eldarro/radio-isotope-vuv-light-source/Photos/IMG_1511.JPG

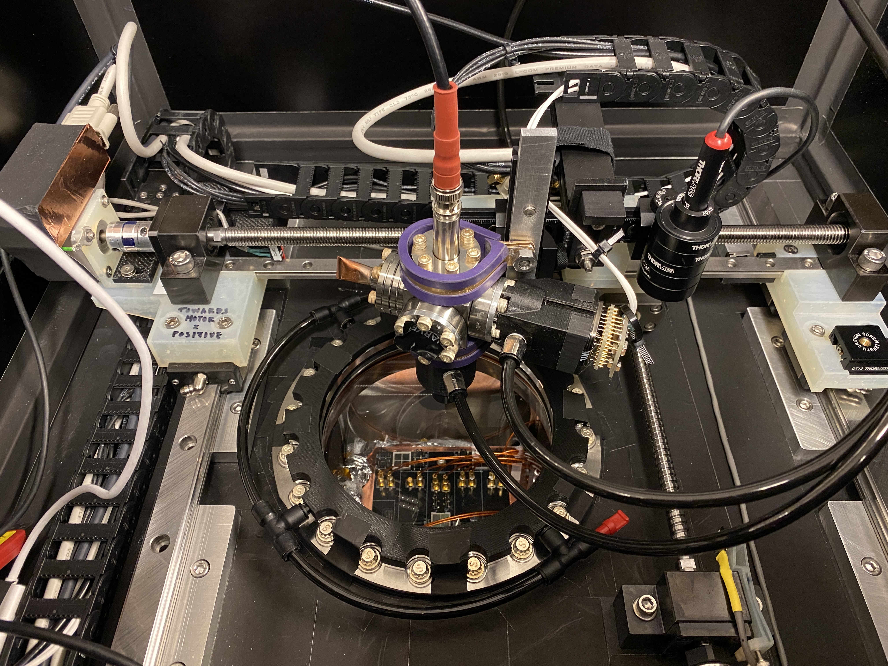
Photos/IMG_1511.JPG
