eldarro/radio-isotope-vuv-light-source/Gd-Source/documents/Report SEALED SOURCES -corrected- 15.02.23.pdf

Sealed Sources with current activity greater than 0MBq and received between 1/1/2000 and 2/14/202

3

McGill University | Environmental Health & Safety
PI382 | Prof Thomas Brunner

Cf-252

Inventory # | Permit | Receipt Date | Receipt Activity (MBq) | Current Activity (MBq) | Leak Test
180821001
| | | Eckert Ziegler | Q4-579

AF-252-A2

2018-06-08 | 0.00333 R-00382
☐ ⁰.00097
Location: | Manufacturer: | Model: Manufacturer S/N:

181025000
Eckert Ziegler | Q8-368

AF-252-A2

2018-10-25 | 0.00370 R-00382
☐ ⁰.00119
Location: | Manufacturer: | Model: Manufacturer S/N:

### Count of Sealed Sources for this Isotope:

2

Gd-148

Inventory # | Permit | Receipt Date | Receipt Activity (MBq) | Current Activity (MBq) | Leak Test
230202000
| | | Eckert Ziegler | V7-180

A-2

2023-02-01 | 0.00444 R-00382
☐ ⁰.00444
Location: | Manufacturer: | Model: Manufacturer S/N:

### Count of Sealed Sources for this Isotope:1

Po-210

Inventory # | Permit | Receipt Date | Receipt Activity (MBq) | Current Activity (MBq) | Leak Test
190815006
IAEA | NSPO210 NSPO210
2019-08-15 | 0.00037 R-00382
☐ ⁰.00000
Location: | Manufacturer: | Model: Manufacturer S/N:

### Count of Sealed Sources for this Isotope:1

Sr-90

Inventory # | Permit | Receipt Date | Receipt Activity (MBq) | Current Activity (MBq) | Leak Test
190815007
IAEA | NSSR90 NSSR90
2019-08-15 | 0.00037 R-00382
☐ ⁰.00034
Location: | Manufacturer: | Model: Manufacturer S/N:

### Count of Sealed Sources for this Isotope:1

Rev. 20120403 | | Total Count of Sealed Sources for All Isotopes:5
Printed on 2023-02-15 | Page 1 of 1
