eldarro/radio-isotope-vuv-light-source/Gd-Source/documents/IPL Form483_End Use Statement Rev I - CURRENT 11 AUG 2022.pdf

## END USE STATEMENT

IPL Form483 | Date Printed: 13-Sep-22
Revision: I | Page 1 of 2

NOTE: All lines must be completely filled in Roman letters and in English, wherever possible. No PO boxes; provide cross streets where only PO boxes are available.

### 1. CONSIGNEE / DISTRIBUTOR / IMPORTER INFORMATION (IF DIFFERENT FROM END USER)

NAME & JOB TITLE
(First Name, Middle Initial, Last Name)Joanna M. Boisvert
COMPANY NAME
Stuart Hunt & Associates Ltd.

## STREET ADDRESS 5949 Ambler Drive

VILLAGE / TOWN / CITY Mississauga

TELEPHONE 800-661-4591 | STATE / REGION / POSTAL CODE Ontario / L4W 2K2
FAX or E-MAIL sales@stuarthunt.com | COUNTRY Canada

## COMPANY WEBSITE www.stuarthunt.com

(if available)

### 2. END USER INFORMATION (PERSON WHO WILL BE USING THE PRODUCT)

NAME & JOB TITLE
(First Name, Middle Initial, Last Name)
COMPANY NAME | STREET ADDRESS
| VILLAGE / TOWN / CITY
TELEPHONE | STATE / REGION / POSTAL CODE
FAX or E-MAIL | COUNTRY
COMPANY WEBSITE
(if available)

### E & Z MODEL(S)/PRODUCT(S) ORDERED & INTENDED USE/APPLICATION

3.

4. - HAS AN IMPORT LICENSE BEEN REQUESTED? CHECK IF YES | AND ATTACH A COPY.
- HAS AN END USER FACILITY LICENSE BEEN REQUESTED? CHECK IF YES | AND ATTACH A COPY.

### - CHECK IF SOURCE (S) MAY BE RECEIVED EXEMPT AND AN IMPORT LICENSE IS NOT REQUIRED

### , PROVIDE THE CORRESPONDING REGULATION REFERENCE _________________________

### 5. STATEMENT OF END USER

In accordance with the terms of the contract, we confirm the following:
- We acknowledge that all end users must be checked against the restricted party lists, including, but not limited to, those issued by BISor OFAC; https://www.trade.gov/consolidated-screening-list.
- We will not distribute or re-route goods to known denied entities and we understand that doing so without a BIS, OFAC, or NRC license could constitute a violation and the possible loss of the business relationship with Eckert & Ziegler.
- If required for countries of concern, we will provide Eckert & Ziegler an import license and / or facility license as applicable.
- We will provide Eckert & Ziegler all applicable licenses and permits upon request for auditing purposes.
- The goods will not be re-routed or exported to US embargoed countries unless specifically licensed: . The US embargoed countries include Cuba, Iran, Iraq, North Korea, Sudan, and Syria [Ref. US NRC 10 CFR 110.28].We will not sell or re-route byproduct material imported from the US or of US origin to Pakistan, nor any radioactive material imported from the US or of US origin to Russia without a US export license; as per the NRC’s Executive Branch Order suspending all exports of said radioactive material under the General License authority
[Ref.: US NRC Docket No. EA-20-044; NRC-2020-0095 and EA-22-038, NRC-2022-0112], respectively.
- We will not re-sell and/or re-export products containing Special Nuclear Material (plutonium, uranium-233, or uranium enriched in the isotopes uranium-233 or uranium-235) in countries classified under restricted destinations (Afghanistan, Andorra, Angola, Burma (Myanmar), Djibouti, India, Israel, Pakistan, South Sudan and Libya) unless specifically licensed [Ref. US NRC 10 CFR 110.29].
- The goods are properly licensed and approved for use at the address in Section 2 by the end-user.
- The goods will not be exported or re-exported to China General Nuclear (CGN) and / or its subsidiaries should they be subject to a presumption of denial per US Policy Framework on Civil Nuclear Corporation with China or unless specifically licensed [Ref.: US NRC 10
CFR 110].

## END USE STATEMENT

IPL Form483 | Date Printed: 13-Sep-22
Revision: I | Page 2 of 2
- The goods, or a replica of them will not be used for purposes associated with military, chemical, biological, or nuclear weapons, explosives, or missile production or for missiles capable of delivering such weapons.
- We understand that exports of goods for Military End Uses or to Military End Users to Belarus, the People’s Republic of China (including Hong Kong), Cambodia, Myanmar (Burma), Russia (including Ukraine-Crimea Region) and Venezuela, may require export licensing prior to distribution [Ref.: EAR 15 CFR 744.21 and 15 CFR 744.22]. We will contact Eckert & Ziegler, NRC, OFAC, or BIS should export licenses be needed.
- All of the facts contained in this statement are true and correct to the best of our knowledge. We do not know of any additional facts which would be inconsistent with the above. We shall promptly communicate with, and send a supplemental statement to Eckert & Ziegler, disclosing any changes which would contradict the facts or intentions set forth in this document, if these occur after it has been accepted by Eckert & Ziegler.
We understand that the “goods” subject to NRC, OFAC, and BIS export regulations include, but are not limited to, radioactive materials, sealed sources, technology, confidential information, drawings, equipment, product development, and other products or services not specifically stated in this document but may be part of the contractual agreement.
PRINT NAME and SIGNATURE OF END USER / END USER LEGAL REPRESENTATIVE

DATE:
