eldarro/radio-isotope-vuv-light-source/Gd-Source/documents/QT-44482-1.pdf

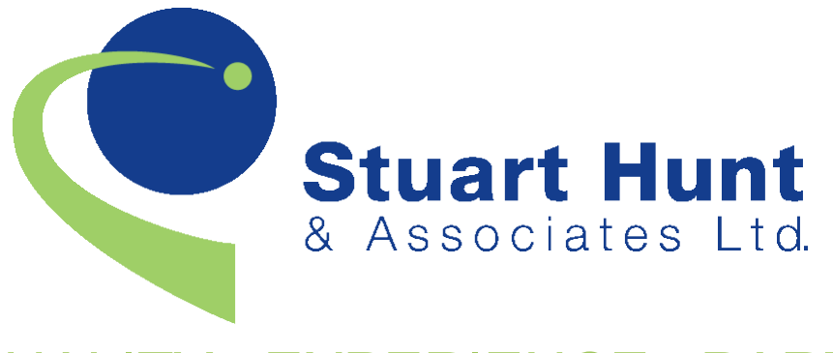
[picture p27: figure]

## QUALITY ∙ EXPERIENCE ∙ PARTNERSHIPS

To: Thomas Brunner | Prepared by: | Donna Akinola
McGill University | Email: donna.akinola@stuarthunt.com
McGill Hazardous Waste Managem 3655 Sir William Osler, Rm 129 Montreal, QC H3G 1Y6 | Phone: | 800-661-4591 ext 231

## Radioactive Source Quote

Part No. | Description | Unit Price | Quantity | Extended
AF-148-A2 | Alpha Particle Standard - Type A2 | 5,884.00 | 1 | 5,884.00
| Gd-148 3.70 kBq ( 0.10 uCi ) Activity Tolerance: +30% / -30% Capsule: A1204-1 Type A2 Disk 12.7mm OD x 5mm AD Electroplated onto Platinum Surface, No Cover Calibrated, NIST Traceable
| | | Total: | $5,884.00

## Please note:

### - Estimated delivery: 8 Weeks ARO

## - FOB: Mississauga, ON

- Please provide a preferred courier and account number on your order for shipping the items listed above to your designated location from our warehouse. Prepaid shipping is available upon request; the cost of shipping will then be added to your invoice.

### - Quote is in Canadian Dollars

- The End User’s name, contact information and intended use of the sources quoted is required at the time that an order is placed.
- A current copy of your CNSC license is required along with the purchase order.
- All sales are final and no item can be returned for credit unless the customer has demonstrated that the product does not meet the specifications set forth in the purchase order. For isotope products that are subject to radiation decomposition of 1% or more per month, or which possess half-lives of 90 days or less, claims must be made not later than 14 days from the delivery date.
- Please refer to attached Terms & Conditions for details.

Stuart Hunt & Associates Ltd. will undertake to provide the service described above for the price(s) presented in accordance with the Terms & Conditions attached to this quotation. Applicable taxes have not been included with the above quoted price. The price(s) are in Canadian dollars and will be honoured until the specified expiry date.

# Quotation No: QT-44482/1

## Quotation Date: October 17, 2022 Expiration date: November 16, 2022

## Terms and Conditions

Applicability

An order placed for instrumentation shall be subject to these Terms and Conditions to the exclusion of all other Conditions, including any terms or conditions which the Client purports to apply under any purchase order, confirmation of order, specification or other document).
Each order for instrumentation by the Client shall be on an Order Form and shall be deemed to be an offer by the Client to purchase instrumentation subject to these Conditions.
In the event the required quantity or make/model changes, a re-quotation by Stuart Hunt & Associates Ltd. will be delivered to the Client to address the change.
Pricing and Payment
Payment in advance is required for all first time Clients. Payment may be made by VISA, MasterCard, cheque, bank draft or wire transfer. Work will not commence until payment is received.
Credit terms are available to Canadian customers to enable payment by purchase order payable through invoicing, which requires completion of a short, no-fee credit application.
For Clients with approved credit, payment of the price for the Goods is due within 30 days of the invoice date. A purchase order, accepted credit card or other method of payment is required before work can proceed.
Customers in Canada are charged applicable taxes.
Applicable taxes have not been included with the above quoted price. Stuart Hunt and Associates' GST Registration Number is R105049225. Prices are subject to change under exceptional circumstances including manufacturer price changes and foreign exchange fluctuations. Every effort will be made to honour pricing as quoted. Stuart Hunt & Associates is not responsible for typographical or stenographic errors and we reserve the right to not accept any orders found to contain errors.
Supply of Service
No order placed by the Client shall be deemed to be accepted by Stuart Hunt & Associates Ltd. until a written acknowledgement of the order is issued by Stuart Hunt & Associates Ltd.
An official purchase order is required to be received by Stuart Hunt & Associates Ltd. before any orders can be confirmed. Any orders remain unconfirmed until notified otherwise.
Quotations are given by Stuart Hunt & Associates Ltd. on the basis that no Contract shall come into existence until a written acknowledgement of order is issued by Stuart Hunt & Associates Ltd.
Stuart Hunt & Associates Ltd. will deliver the instrumentation ordered by the Client to the address for delivery specified in the Order Form. Any changes or additions to the Order or these Conditions must be agreed upon in writing between Stuart Hunt & Associates Ltd. and the Client.
Installation & Training
Unless otherwise stated, all installation and training is extra. Installation is only available on selected items and in selected locations. All costs are extra and must be quoted separately and in writing. Remote support is offered (by Stuart Hunt & Associates Ltd. or Manufacturer) for all items, based on phone, fax, or e-mail communications. If you have any questions, please contact the Stuart Hunt & Associates sales consultant for your region.

Delivery Times
Most items requiring calibration or configuration are built to order. This generally requires a delivery time of 45 days for Canadian orders. Some items, such as some supplies and parts, are carried in inventory and can usually ship within 1-3 business days. Stuart Hunt & Associates Ltd. is not responsible for production delays by the manufacturer or delays in shipping or border crossings. Every effort will be made to expedite the process. Express shipping is available at extra cost.
Shipping & Handling
All shipping and handling charges are extra unless specifically stated otherwise in writing.
FOB: Standard orders are shipped FOB Mississauga, Ontario. Other arrangements can be made, including insured shipments, for additional cost.
Shipping Method: All shipments (except drop shipments) are carefully inspected at Stuart Hunt & Associates. Domestic shipments are delivered via ground courier. A preferred courier and account number are required but pre-paid shipping is available and the cost will be added to the invoice. Please specify the shipping preference upon ordering.
Heavy shipments and dangerous goods are shipped domestically by truck, internationally by the most economical option available, or customer specified courier. Special Arrangements: Rush shipments and insurance are available at extra cost. Dangerous goods and heavy shipments may incur extra courier and/or crating fees.
Returns Policy
Products purchased from Stuart Hunt & Associates Ltd. can be returned up to 15 days from the date of shipment (subject to following conditions). Products must be returned as shipped, in like new condition with original packing materials, including manuals and accessories.
All products sold through Stuart Hunt & Associates are sold to the specifications shown in the product description. Stuart Hunt & Associates is under no obligation to accept returns on products that meet the published specifications.
No returns or credits are permitted on custom manufactured or configured products.
Returns Process for Equipment
All returns must be authorized in writing by Stuart Hunt & Associates. Call us for a Return Authorization Form. This form must be included with the returned goods. Returns must be shipped prepaid by the Client to Stuart Hunt & Associates FOB Mississauga, Ontario.
A minimum 15% restocking fee (more for some manufacturers) will be charged for all returns unless covered under warranty.
If any of these requirements are not met, delays or extra costs could be incurred. Stuart Hunt & Associates Ltd. does not take responsibility for these issues if caused by customer neglect, error or deviation from these policies.
Returns Policy for Radioactive Sources
Due to the nature of our products, all sales are final and no item can be returned for credit unless the customer has demonstrated that the product does not meet the specifications set forth in the purchase order. For most products, such a claim must be made within 21 days of the date of delivery of the item ("date of delivery" is defined as the shipment date indicated on the airway bill for the goods). For isotope products that are subject to radiation decomposition of 1% or more per month, or which possess half-lives of 90 days or less, claims must be made not later than 14 days from the delivery date.

Credit will be given for products that are found not meeting specifications. Stuart Hunt & Associates Ltd. will pay the return freight back to the manufacturer for materials found not meeting specifications, as well as freight for replacement products.

Damaged Items
All instruments are packaged carefully at Stuart Hunt & Associates for return shipment. For goods received in a damaged condition by the delivery company, please follow this procedure:
1. Note the damage to the delivery driver and immediately report the damage to the delivery company.
2. Keep all original packaging materials for inspection and possible repackaging.
3. Report the damage to Stuart Hunt & Associates Ltd. in writing within 2 days of receipt and provide a copy of carrier’s report of damage when available.
4. Some shipments may have carrier insurance. Claims are contingent upon the above procedures being followed Warranty and Limitation on Liability
All products sold through Stuart Hunt & Associates are inspected through quality control by the manufacturer and again for damage and basic functionality at Stuart Hunt & Associates. If a product should fail to function properly within the manufacturer’s warranty period, please contact us. The representative for your region will advise you on how to proceed. Depending on the assessment, this could include any of:
1. On-site repair
2. Returning the item for repair
3. Replacement of the item
4. Possible loaner unit during the repair
The solution will depend upon the manufacturer’s policies, the location of the customer, plus the size, weight and type of product.
Stuart Hunt & Associates Ltd. shall have no liability to the Client for any failure to deliver the instrumentation or any delay in doing so that is caused by an event or circumstance beyond Stuart Hunt & Associates Ltd. reasonable control including, without limitation, strikes, lock-outs and other industrial disputes, travel disruption, or accident.
Stuart Hunt & Associates Ltd. warranties and services extend to the Client and to no other person or entity. Stuart Hunt & Associates Ltd. has no duty or obligation to provide services that it has not expressly agreed in writing to provide.
Invalidity
If any of these Conditions (or part of any of these Conditions) is unenforceable (including any provision in which Stuart Hunt & Associates Ltd. excludes its liability to the Client) the enforceability of the remaining Conditions (or remaining part of any Condition) will not be affected.
Waiver
In the event of any default or breach by the Client, Stuart Hunt & Associates Ltd. has the right, among other rights, to refuse to provide additional services to the Client. Stuart Hunt & Associates Ltd. failure to enforce at any time or for any period of time any provisions of these Terms and Conditions shall not constitute a waiver of such provisions or of the right of Stuart Hunt & Associates Ltd. to enforce each and every such provision.
