eldarro/radio-isotope-vuv-light-source/lenses.png

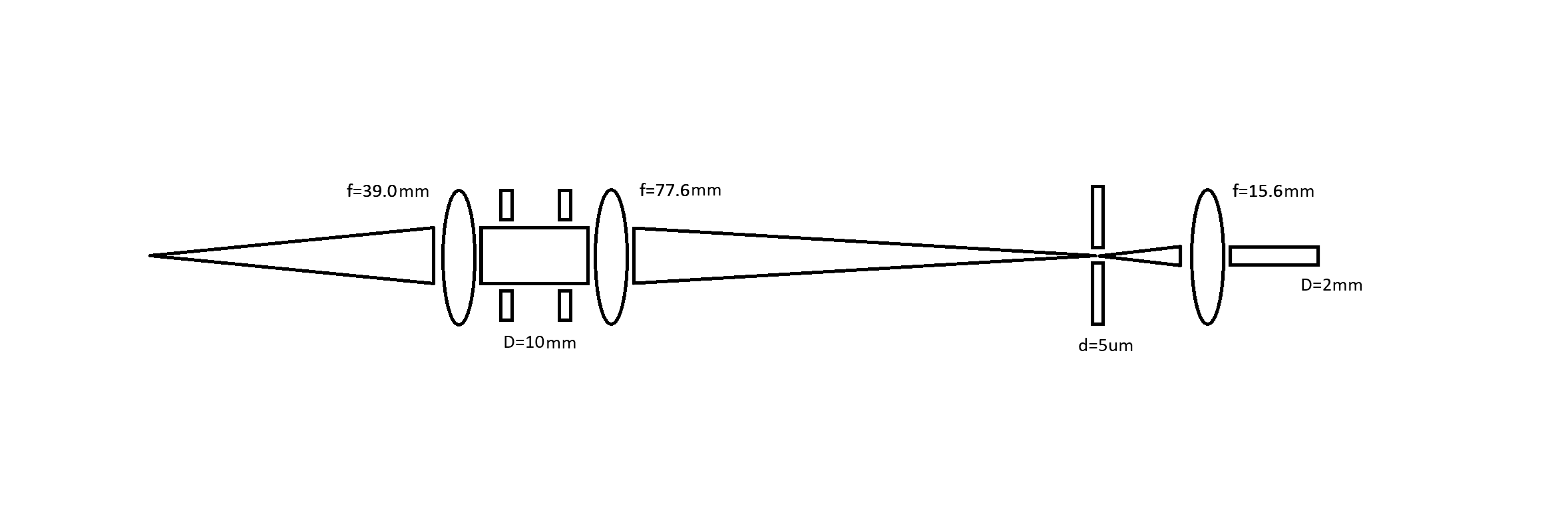
lenses.png
