eldarro/radio-isotope-vuv-light-source/Photos/IMG_1506.JPG

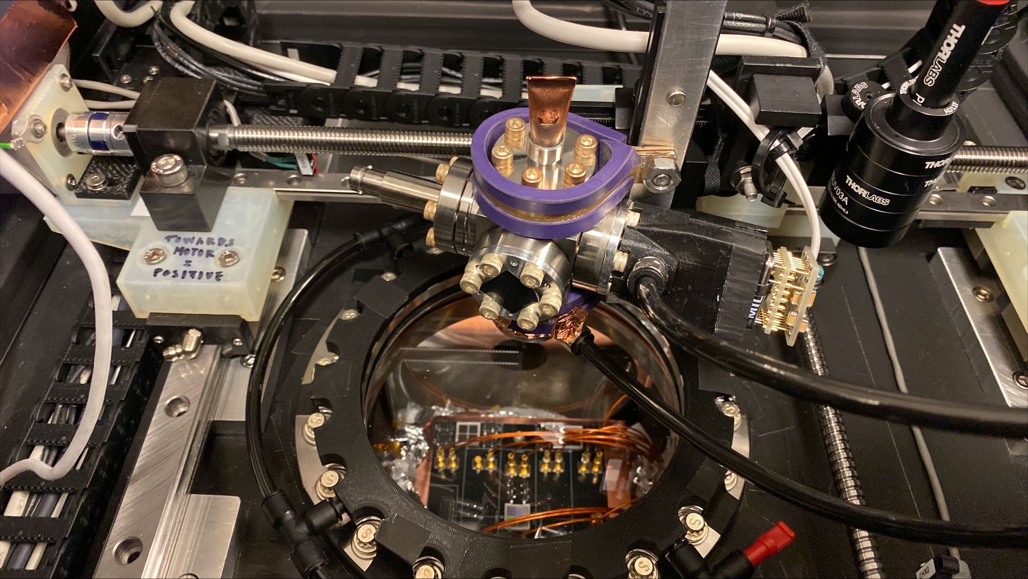
Photos/IMG_1506.JPG
