eldarro/radio-isotope-vuv-light-source/Photos/IMG_1510.JPG

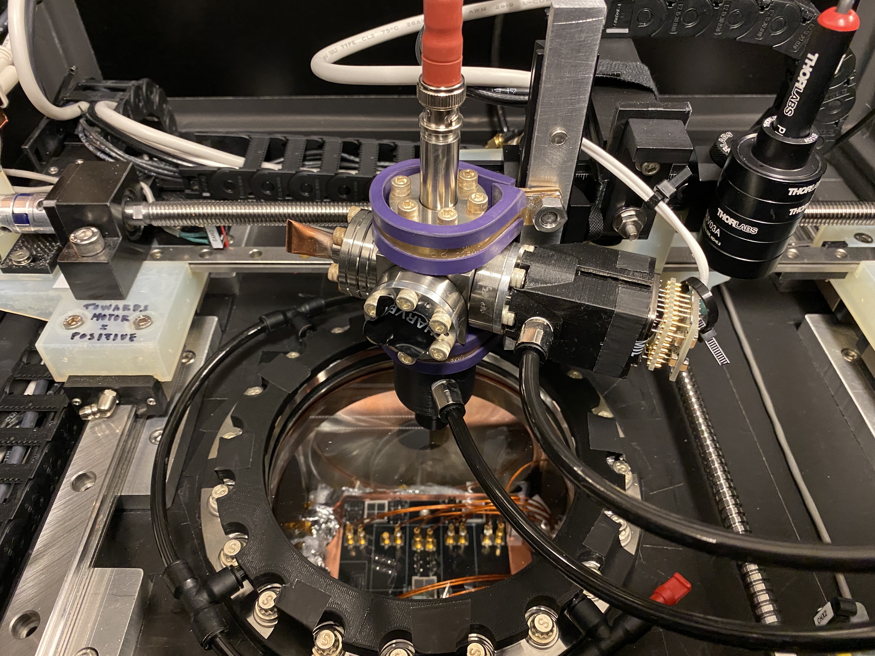
Photos/IMG_1510.JPG
