eldarro/radio-isotope-vuv-light-source/Photos/IMG_1512.JPG

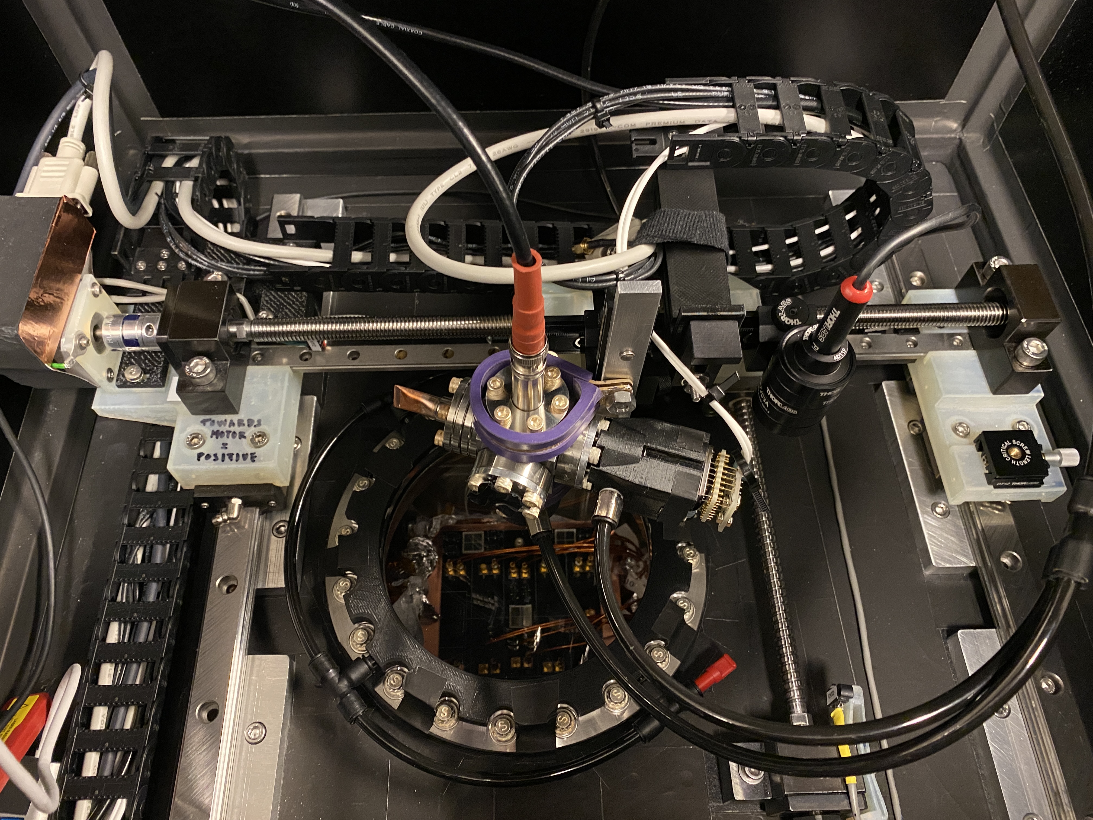
Photos/IMG_1512.JPG
