eldarro/radio-isotope-vuv-light-source/spatial_filter.png

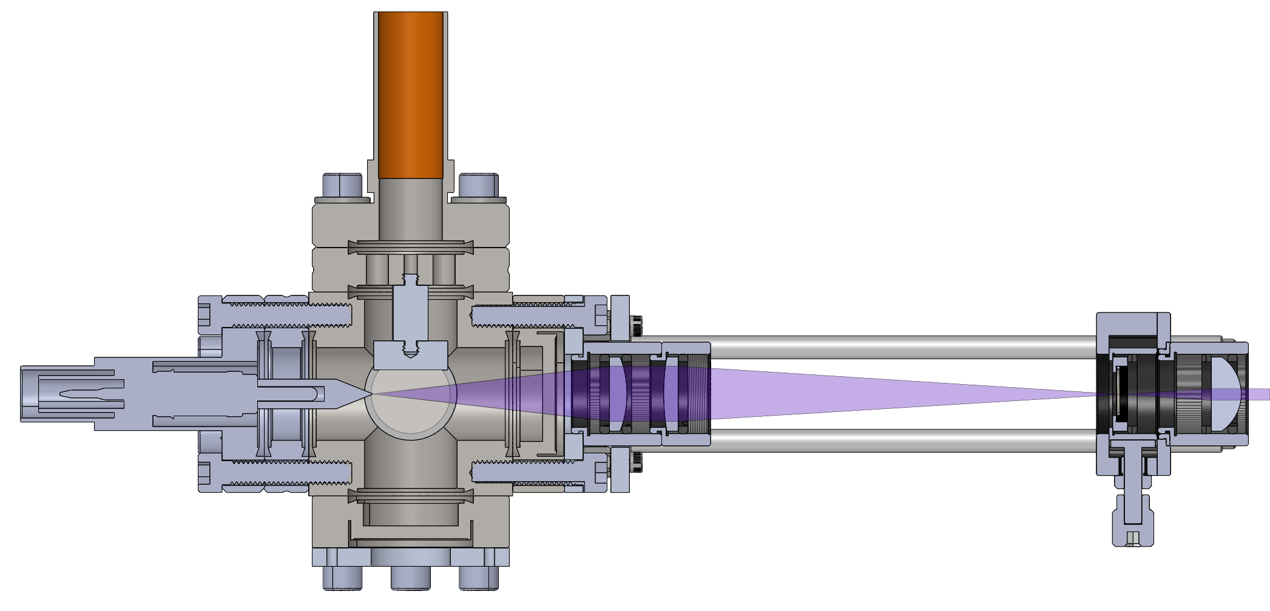
spatial_filter.png
