eldarro/radio-isotope-vuv-light-source/Gd-Source/CAD/GDLS/GDLS08.SLDASM

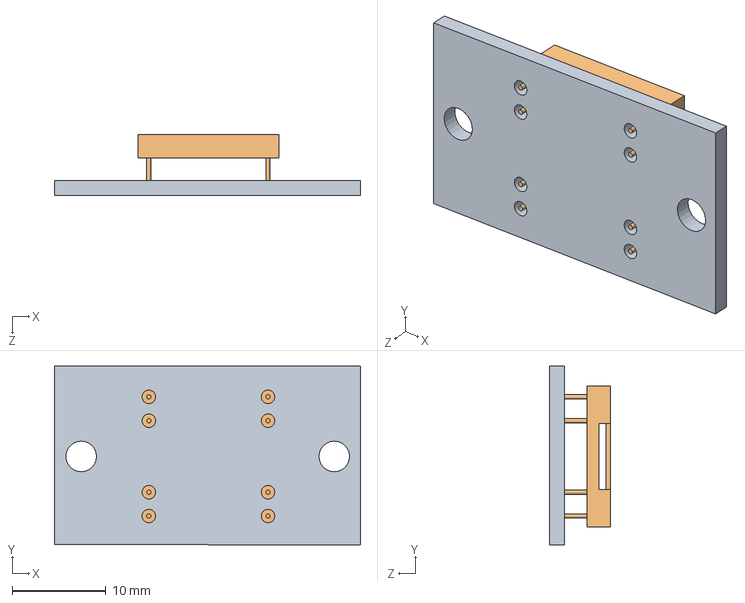
[picture p33: CAD file, 2026-06-09]
Gd-Source/CAD/GDLS/GDLS08.SLDASM
32.6 x 19.1 x 6.50 mm
GDLS034
GDLS022
