eldarro/radio-isotope-vuv-light-source/Gd-Source/CAD/CFLS/CFLS0009.SLDASM

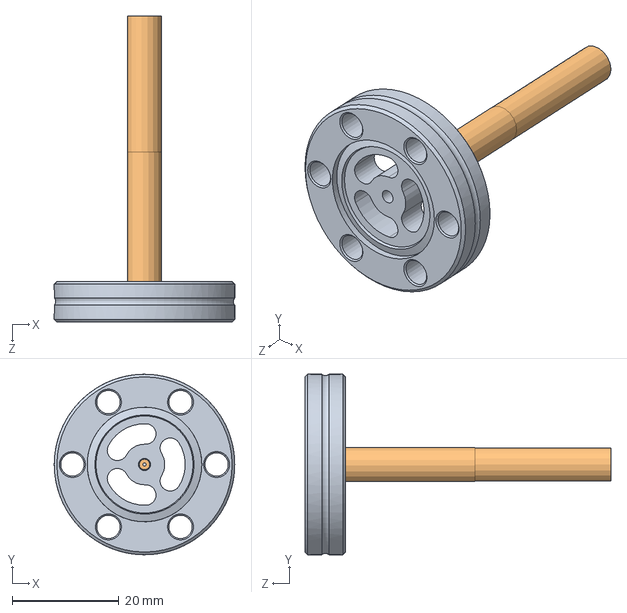
[picture p34: CAD file, 2026-06-09]
Gd-Source/CAD/CFLS/CFLS0009.SLDASM
33.8 x 33.8 x 57.3 mm
CFLS0007
CFLS0008 x 2
