eldarro/radio-isotope-vuv-light-source/Gd-Source/SIM/CAD/GDSIM12.SLDASM

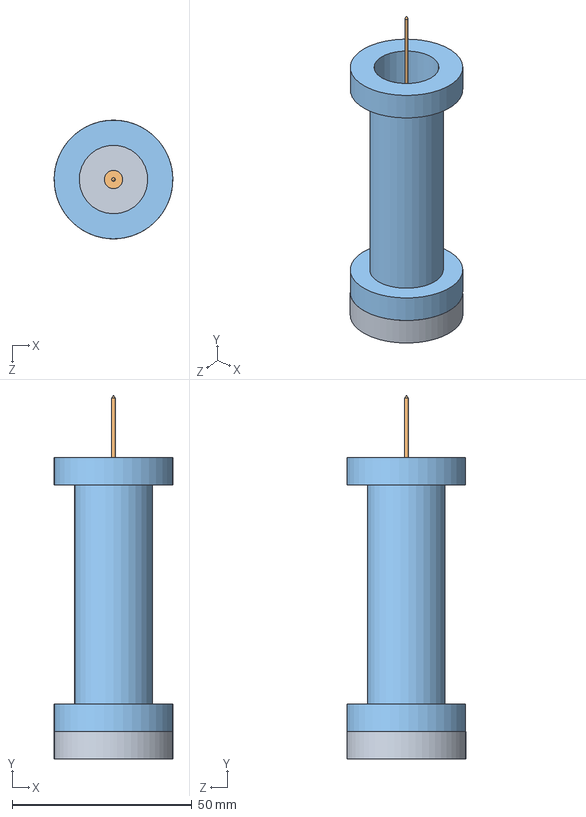
[picture p36: CAD file, 2026-06-09]
Gd-Source/SIM/CAD/GDSIM12.SLDASM
33.0 x 101.2 x 33.0 mm
GDSIM011
GDSIM014
GDSIM015
