eldarro/radio-isotope-vuv-light-source/Gd-Source/CAD/CFLS/CFLS0000.SLDASM

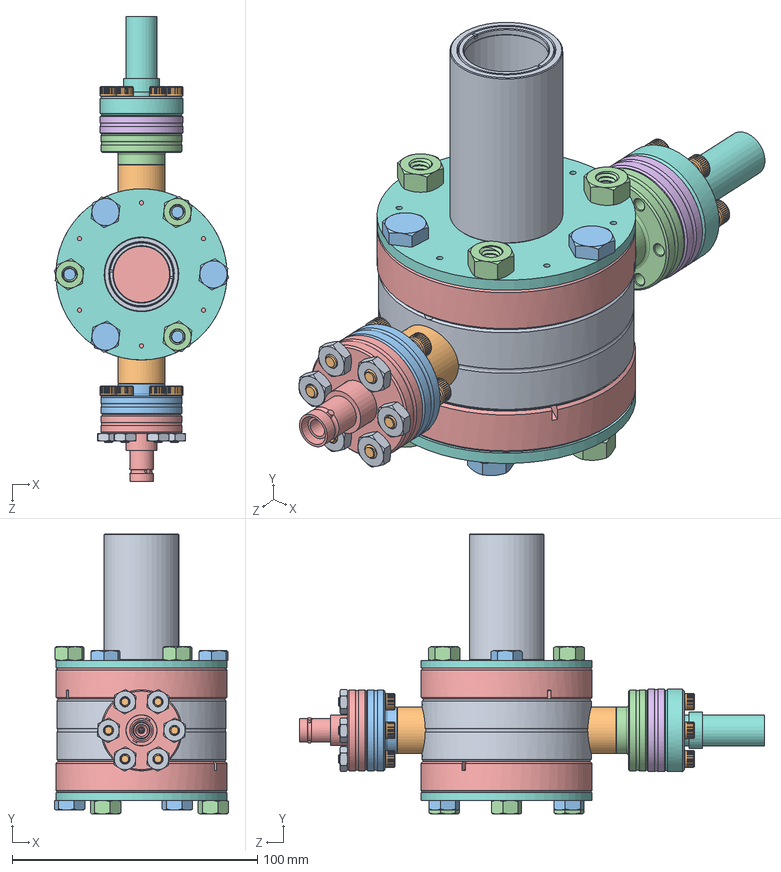
[picture p37: CAD file, 2026-06-09]
Gd-Source/CAD/CFLS/CFLS0000.SLDASM
71.2 x 114.3 x 189.9 mm
CFLS0002
CFLS0003 x 2
CFLS0004
CFLS0005
CFLS0006
CFLS0007
CFLS0008 x 2
CFLS0017
CFLS0018 x 6
CFLS0019 x 12
CFLS0021 x 6
CFLS0022 x 6
CFLS0023 x 2
CFLS0025
CFLS0024
CFLS0026 x 2
CFLS0027
