eldarro/radio-isotope-vuv-light-source/Gd-Source/CAD/GDLS/GDLS07.SLDASM

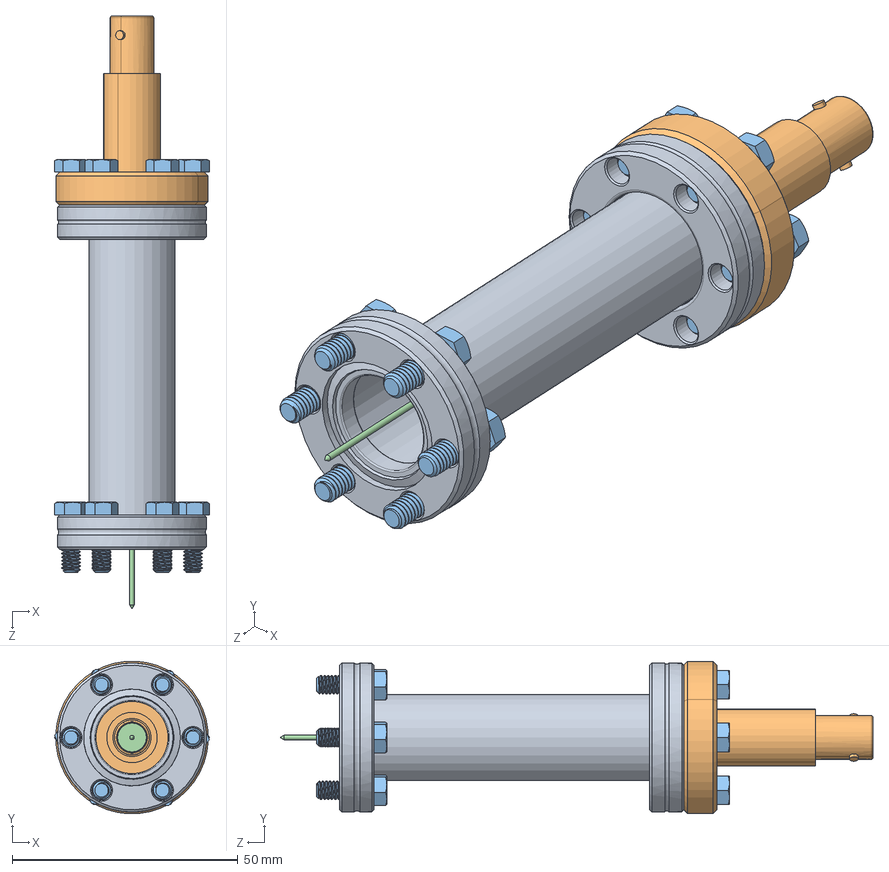
[picture p38: CAD file, 2026-06-09]
Gd-Source/CAD/GDLS/GDLS07.SLDASM
34.3 x 33.7 x 131.2 mm
GDLS030
GDLS008
GDLS025 x 12
GDLS031
