eldarro/radio-isotope-vuv-light-source/Gd-Source/SIM/CAD/GDSIM10.SLDASM

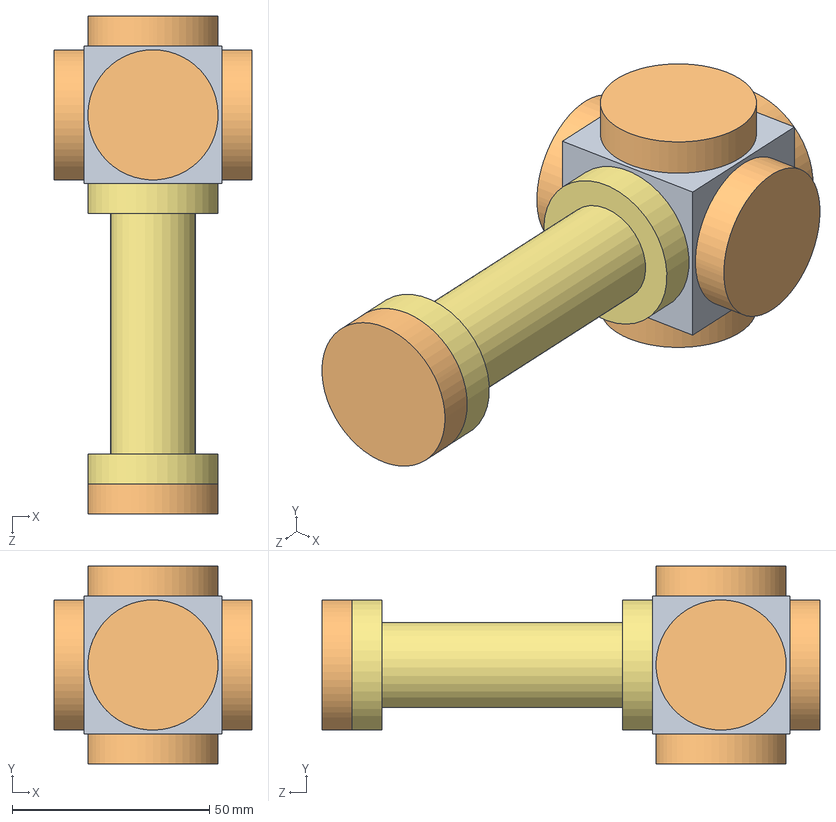
[picture p39: CAD file, 2026-06-09]
Gd-Source/SIM/CAD/GDSIM10.SLDASM
50.2 x 50.2 x 126.4 mm
GDSIM010
GDSIM011 x 6
GDSIM016
GDSIM012
GDSIM013
GDSIM014
GDSIM015
Part9^GDSIM10
