eldarro/radio-isotope-vuv-light-source/Gd-Source/SIM/CAD/Assem2.SLDASM

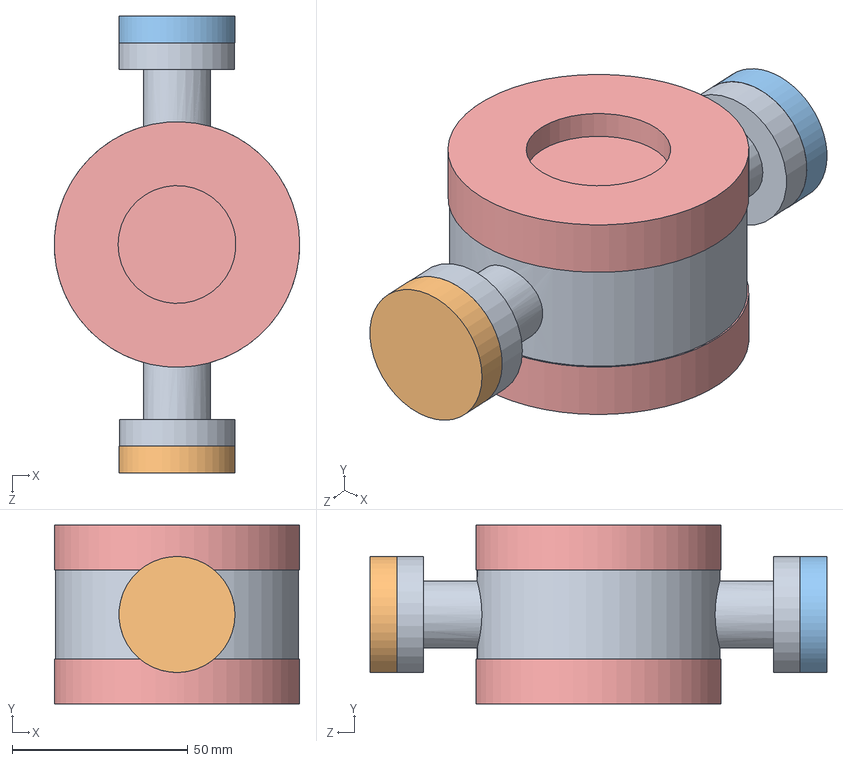
[picture p41: CAD file, 2026-06-09]
Gd-Source/SIM/CAD/Assem2.SLDASM
69.8 x 50.8 x 130.0 mm
GDSIM001
GDSIM002
GDSIM003
GDSIM007
GDSIM005 x 2
Part1^Assem2
