eldarro/radio-isotope-vuv-light-source/Gd-Source/CAD/GDLS/GDLS04.SLDASM

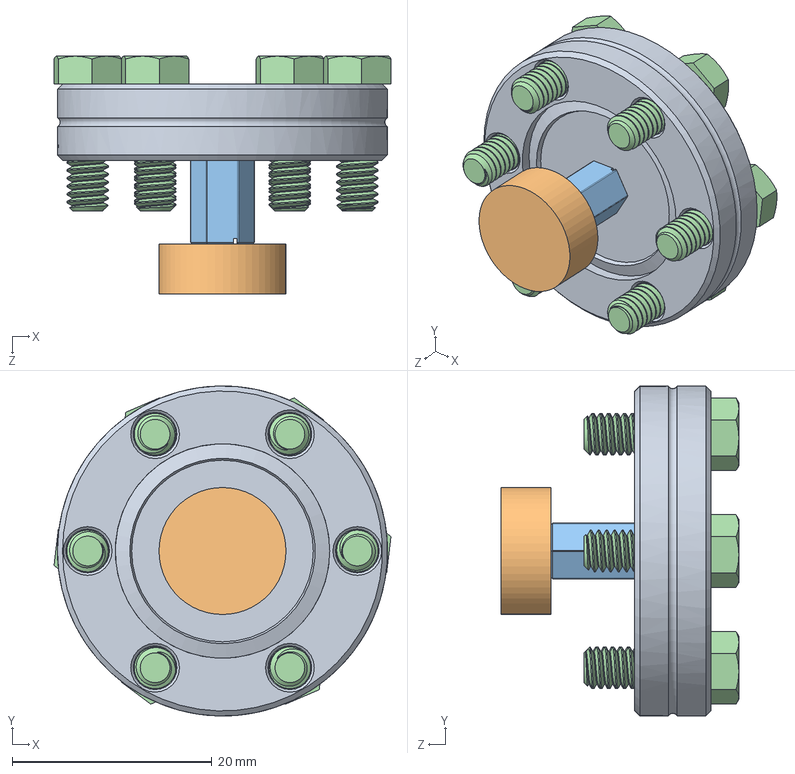
[picture p42: CAD file, 2026-06-09]
Gd-Source/CAD/GDLS/GDLS04.SLDASM
33.7 x 33.0 x 23.8 mm
GDLS010
GDLS011
GDLS012
GDLS025 x 6
