eldarro/radio-isotope-vuv-light-source/Gd-Source/SIM/CAD/GDSIM20.SLDASM

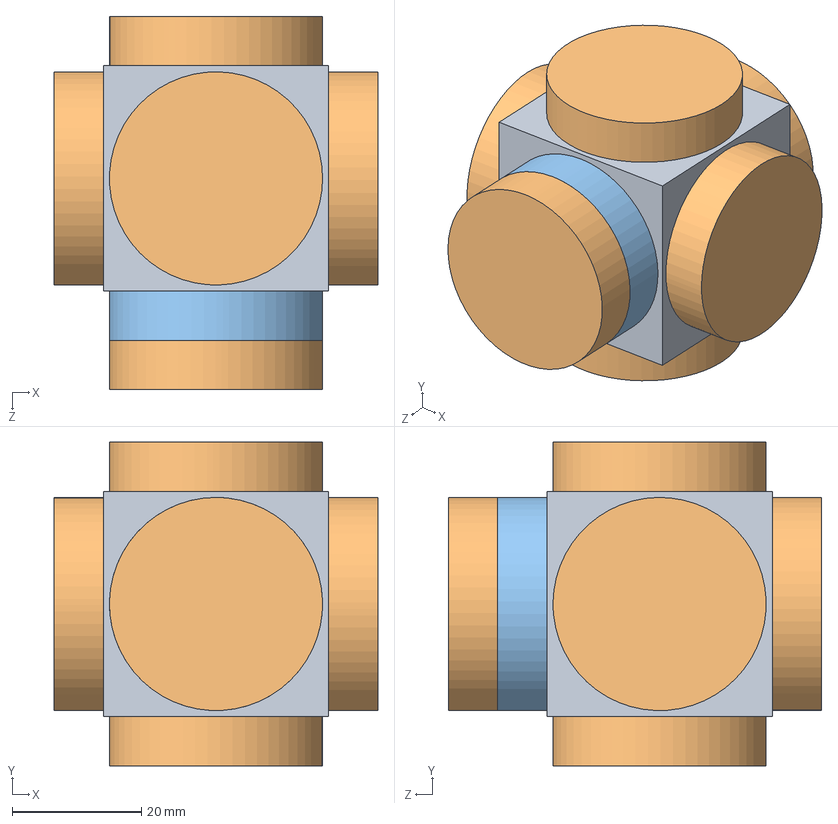
[picture p43: CAD file, 2026-06-09]
Gd-Source/SIM/CAD/GDSIM20.SLDASM
50.2 x 50.2 x 57.8 mm
GDSIM010
GDSIM011 x 6
GDSIM017
GDSIM018
GDSIM019
GDSIM012
GDSIM013
GDSIM016
Part3^GDSIM20
