eldarro/radio-isotope-vuv-light-source/Gd-Source/CAD/CFLS/CFLS0010.sldasm

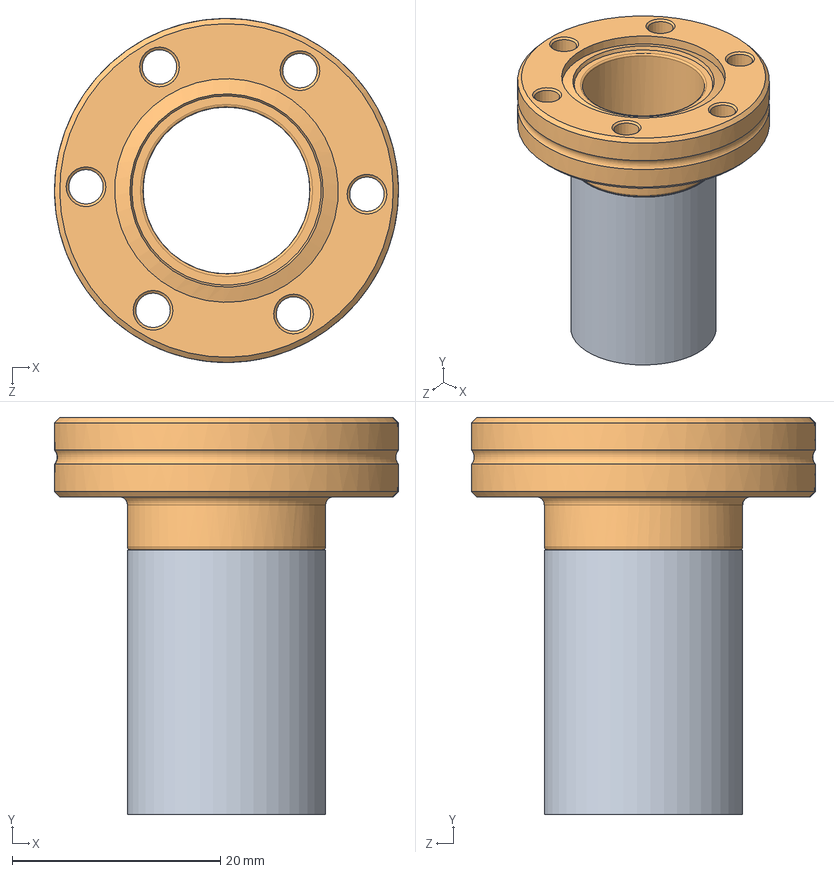
[picture p44: CAD file, 2026-06-09]
Gd-Source/CAD/CFLS/CFLS0010.sldasm
33.0 x 38.1 x 33.0 mm
CFLS0003
CFLS0005
