eldarro/radio-isotope-vuv-light-source/Gd-Source/SIM/CAD/GDSIM21.SLDASM

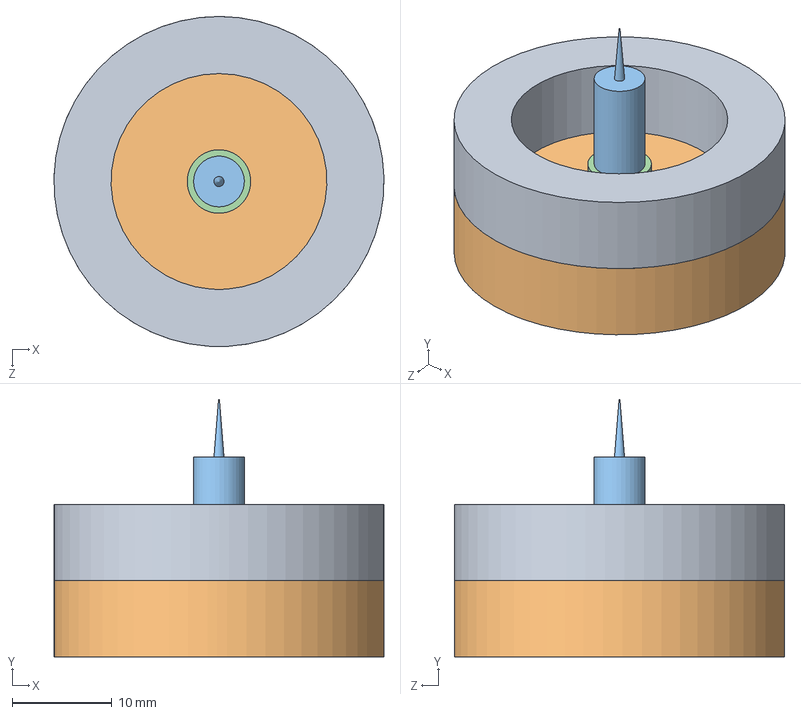
[picture p45: CAD file, 2026-06-09]
Gd-Source/SIM/CAD/GDSIM21.SLDASM
33.0 x 25.8 x 33.0 mm
GDSIM017
GDSIM011
GDSIM018
GDSIM019
