eldarro/radio-isotope-vuv-light-source/Gd-Source/SIM/CAD/GDSIM11.SLDASM

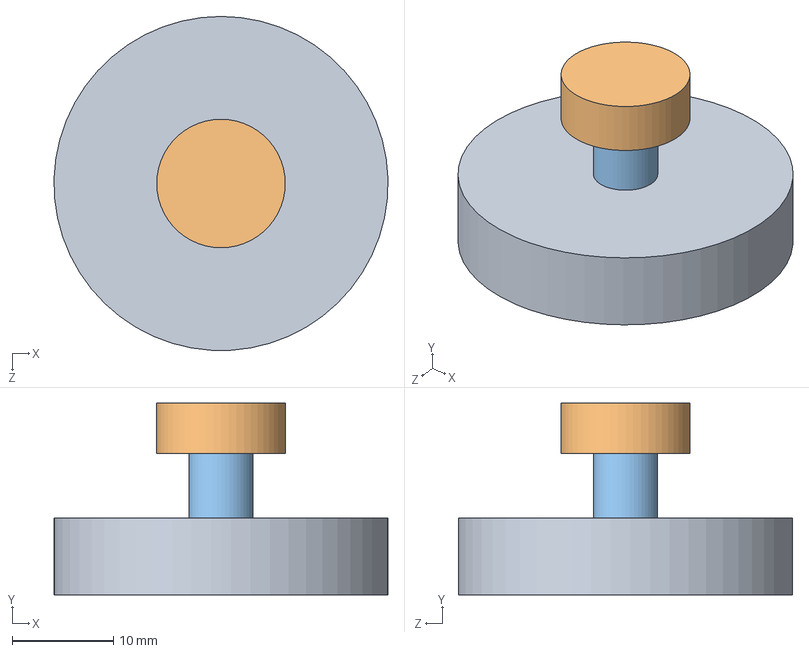
[picture p46: CAD file, 2026-06-09]
Gd-Source/SIM/CAD/GDSIM11.SLDASM
33.0 x 19.0 x 33.0 mm
GDSIM011
GDSIM012
GDSIM013
