eldarro/radio-isotope-vuv-light-source/Gd-Source/CAD/CFLS/CFLS0001.sldasm

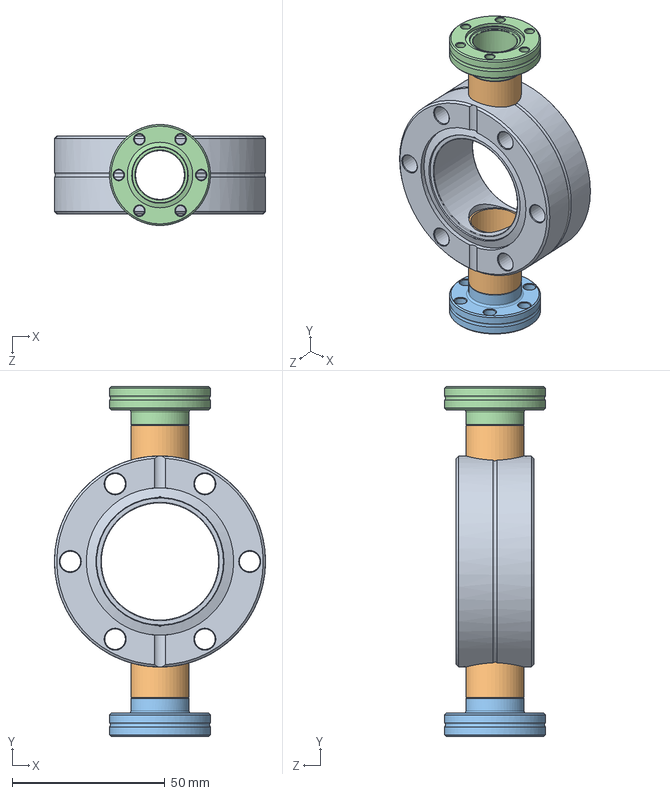
[picture p47: CAD file, 2026-06-09]
Gd-Source/CAD/CFLS/CFLS0001.sldasm
69.1 x 114.6 x 33.0 mm
CFLS0002
CFLS0003 x 2
CFLS0004
CFLS0005
