eldarro/radio-isotope-vuv-light-source/Gd-Source/CAD/CFLS/CFLS00.SLDASM

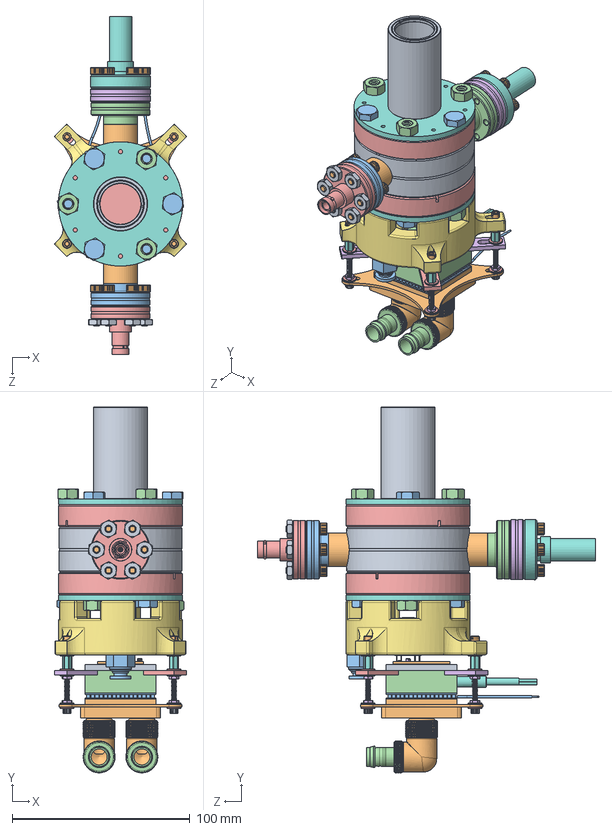
[picture p48: CAD file, 2026-06-09]
Gd-Source/CAD/CFLS/CFLS00.SLDASM
74.4 x 205.6 x 189.9 mm
CFLS0002
CFLS0003 x 2
CFLS0004
CFLS0005
CFLS0006
CFLS0007
CFLS0008 x 2
CFLS0017
CFLS0018 x 6
CFLS0019 x 12
CFLS0021 x 6
CFLS0022 x 6
CFLS0023 x 2
CFLS0025
CFLS0024
CFLS0026 x 2
CFLS0027
TEC016
TEC003
TEC019
TEC044
TEC036
TEC046 x 5
TEC011
TEC026
CAF022
TEC045 x 4
TEC041 x 4
TEC039 x 4
TEC040
TEC017 x 2
TEC024 x 20
TEC010 x 8
GDLS028 x 5
