eldarro/radio-isotope-vuv-light-source/Gd-Source/CAD/GDLS/GDLS05.SLDASM

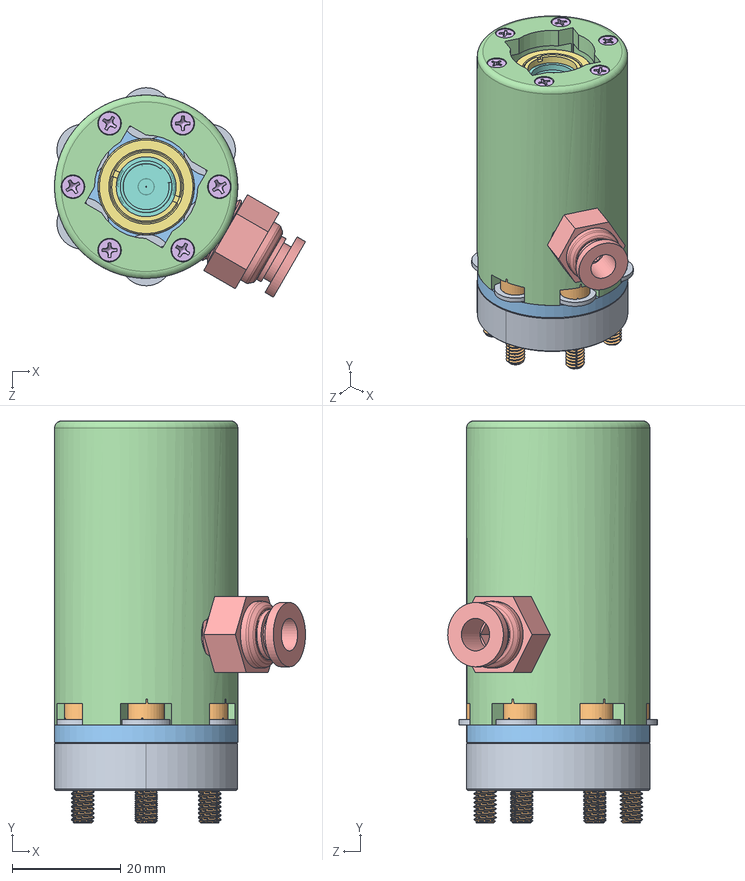
[picture p49: CAD file, 2026-06-09]
Gd-Source/CAD/GDLS/GDLS05.SLDASM
46.2 x 74.1 x 38.6 mm
GDLS002
GDLS044 x 6
GDLS003
GDLS033
GDLS020
GDLS028 x 6
GDLS036
GDLS005 x 2
GDLS045 x 6
