eldarro/radio-isotope-vuv-light-source/Gd-Source/CAD/GDLS/GDLS03.SLDASM

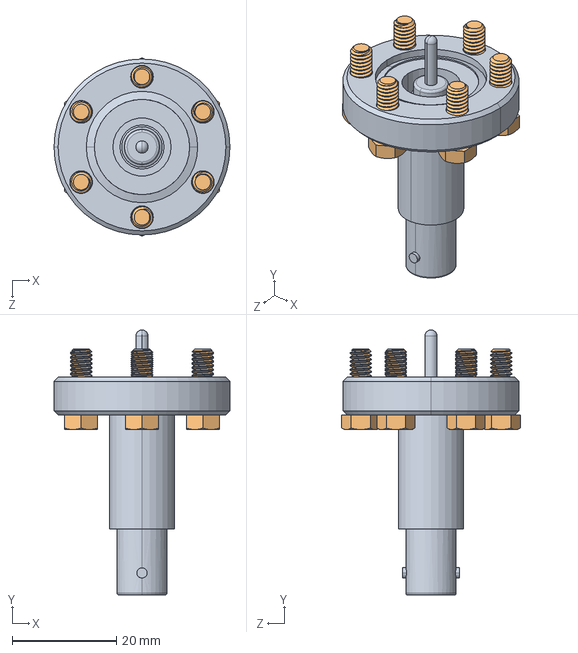
[picture p50: CAD file, 2026-06-09]
Gd-Source/CAD/GDLS/GDLS03.SLDASM
33.8 x 50.9 x 34.3 mm
GDLS008
GDLS025 x 6
