eldarro/radio-isotope-vuv-light-source/Gd-Source/CAD/GDLS/GDLS10.SLDASM

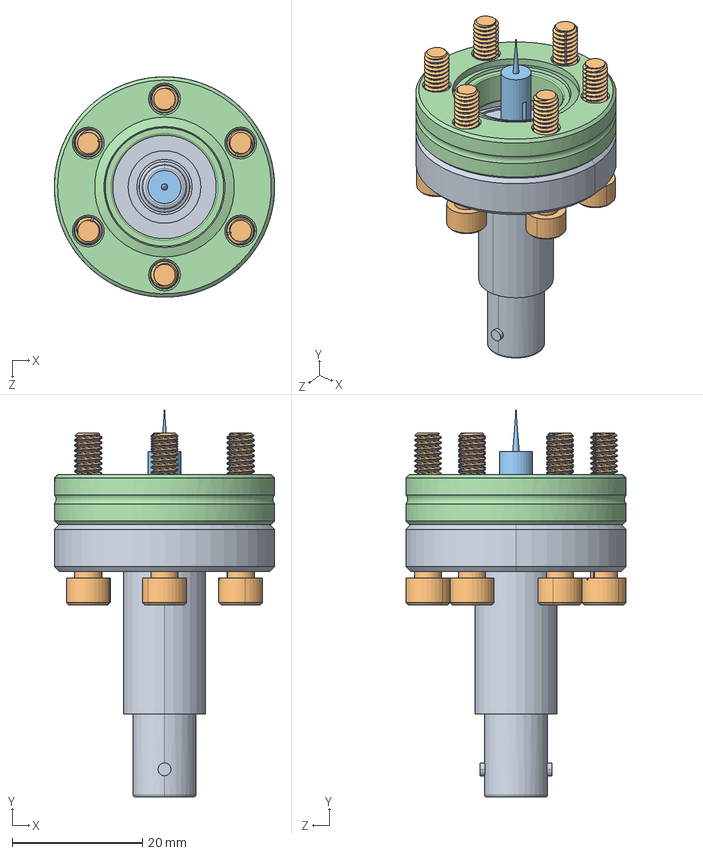
[picture p51: CAD file, 2026-06-09]
Gd-Source/CAD/GDLS/GDLS10.SLDASM
33.8 x 59.3 x 33.8 mm
GDLS039
GDLS043 x 6
GDLS040
GDLS041
