eldarro/radio-isotope-vuv-light-source/Gd-Source/CAD/GDLS/GDLS09.SLDASM

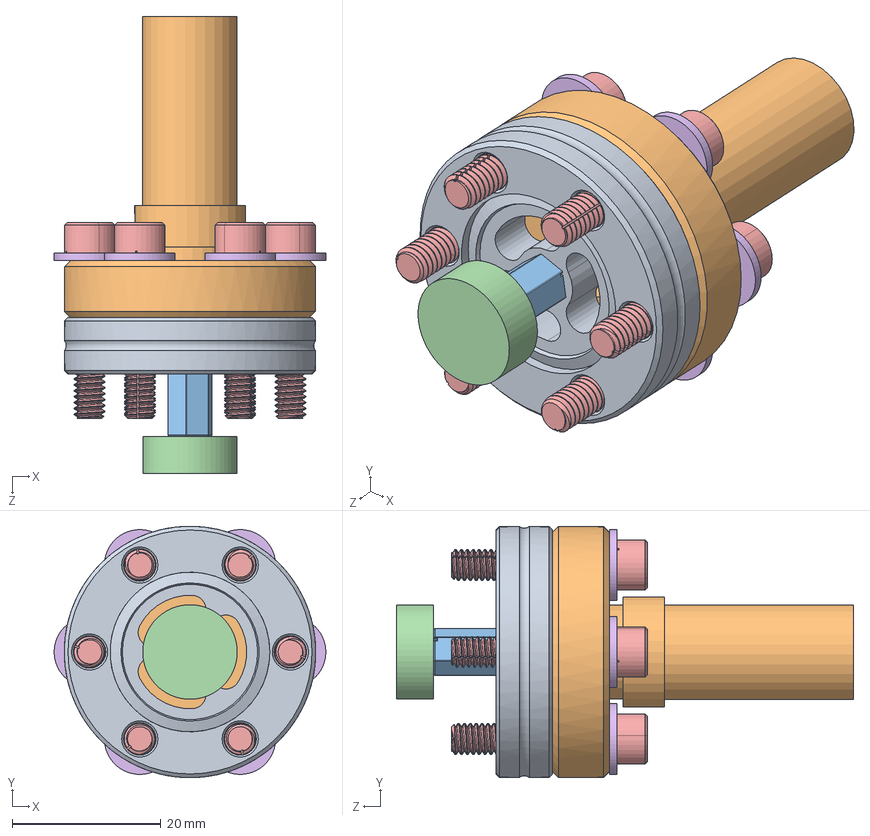
[picture p52: CAD file, 2026-06-09]
Gd-Source/CAD/GDLS/GDLS09.SLDASM
36.5 x 33.8 x 61.4 mm
GDLS035
GDLS009
GDLS012
GDLS011
GDLS043 x 6
GDLS045 x 6
