eldarro/radio-isotope-vuv-light-source/Gd-Source/CAD/GDLS/GDLS02.SLDASM

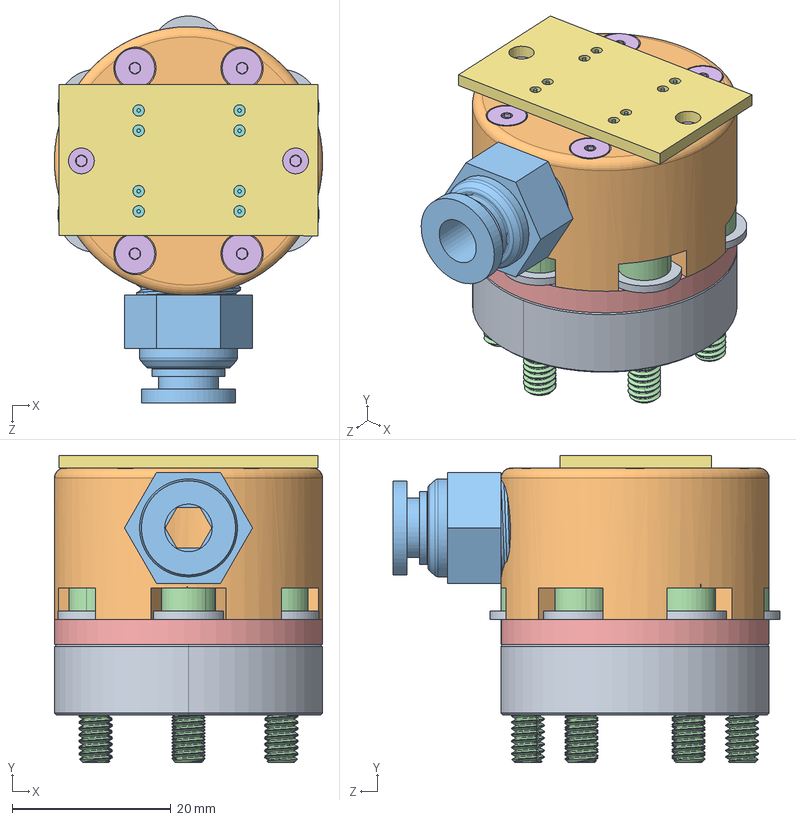
[picture p53: CAD file, 2026-06-09]
Gd-Source/CAD/GDLS/GDLS02.SLDASM
33.8 x 38.7 x 48.7 mm
GDLS002
GDLS019
GDLS020
GDLS044 x 6
GDLS003
GDLS026 x 6
GDLS034
GDLS022
GDLS045 x 6
