eldarro/radio-isotope-vuv-light-source/Gd-Source/CAD/GDLS/GDLS06.SLDASM

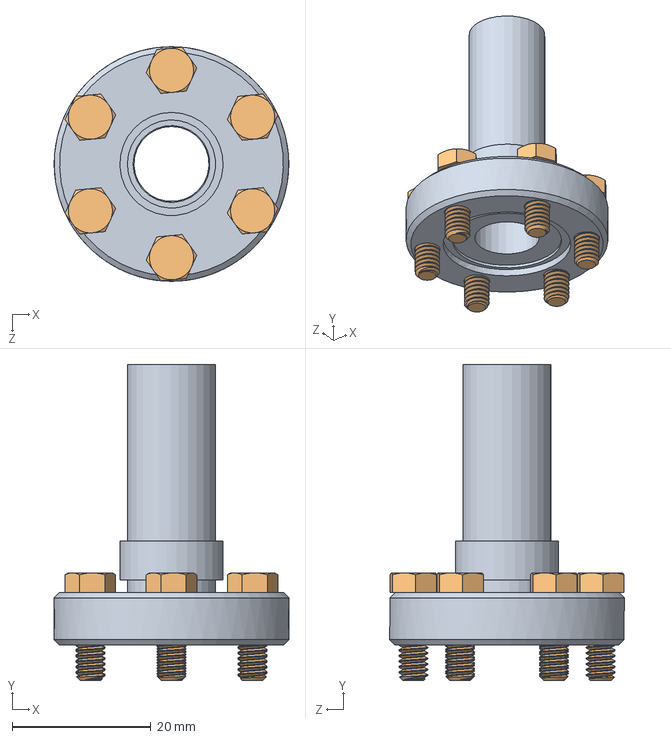
[picture p54: CAD file, 2026-06-09]
Gd-Source/CAD/GDLS/GDLS06.SLDASM
33.8 x 45.5 x 33.8 mm
GDLS009
GDLS025 x 6
