eldarro/radio-isotope-vuv-light-source/Gd-Source/CAD/GDLS/GDLS01.SLDASM

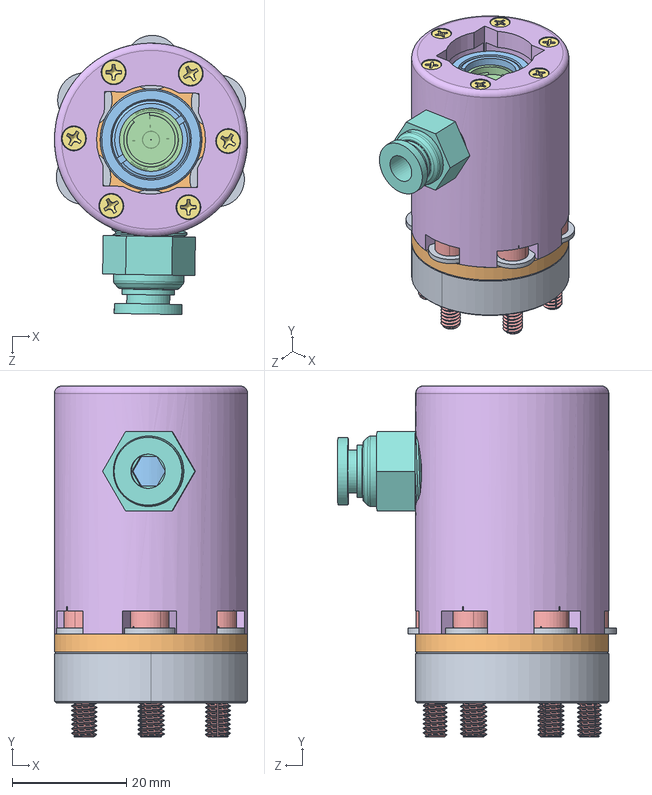
[picture p55: CAD file, 2026-06-09]
Gd-Source/CAD/GDLS/GDLS01.SLDASM
33.8 x 61.4 x 48.8 mm
GDLS002
GDLS003
GDLS037
GDLS006 x 2
GDLS044 x 6
GDLS027
GDLS028 x 6
GDLS020
GDLS045 x 6
