eldarro/radio-isotope-vuv-light-source/Gd-Source/CAD/CFLS/CFLS0025.SLDPRT

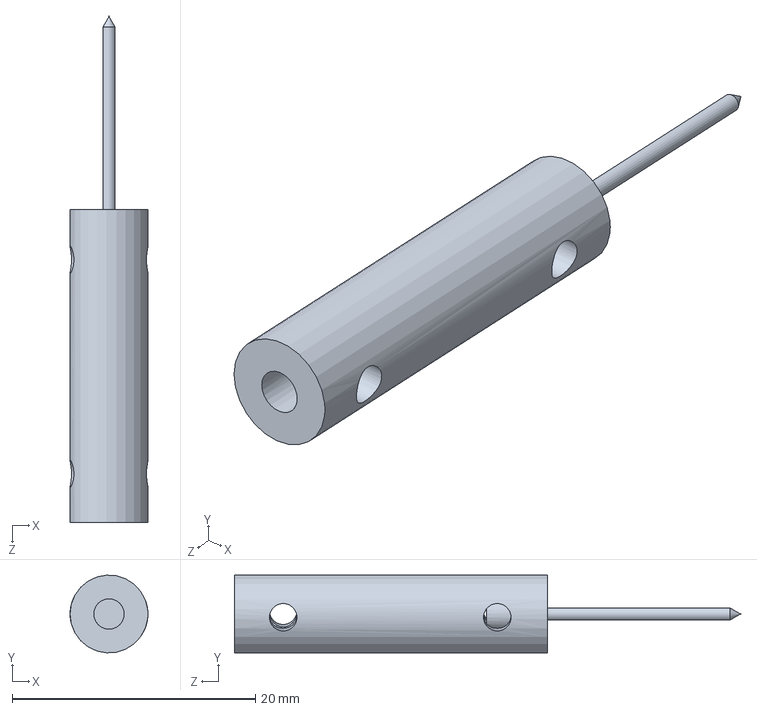
[picture p56: CAD file, 2026-06-09]
Gd-Source/CAD/CFLS/CFLS0025.SLDPRT
6.40 x 6.39 x 41.6 mm
