eldarro/radio-isotope-vuv-light-source/Gd-Source/CAD/CFLS/parts/vpzl-275uceu.stp

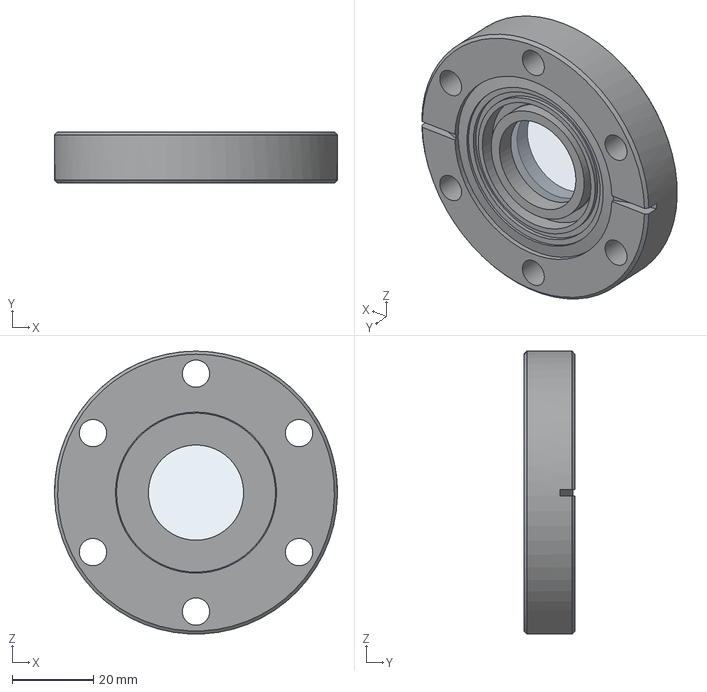
[picture p57: CAD file, 2026-06-09]
Gd-Source/CAD/CFLS/parts/vpzl-275uceu.stp
69.8 x 12.7 x 69.8 mm
