eldarro/radio-isotope-vuv-light-source/Gd-Source/SIM/CAD/GDSIM005.SLDPRT

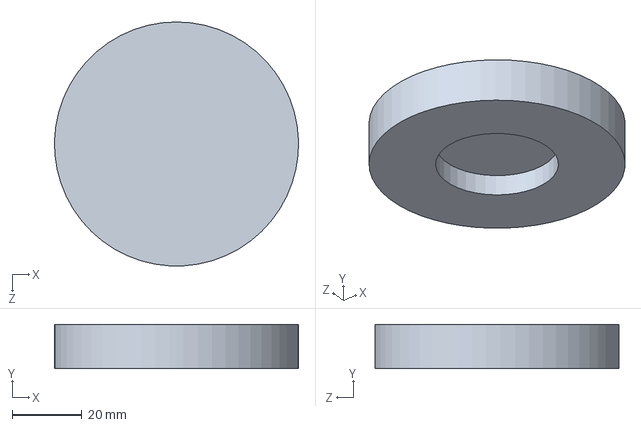
[picture p58: CAD file, 2026-06-09]
Gd-Source/SIM/CAD/GDSIM005.SLDPRT
69.8 x 12.7 x 69.8 mm
