eldarro/radio-isotope-vuv-light-source/Gd-Source/CAD/CFLS/CFLS0022.SLDPRT

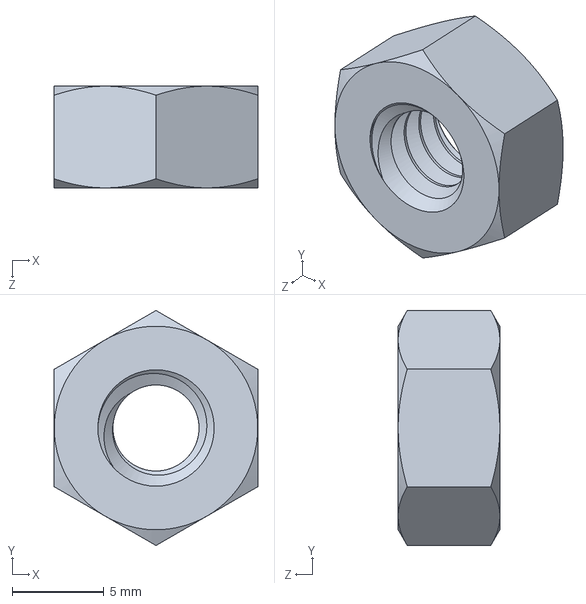
[picture p59: CAD file, 2026-06-09]
Gd-Source/CAD/CFLS/CFLS0022.SLDPRT
11.1 x 12.8 x 5.56 mm
