eldarro/radio-isotope-vuv-light-source/Gd-Source/CAD/CFLS/parts/vpzl-275du.stp

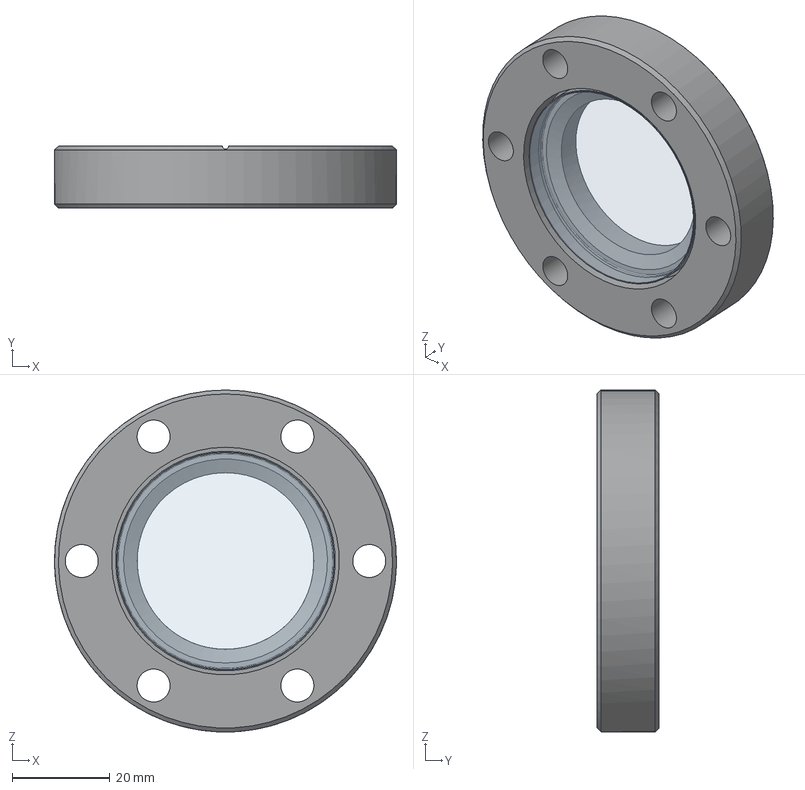
[picture p60: CAD file, 2026-06-09]
Gd-Source/CAD/CFLS/parts/vpzl-275du.stp
69.8 x 12.7 x 69.8 mm
