eldarro/radio-isotope-vuv-light-source/Gd-Source/CAD/GDLS/GDLS035.SLDPRT

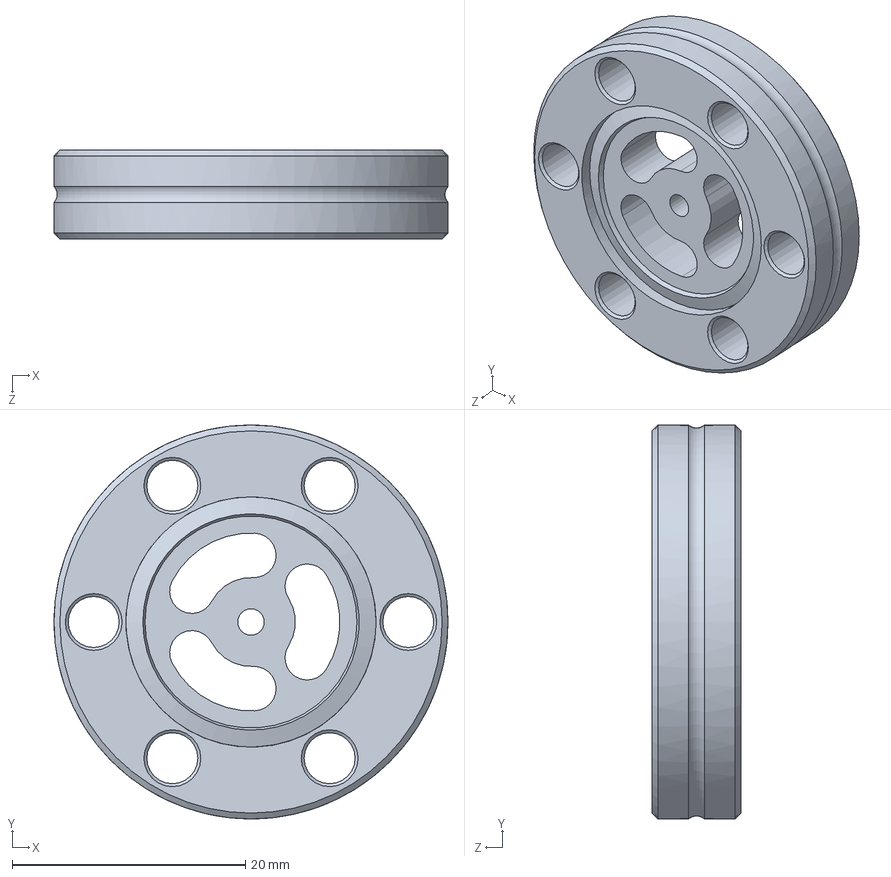
[picture p61: CAD file, 2026-06-09]
Gd-Source/CAD/GDLS/GDLS035.SLDPRT
33.8 x 33.8 x 7.62 mm
