eldarro/radio-isotope-vuv-light-source/Gd-Source/SIM/CAD/GDSIM010.SLDPRT

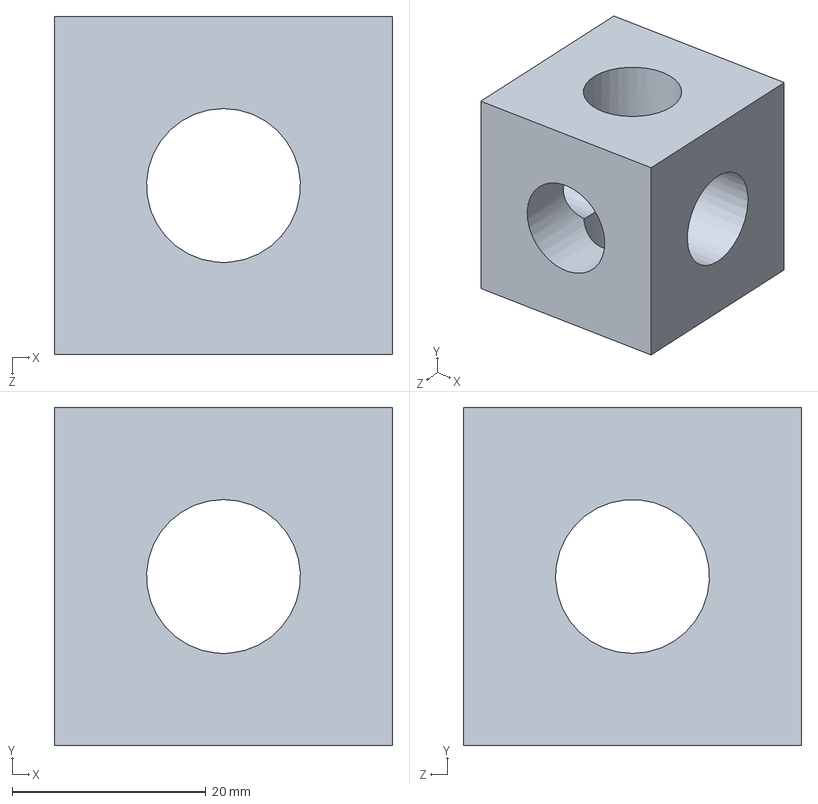
[picture p62: CAD file, 2026-06-09]
Gd-Source/SIM/CAD/GDSIM010.SLDPRT
34.9 x 34.9 x 34.9 mm
