eldarro/radio-isotope-vuv-light-source/Gd-Source/CAD/CFLS/parts/SM1L20-Solidworks (1).sldprt

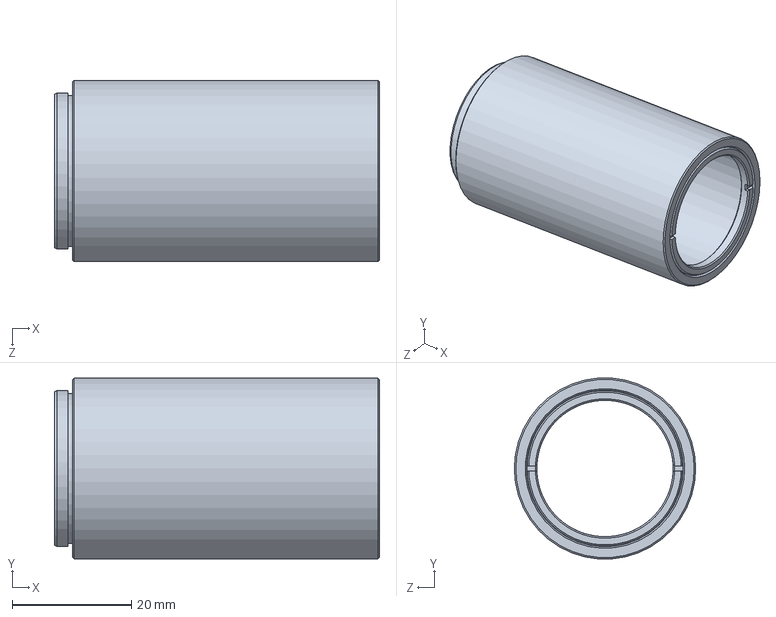
[picture p63: CAD file, 2026-06-09]
Gd-Source/CAD/CFLS/parts/SM1L20-Solidworks (1).sldprt
54.6 x 30.4 x 30.5 mm
