eldarro/radio-isotope-vuv-light-source/Gd-Source/CAD/GDLS/GDLS055.sldprt

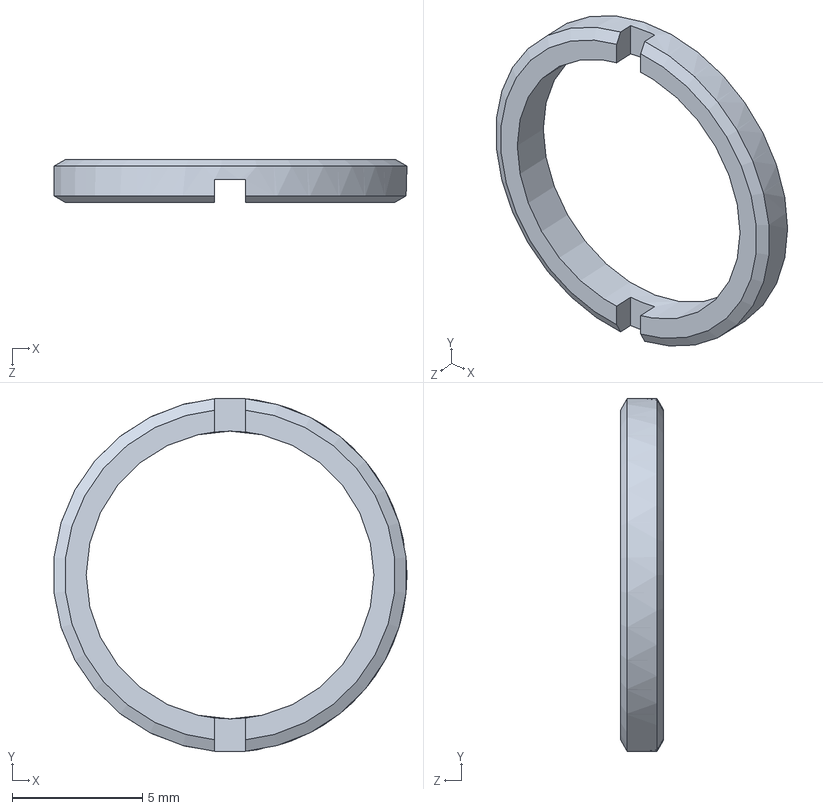
[picture p64: CAD file, 2026-06-09]
Gd-Source/CAD/GDLS/GDLS055.sldprt
13.6 x 13.6 x 1.65 mm
