eldarro/radio-isotope-vuv-light-source/Gd-Source/SIM/CAD/GDSIM007.SLDPRT

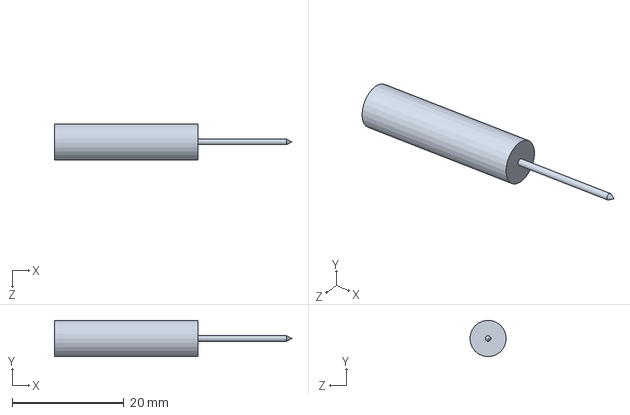
[picture p65: CAD file, 2026-06-09]
Gd-Source/SIM/CAD/GDSIM007.SLDPRT
42.4 x 6.49 x 6.47 mm
