eldarro/radio-isotope-vuv-light-source/Gd-Source/CAD/GDLS/GDLS040.SLDPRT

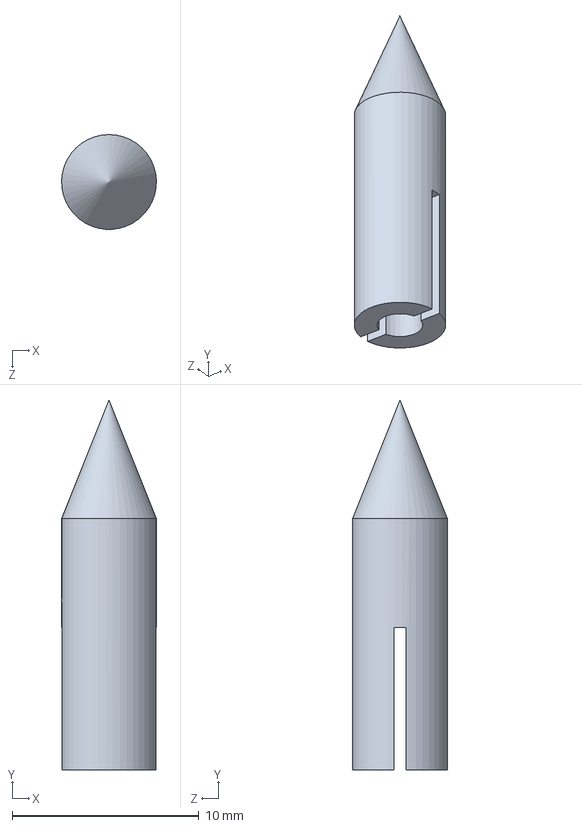
[picture p66: CAD file, 2026-06-09]
Gd-Source/CAD/GDLS/GDLS040.SLDPRT
5.08 x 19.8 x 5.08 mm
