eldarro/radio-isotope-vuv-light-source/Gd-Source/SIM/CAD/GDSIM013.SLDPRT

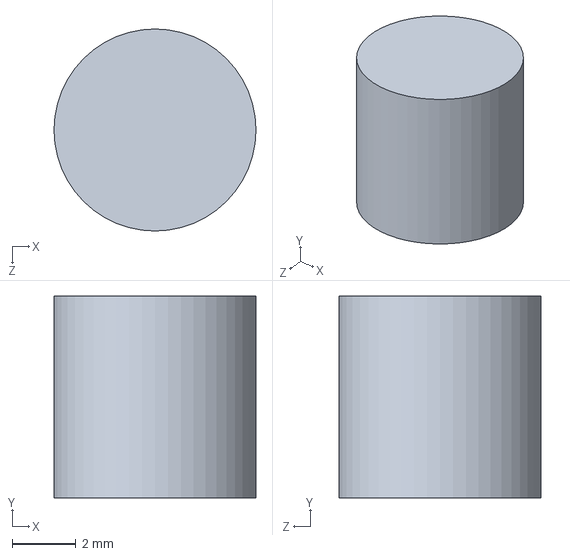
[picture p67: CAD file, 2026-06-09]
Gd-Source/SIM/CAD/GDSIM013.SLDPRT
6.35 x 6.35 x 6.35 mm
