eldarro/radio-isotope-vuv-light-source/Gd-Source/CAD/GDLS/GDLS039.SLDPRT

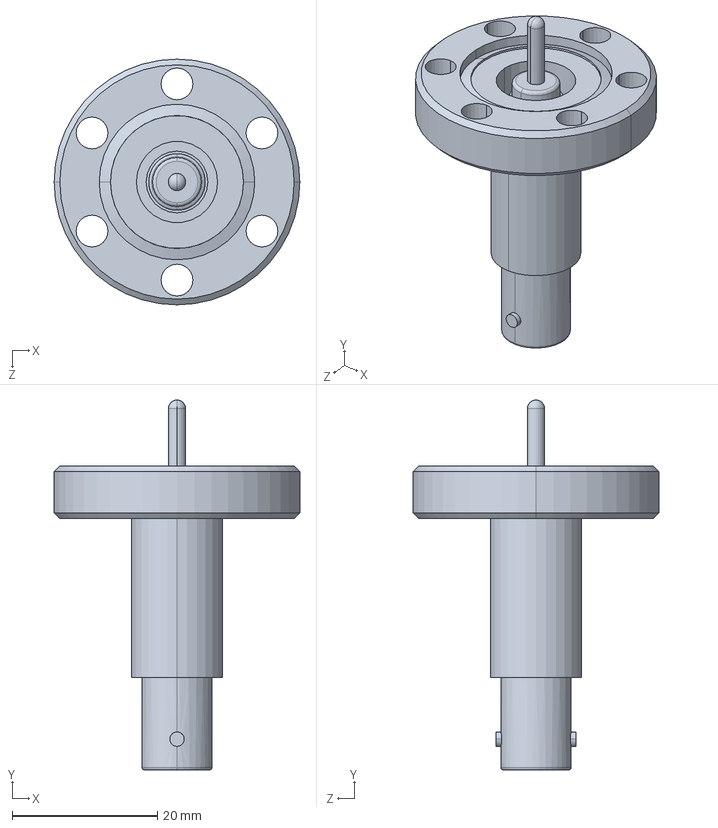
[picture p68: CAD file, 2026-06-09]
Gd-Source/CAD/GDLS/GDLS039.SLDPRT
33.8 x 50.9 x 33.8 mm
