eldarro/radio-isotope-vuv-light-source/Gd-Source/SIM/CAD/GDSIM012.SLDPRT

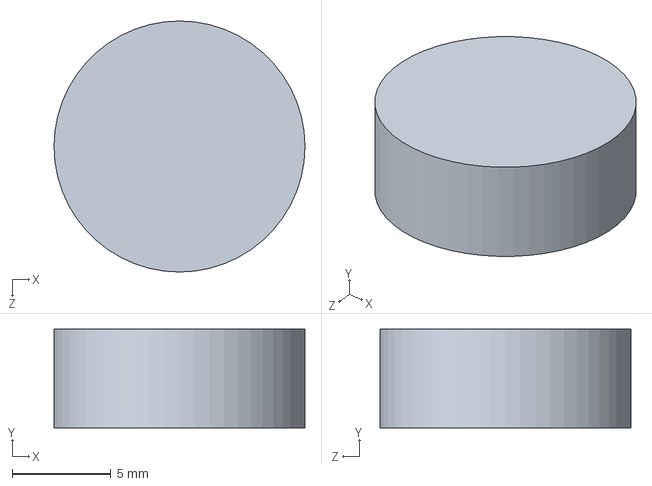
[picture p69: CAD file, 2026-06-09]
Gd-Source/SIM/CAD/GDSIM012.SLDPRT
12.7 x 5.00 x 12.7 mm
