eldarro/radio-isotope-vuv-light-source/Gd-Source/CAD/GDLS/GDLS019.SLDPRT

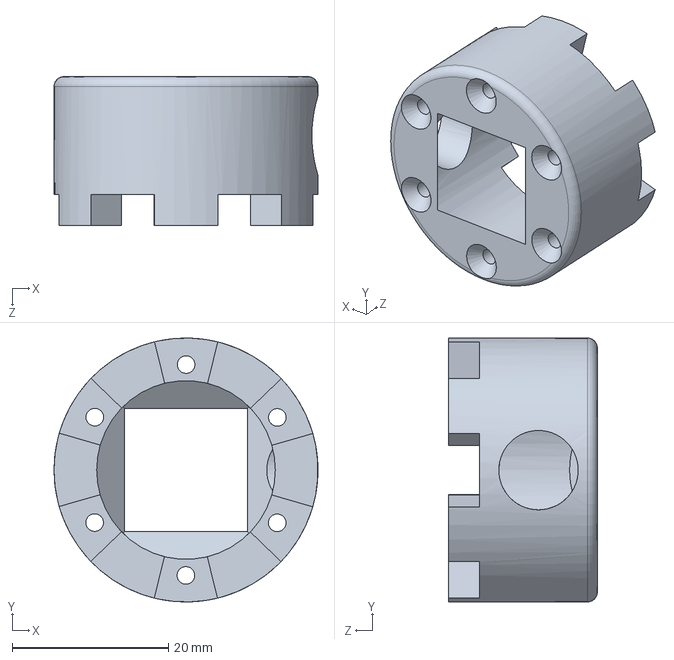
[picture p70: CAD file, 2026-06-09]
Gd-Source/CAD/GDLS/GDLS019.SLDPRT
33.8 x 33.8 x 19.1 mm
