eldarro/radio-isotope-vuv-light-source/Gd-Source/CAD/GDLS/GDLS015.SLDPRT

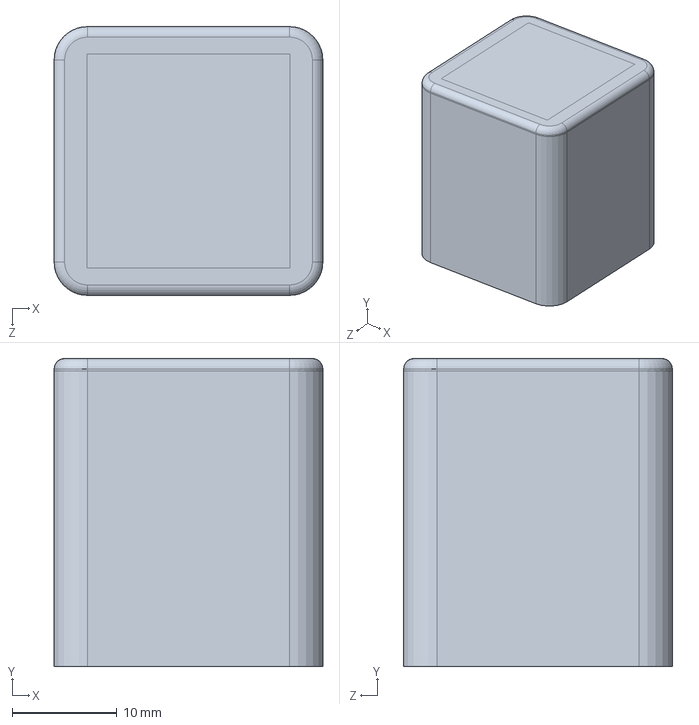
[picture p71: CAD file, 2026-06-09]
Gd-Source/CAD/GDLS/GDLS015.SLDPRT
25.7 x 29.4 x 25.7 mm
