eldarro/radio-isotope-vuv-light-source/Gd-Source/SIM/CAD/GDSIM019.SLDPRT

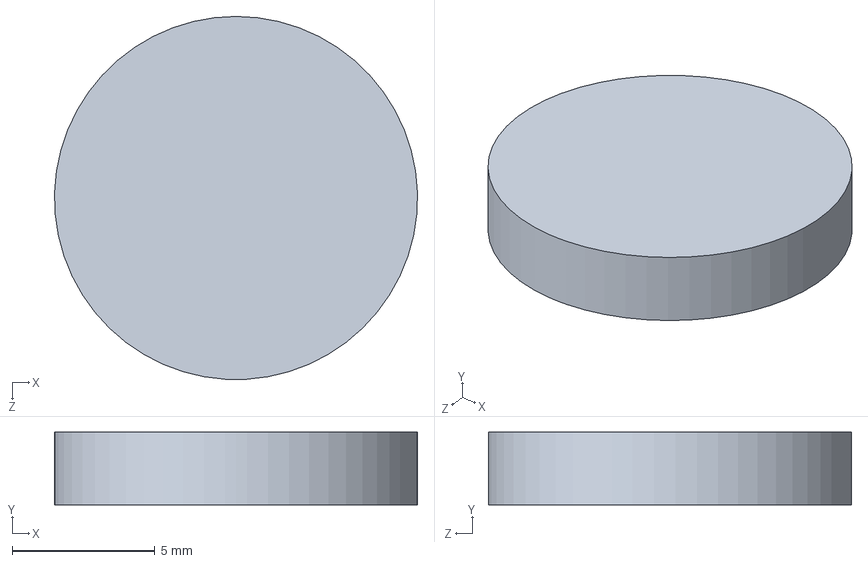
[picture p72: CAD file, 2026-06-09]
Gd-Source/SIM/CAD/GDSIM019.SLDPRT
12.7 x 2.54 x 12.7 mm
