eldarro/radio-isotope-vuv-light-source/Gd-Source/CAD/CFLS/CFLS0006.SLDPRT

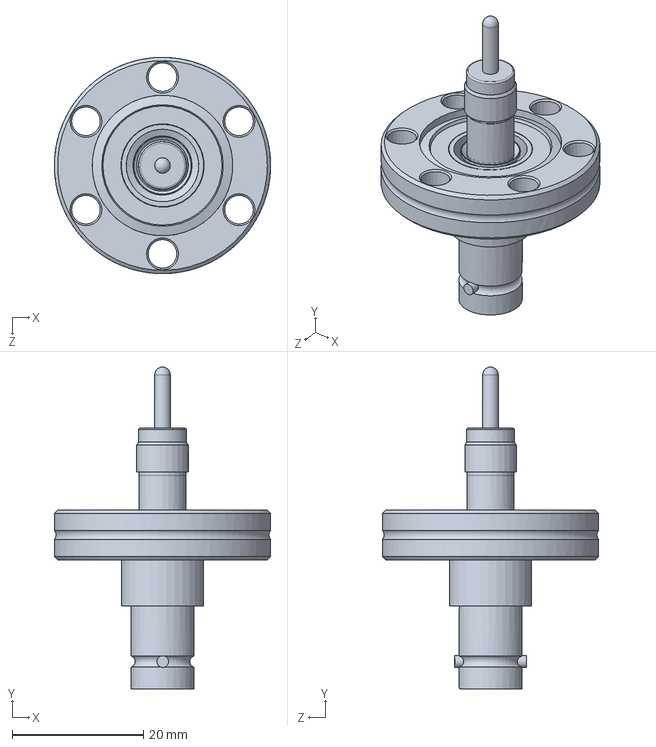
[picture p73: CAD file, 2026-06-09]
Gd-Source/CAD/CFLS/CFLS0006.SLDPRT
33.0 x 49.1 x 33.0 mm
