eldarro/radio-isotope-vuv-light-source/Gd-Source/CAD/GDLS/GDLS043.SLDPRT

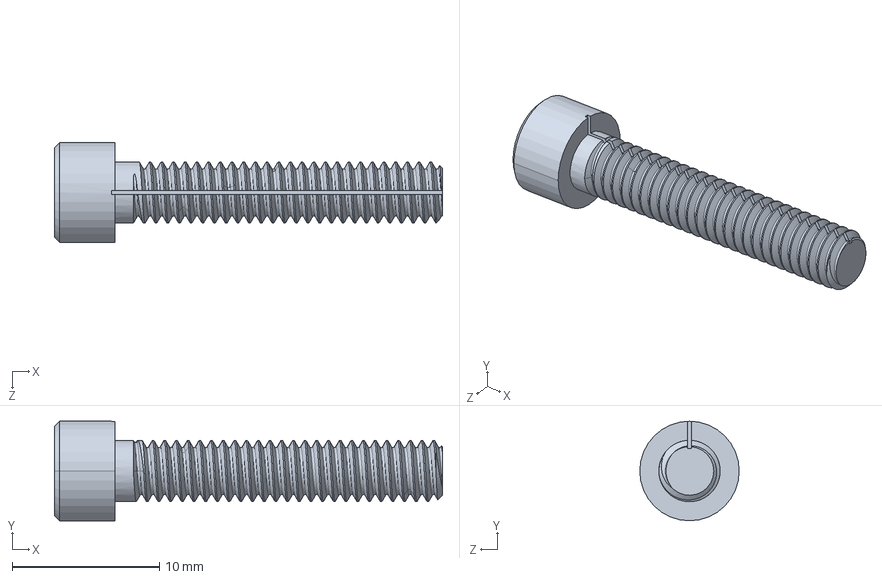
[picture p74: CAD file, 2026-06-09]
Gd-Source/CAD/GDLS/GDLS043.SLDPRT
26.3 x 6.76 x 6.76 mm
