eldarro/radio-isotope-vuv-light-source/Gd-Source/SIM/CAD/GDSIM001.SLDPRT

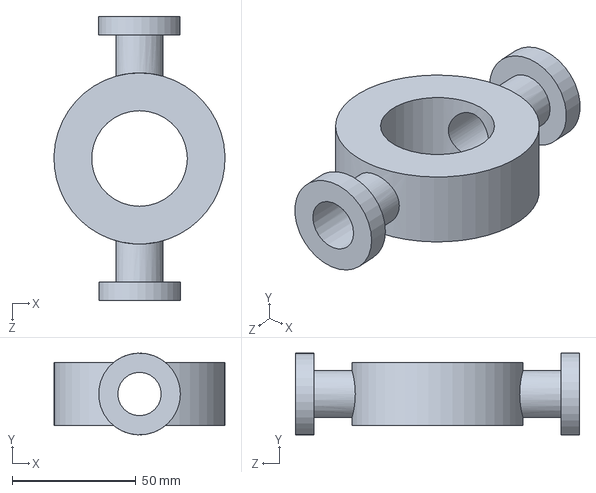
[picture p75: CAD file, 2026-06-09]
Gd-Source/SIM/CAD/GDSIM001.SLDPRT
69.0 x 33.0 x 114.8 mm
