eldarro/radio-isotope-vuv-light-source/Gd-Source/CAD/CFLS/CFLS0017.SLDPRT

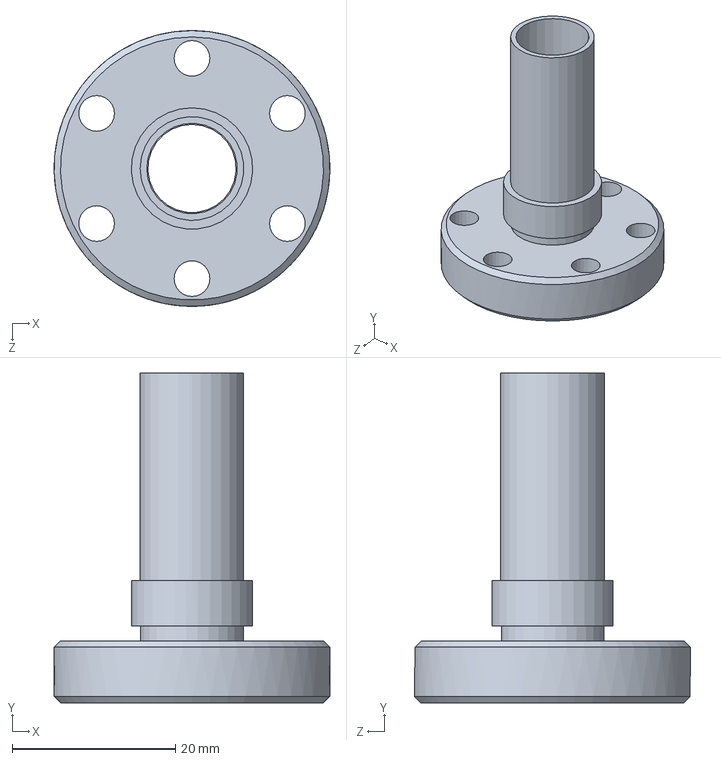
[picture p76: CAD file, 2026-06-09]
Gd-Source/CAD/CFLS/CFLS0017.SLDPRT
33.8 x 40.4 x 33.8 mm
