eldarro/radio-isotope-vuv-light-source/Gd-Source/CAD/CFLS/CFLS0013.SLDPRT

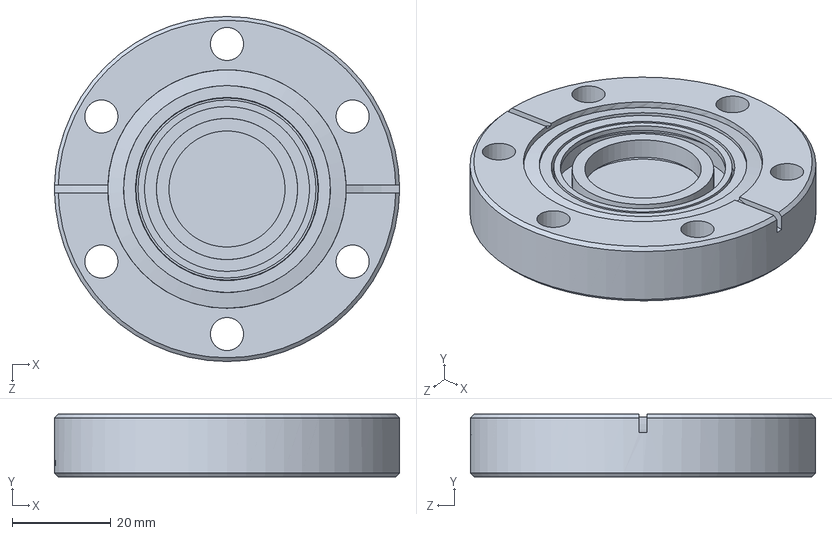
[picture p77: CAD file, 2026-06-09]
Gd-Source/CAD/CFLS/CFLS0013.SLDPRT
69.8 x 12.7 x 69.8 mm
