eldarro/radio-isotope-vuv-light-source/Gd-Source/CAD/GDLS/GDLS012.SLDPRT

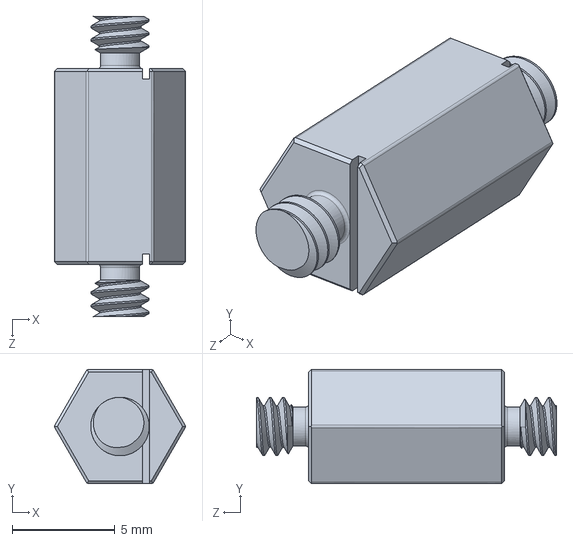
[picture p78: CAD file, 2026-06-09]
Gd-Source/CAD/GDLS/GDLS012.SLDPRT
6.37 x 5.56 x 14.6 mm
