eldarro/radio-isotope-vuv-light-source/Gd-Source/SIM/CAD/GDSIM016.SLDPRT

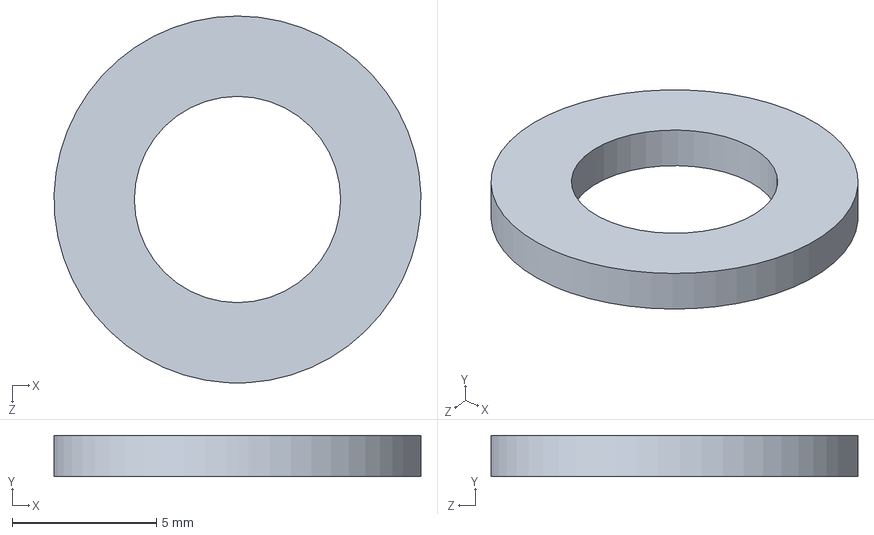
[picture p79: CAD file, 2026-06-09]
Gd-Source/SIM/CAD/GDSIM016.SLDPRT
12.7 x 1.42 x 12.7 mm
