eldarro/radio-isotope-vuv-light-source/Gd-Source/SIM/CAD/GDSIM002.SLDPRT

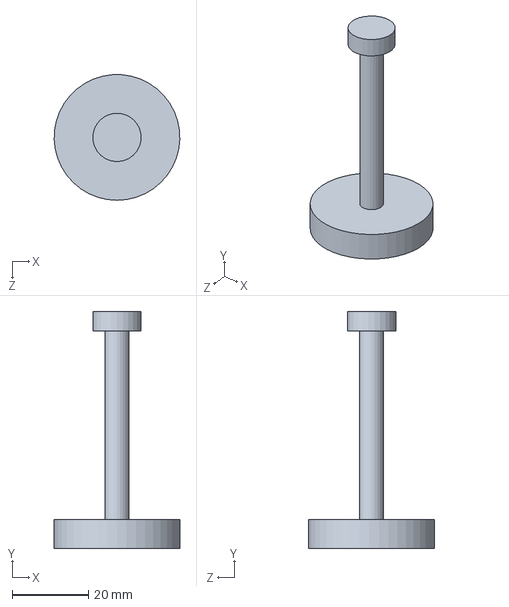
[picture p81: CAD file, 2026-06-09]
Gd-Source/SIM/CAD/GDSIM002.SLDPRT
33.0 x 62.2 x 33.0 mm
