eldarro/radio-isotope-vuv-light-source/Gd-Source/CAD/GDLS/GDLS053.sldprt

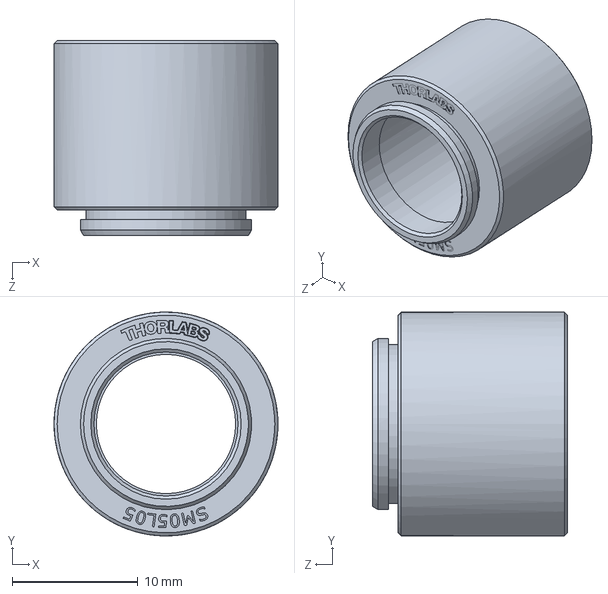
[picture p82: CAD file, 2026-06-09]
Gd-Source/CAD/GDLS/GDLS053.sldprt
17.8 x 17.8 x 15.5 mm
