eldarro/radio-isotope-vuv-light-source/Gd-Source/SIM/CAD/GDSIM006.SLDPRT

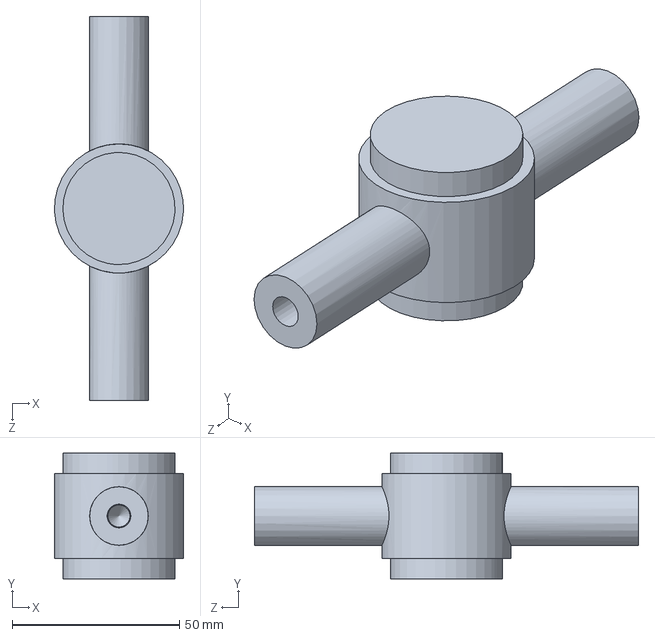
[picture p83: CAD file, 2026-06-09]
Gd-Source/SIM/CAD/GDSIM006.SLDPRT
38.6 x 37.6 x 114.8 mm
