eldarro/radio-isotope-vuv-light-source/Gd-Source/CAD/GDLS/GDLS001.sldprt

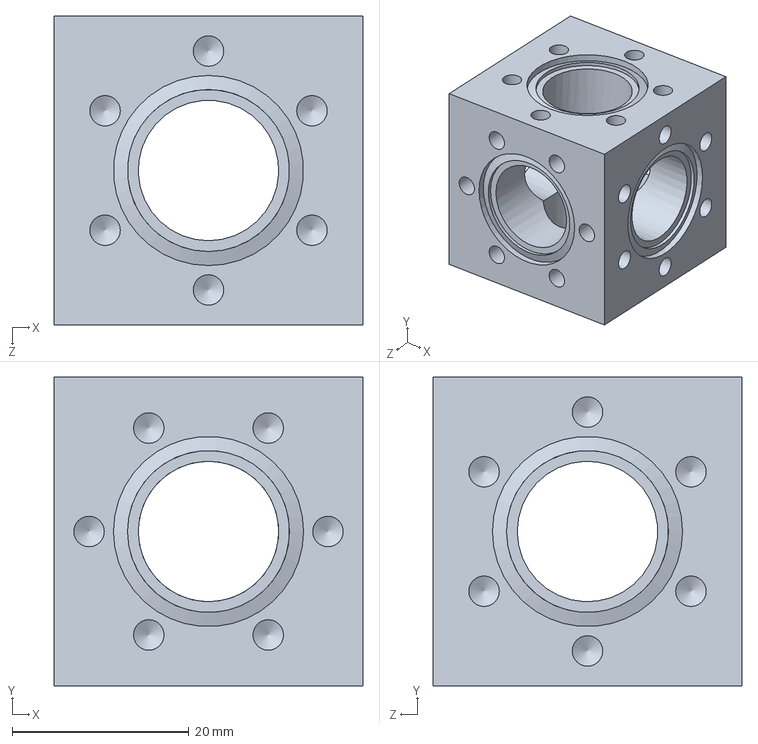
[picture p84: CAD file, 2026-06-09]
Gd-Source/CAD/GDLS/GDLS001.sldprt
34.9 x 34.9 x 34.9 mm
