eldarro/radio-isotope-vuv-light-source/Gd-Source/SIM/CAD/GDSIM015.SLDPRT

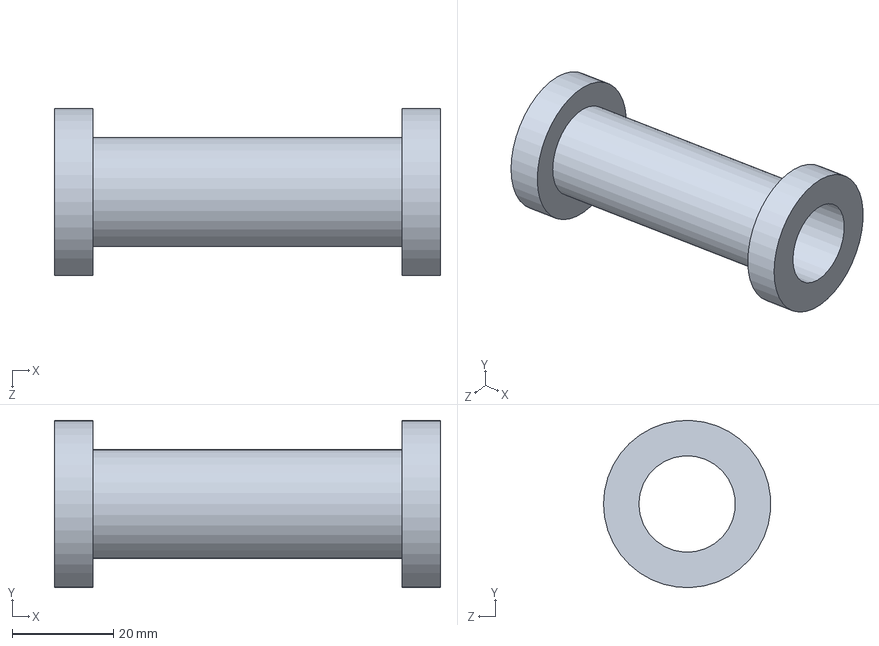
[picture p85: CAD file, 2026-06-09]
Gd-Source/SIM/CAD/GDSIM015.SLDPRT
76.2 x 33.0 x 33.0 mm
