eldarro/radio-isotope-vuv-light-source/Gd-Source/CAD/CFLS/CFLS0016.SLDPRT

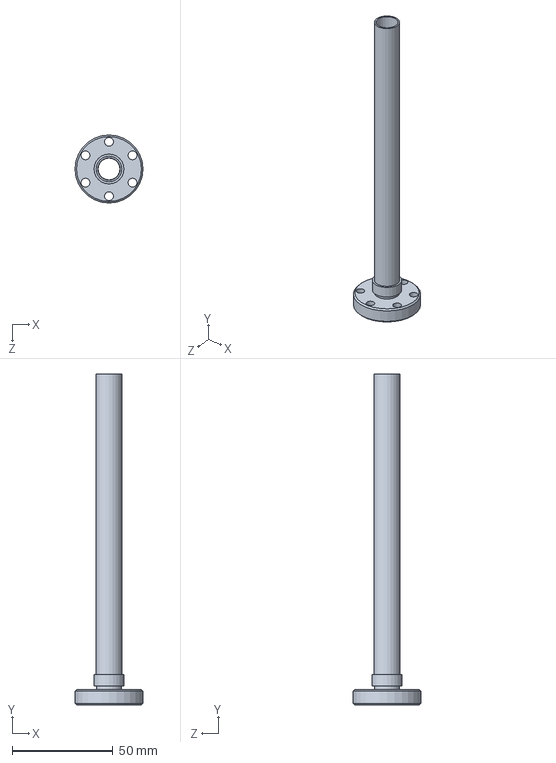
[picture p86: CAD file, 2026-06-09]
Gd-Source/CAD/CFLS/CFLS0016.SLDPRT
33.8 x 164.2 x 33.8 mm
