eldarro/radio-isotope-vuv-light-source/Gd-Source/CAD/CFLS/CFLS0021.SLDPRT

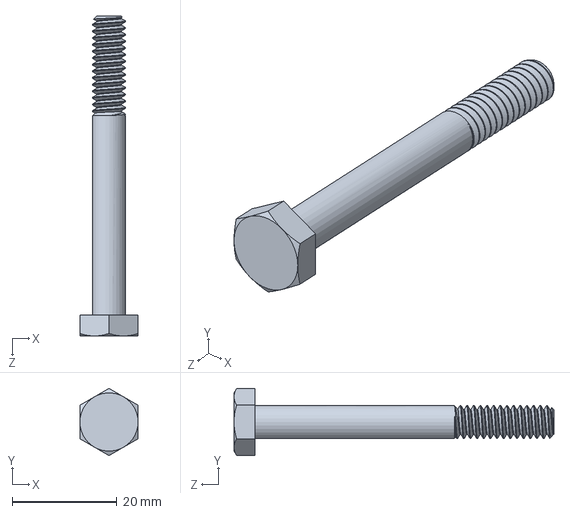
[picture p87: CAD file, 2026-06-09]
Gd-Source/CAD/CFLS/CFLS0021.SLDPRT
11.1 x 12.8 x 61.1 mm
