eldarro/radio-isotope-vuv-light-source/Gd-Source/CAD/GDLS/GDLS028.SLDPRT

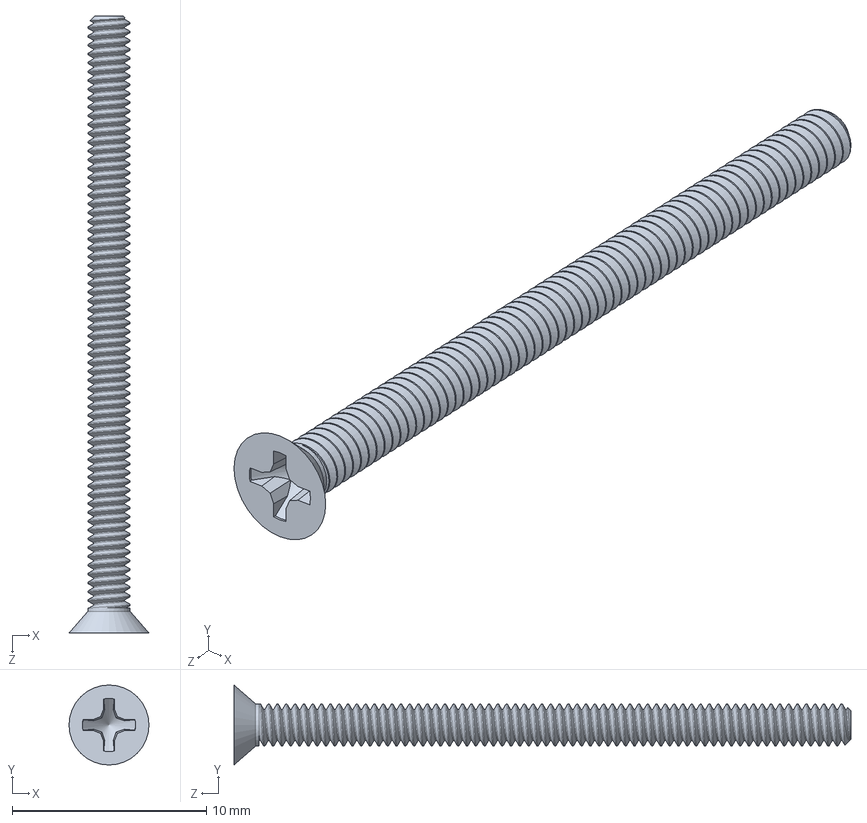
[picture p88: CAD file, 2026-06-09]
Gd-Source/CAD/GDLS/GDLS028.SLDPRT
4.11 x 4.11 x 31.8 mm
