eldarro/radio-isotope-vuv-light-source/Gd-Source/SIM/CAD/GDSIM011.SLDPRT

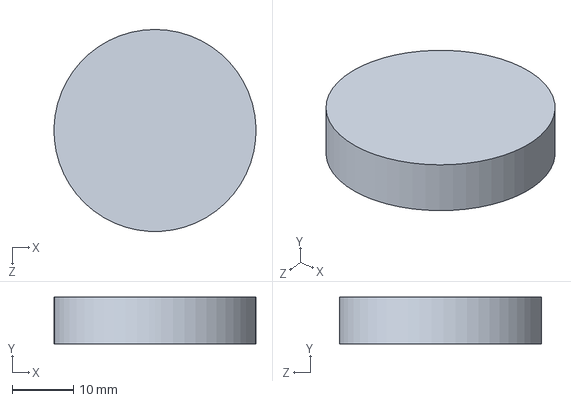
[picture p89: CAD file, 2026-06-09]
Gd-Source/SIM/CAD/GDSIM011.SLDPRT
33.0 x 7.62 x 33.0 mm
