eldarro/radio-isotope-vuv-light-source/Gd-Source/CAD/CFLS/CFLS0003.SLDPRT

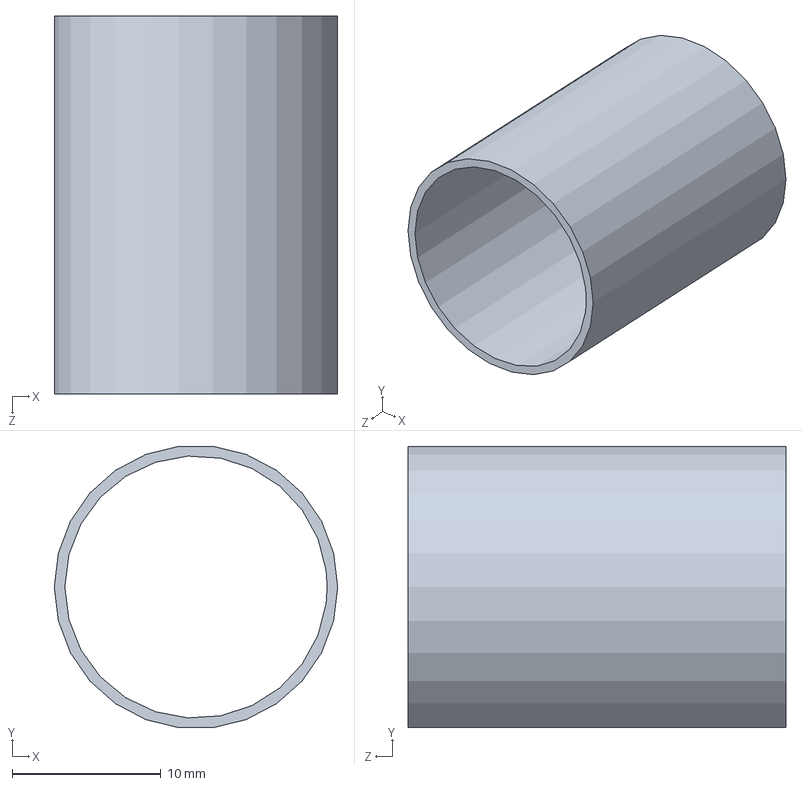
[picture p90: CAD file, 2026-06-09]
Gd-Source/CAD/CFLS/CFLS0003.SLDPRT
19.1 x 18.9 x 25.4 mm
