eldarro/radio-isotope-vuv-light-source/Gd-Source/CAD/GDLS/GDLS010.SLDPRT

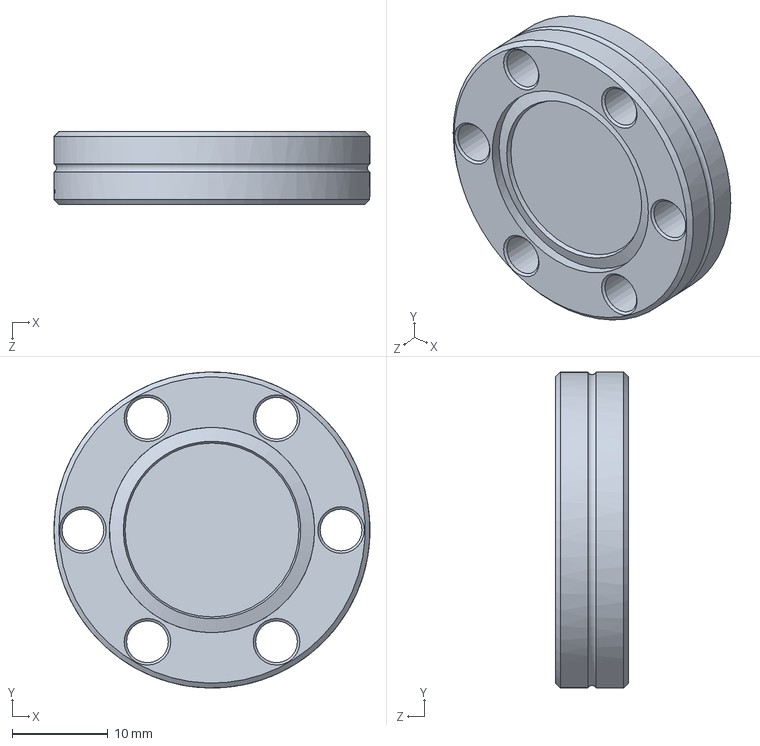
[picture p92: CAD file, 2026-06-09]
Gd-Source/CAD/GDLS/GDLS010.SLDPRT
33.0 x 33.0 x 7.62 mm
