eldarro/radio-isotope-vuv-light-source/Gd-Source/SIM/CAD/Part1^Assem2.STEP

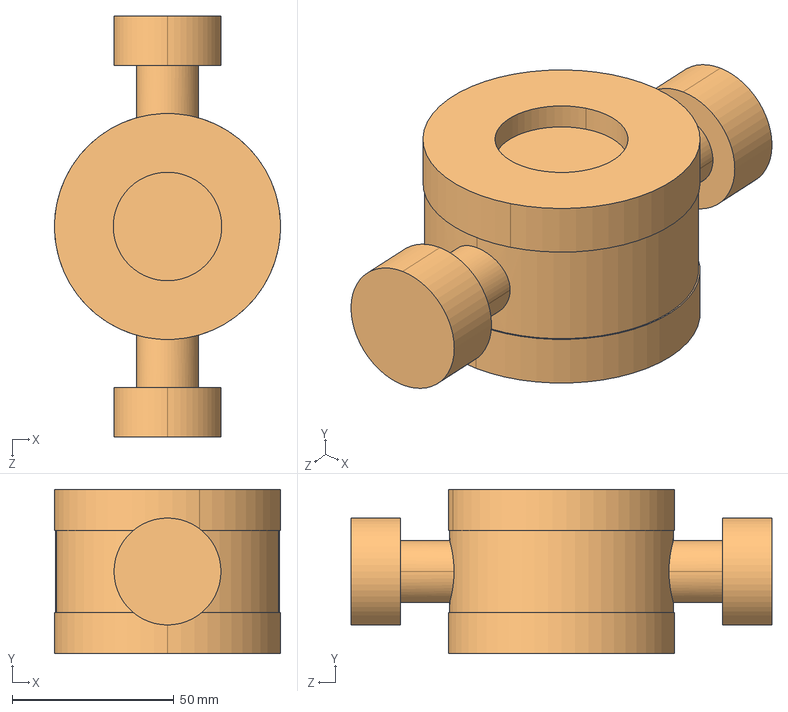
[picture p93: CAD file, 2026-06-09]
Gd-Source/SIM/CAD/Part1^Assem2.STEP
69.8 x 50.8 x 130.0 mm
