eldarro/radio-isotope-vuv-light-source/Gd-Source/CAD/CFLS/CFLS0020.SLDPRT

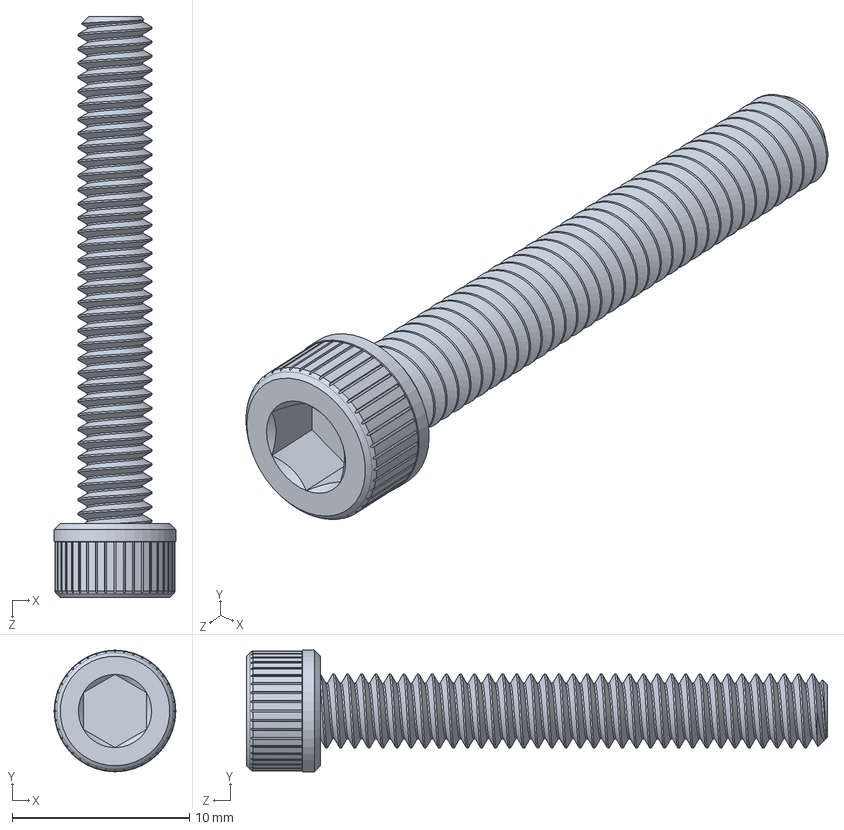
[picture p94: CAD file, 2026-06-09]
Gd-Source/CAD/CFLS/CFLS0020.SLDPRT
6.86 x 6.86 x 32.7 mm
