eldarro/radio-isotope-vuv-light-source/Gd-Source/CAD/GDLS/GDLS033.SLDPRT

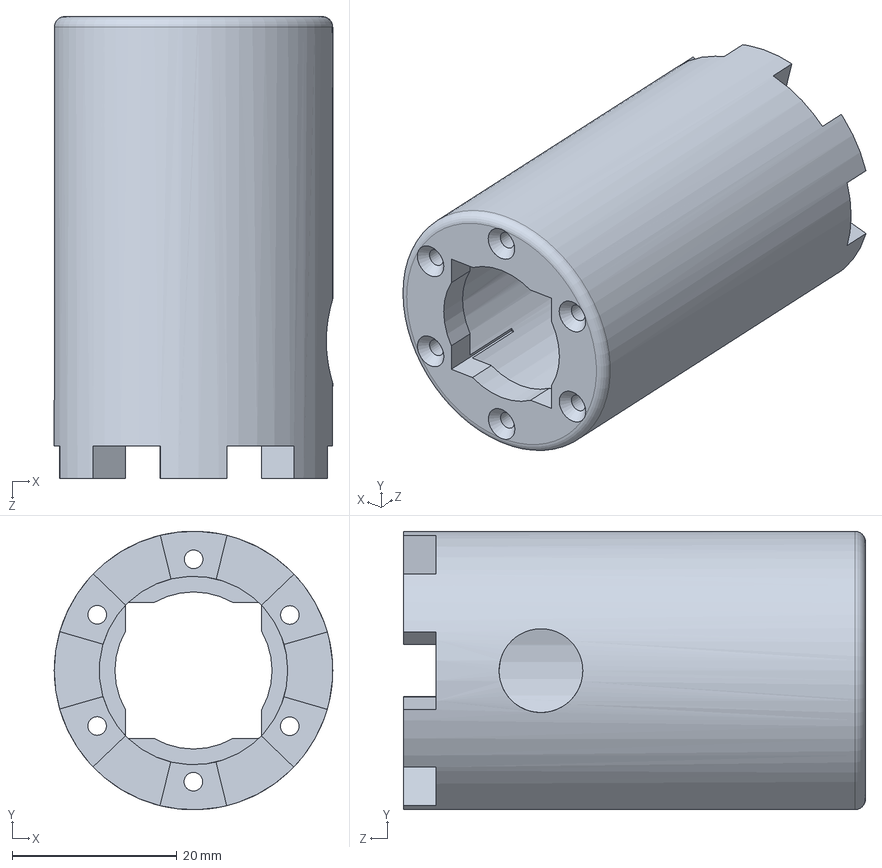
[picture p95: CAD file, 2026-06-09]
Gd-Source/CAD/GDLS/GDLS033.SLDPRT
33.8 x 33.8 x 56.0 mm
