eldarro/radio-isotope-vuv-light-source/Gd-Source/SIM/CAD/GDSIM003.SLDPRT

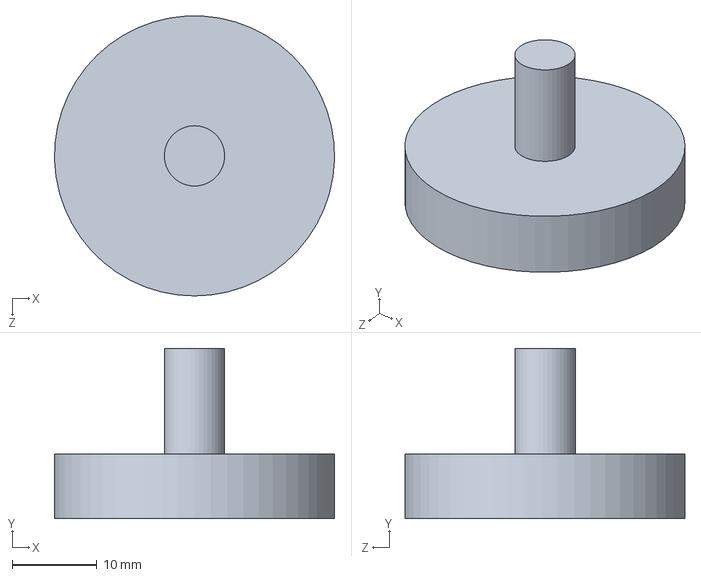
[picture p96: CAD file, 2026-06-09]
Gd-Source/SIM/CAD/GDSIM003.SLDPRT
33.0 x 20.1 x 33.0 mm
