eldarro/radio-isotope-vuv-light-source/Gd-Source/CAD/CFLS/CFLS0026.SLDPRT

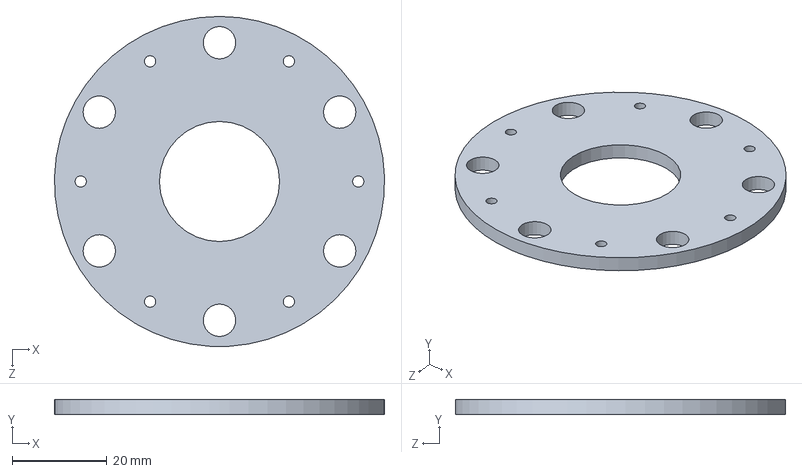
[picture p97: CAD file, 2026-06-09]
Gd-Source/CAD/CFLS/CFLS0026.SLDPRT
69.8 x 3.17 x 69.8 mm
