eldarro/radio-isotope-vuv-light-source/Gd-Source/CAD/CFLS/CFLS0008.SLDPRT

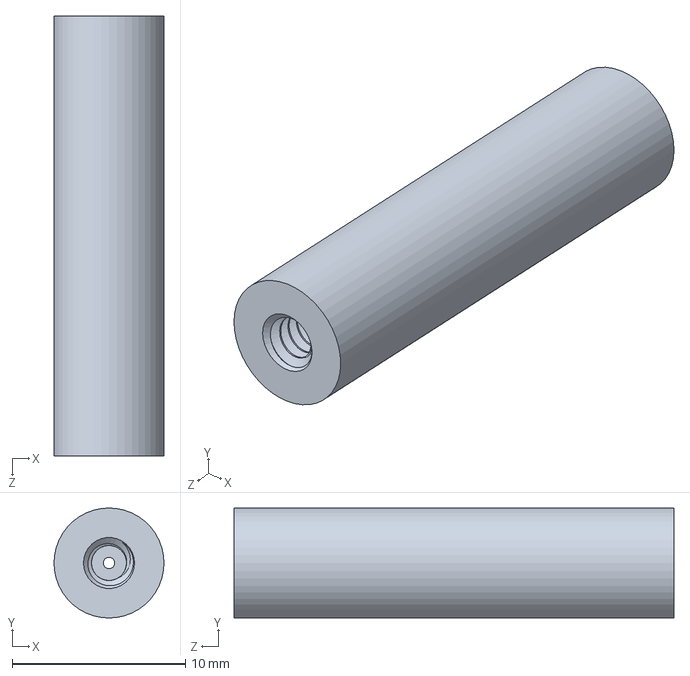
[picture p98: CAD file, 2026-06-09]
Gd-Source/CAD/CFLS/CFLS0008.SLDPRT
6.35 x 6.35 x 25.4 mm
