eldarro/radio-isotope-vuv-light-source/Gd-Source/CAD/GDLS/GDLS037.SLDPRT

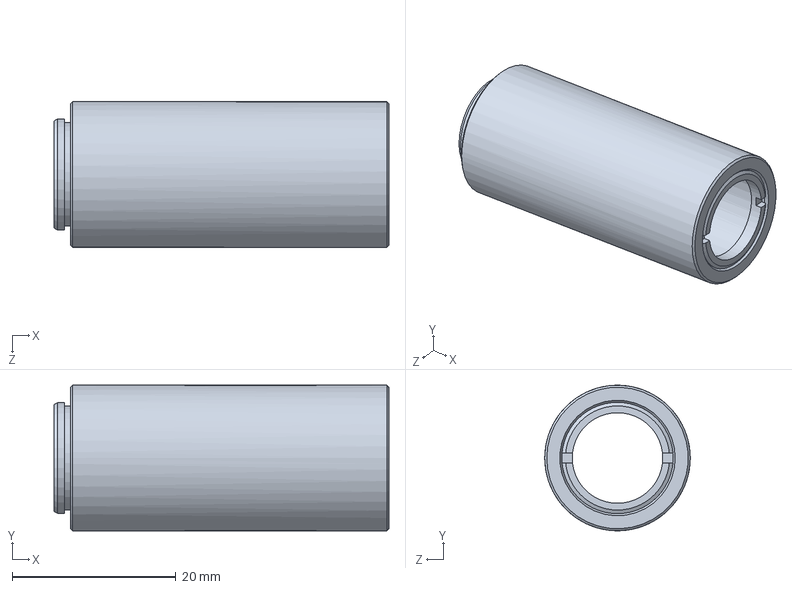
[picture p99: CAD file, 2026-06-09]
Gd-Source/CAD/GDLS/GDLS037.SLDPRT
40.9 x 17.8 x 17.8 mm
