eldarro/radio-isotope-vuv-light-source/Gd-Source/SIM/CAD/GDSIM004.SLDPRT

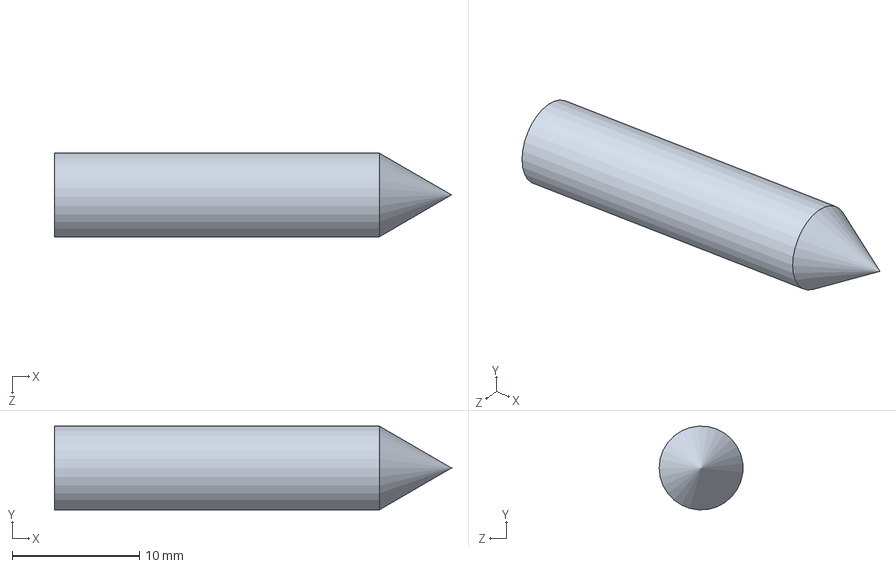
[picture p100: CAD file, 2026-06-09]
Gd-Source/SIM/CAD/GDSIM004.SLDPRT
31.2 x 6.59 x 6.58 mm
