eldarro/radio-isotope-vuv-light-source/Gd-Source/CAD/GDLS/GDLS044.SLDPRT

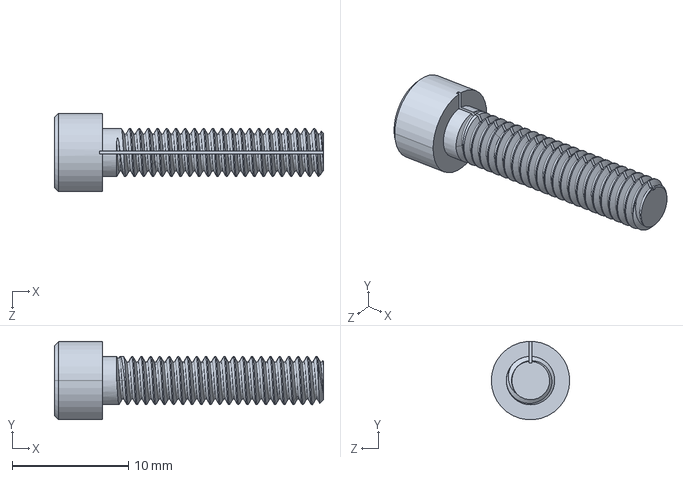
[picture p101: CAD file, 2026-06-09]
Gd-Source/CAD/GDLS/GDLS044.SLDPRT
23.2 x 6.74 x 6.76 mm
