eldarro/radio-isotope-vuv-light-source/Gd-Source/CAD/CFLS/CFLS0002.SLDPRT

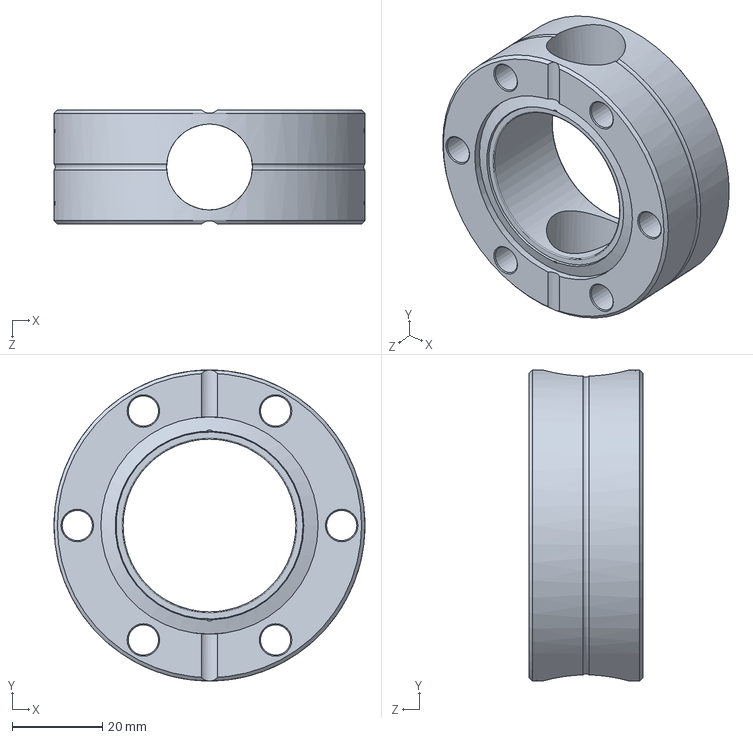
[picture p102: CAD file, 2026-06-09]
Gd-Source/CAD/CFLS/CFLS0002.SLDPRT
69.1 x 69.1 x 25.4 mm
