eldarro/radio-isotope-vuv-light-source/Gd-Source/CAD/GDLS/GDLS022.SLDPRT

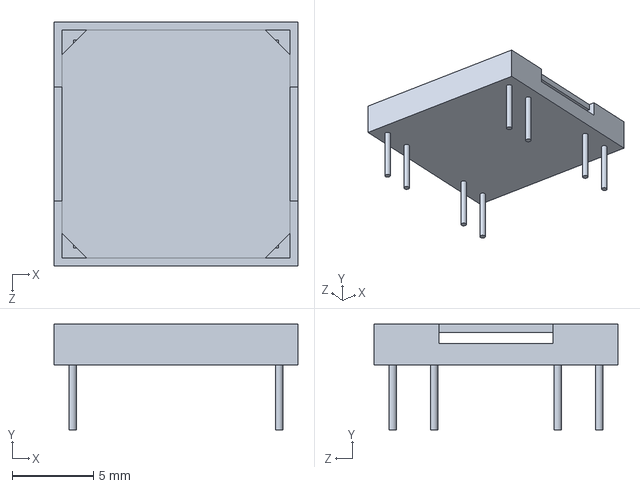
[picture p103: CAD file, 2026-06-09]
Gd-Source/CAD/GDLS/GDLS022.SLDPRT
15.0 x 6.50 x 15.0 mm
