eldarro/radio-isotope-vuv-light-source/Gd-Source/SIM/CAD/GDSIM014.SLDPRT

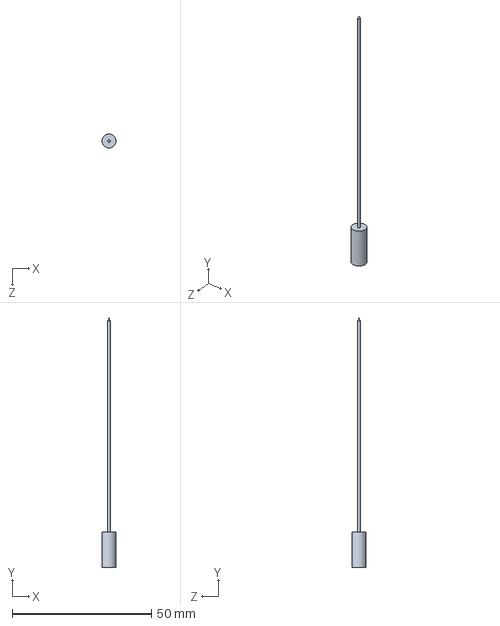
[picture p104: CAD file, 2026-06-09]
Gd-Source/SIM/CAD/GDSIM014.SLDPRT
5.08 x 89.6 x 5.08 mm
