eldarro/radio-isotope-vuv-light-source/Gd-Source/CAD/CFLS/CFLS0014.SLDPRT

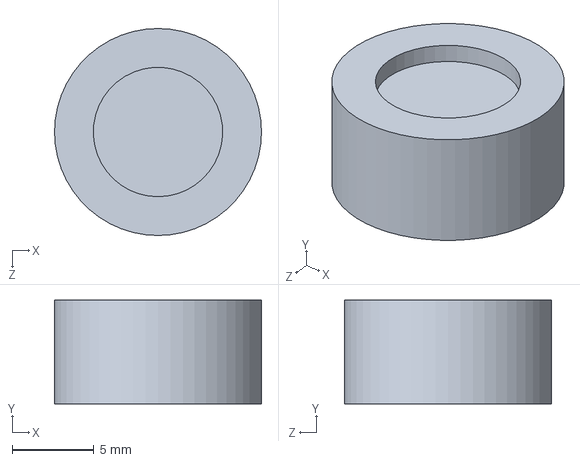
[picture p105: CAD file, 2026-06-09]
Gd-Source/CAD/CFLS/CFLS0014.SLDPRT
12.7 x 6.35 x 12.7 mm
