eldarro/radio-isotope-vuv-light-source/Gd-Source/CAD/GDLS/GDLS006.SLDPRT

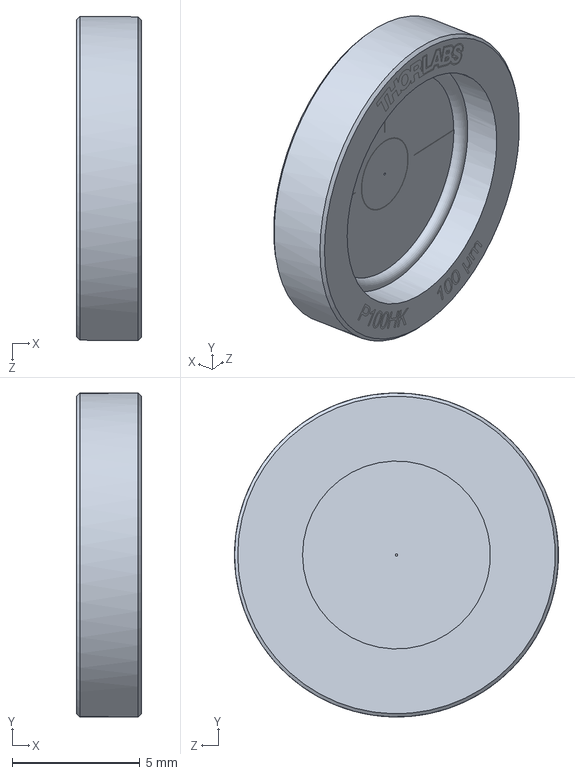
[picture p106: CAD file, 2026-06-09]
Gd-Source/CAD/GDLS/GDLS006.SLDPRT
2.54 x 12.7 x 12.7 mm
