eldarro/radio-isotope-vuv-light-source/Gd-Source/CAD/GDLS/GDLS049.sldprt

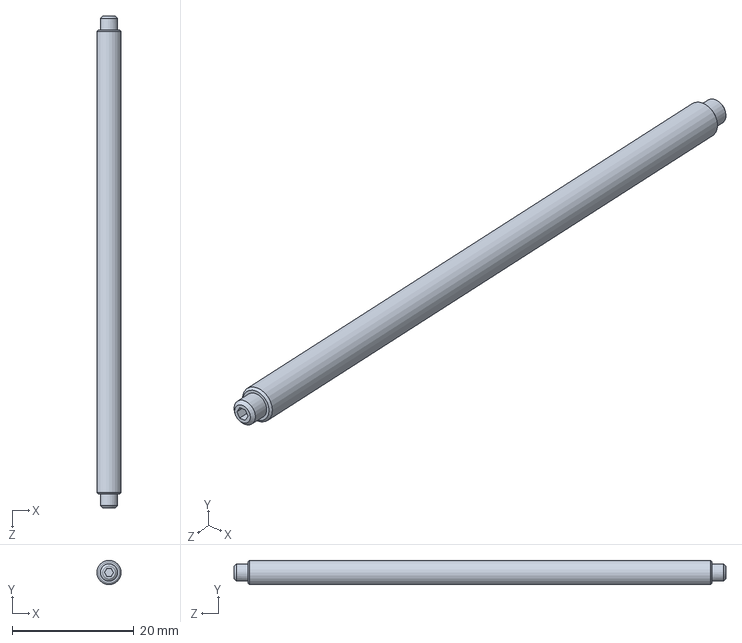
[picture p107: CAD file, 2026-06-09]
Gd-Source/CAD/GDLS/GDLS049.sldprt
3.99 x 3.99 x 80.8 mm
