eldarro/radio-isotope-vuv-light-source/Gd-Source/SIM/CAD/GDSIM018.SLDPRT

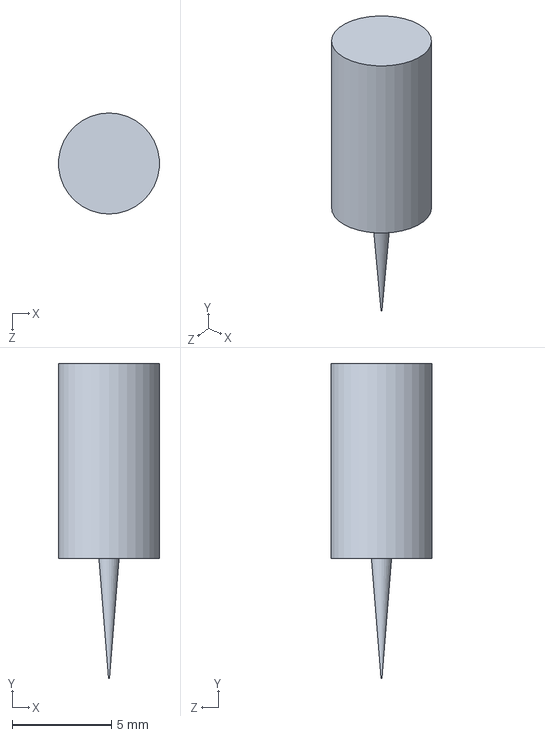
[picture p108: CAD file, 2026-06-09]
Gd-Source/SIM/CAD/GDSIM018.SLDPRT
5.06 x 15.8 x 5.08 mm
