eldarro/radio-isotope-vuv-light-source/Gd-Source/CAD/CFLS/CFLS0018.SLDPRT

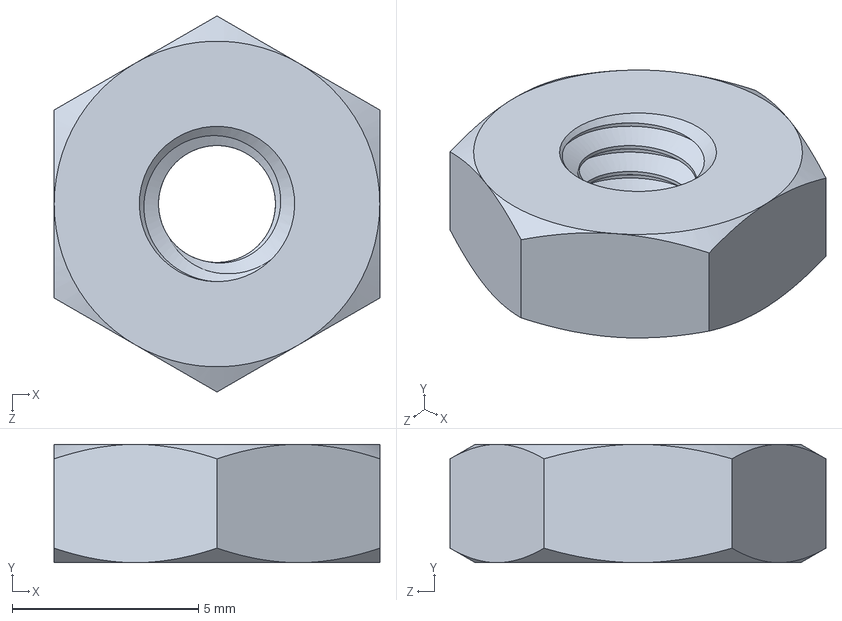
[picture p109: CAD file, 2026-06-09]
Gd-Source/CAD/CFLS/CFLS0018.SLDPRT
8.73 x 3.17 x 10.1 mm
