eldarro/radio-isotope-vuv-light-source/Gd-Source/CAD/GDLS/GDLS016.SLDPRT

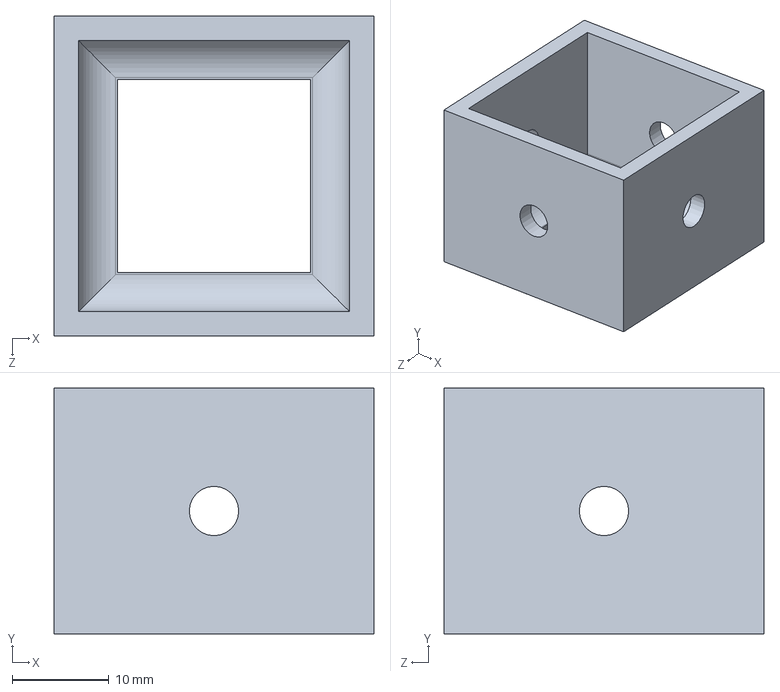
[picture p110: CAD file, 2026-06-09]
Gd-Source/CAD/GDLS/GDLS016.SLDPRT
33.1 x 25.4 x 33.1 mm
