eldarro/radio-isotope-vuv-light-source/Gd-Source/CAD/CFLS/CFLS0019.SLDPRT

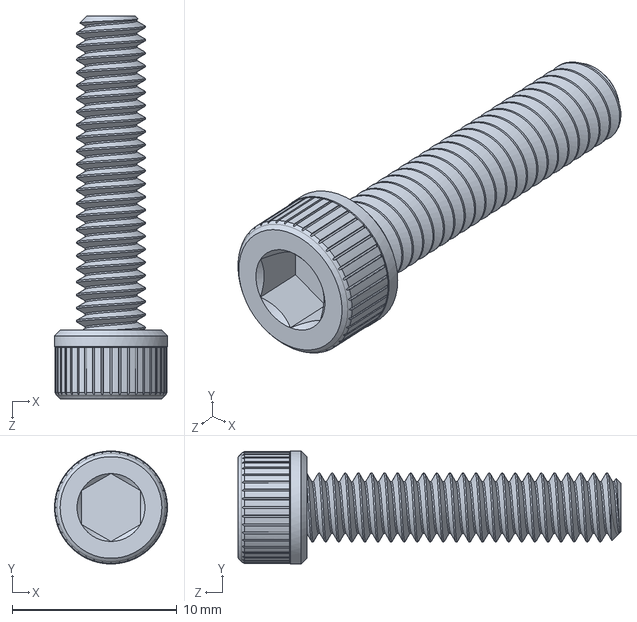
[picture p111: CAD file, 2026-06-09]
Gd-Source/CAD/CFLS/CFLS0019.SLDPRT
6.86 x 6.85 x 23.2 mm
