eldarro/radio-isotope-vuv-light-source/Gd-Source/CAD/GDLS/GDLS024.SLDPRT

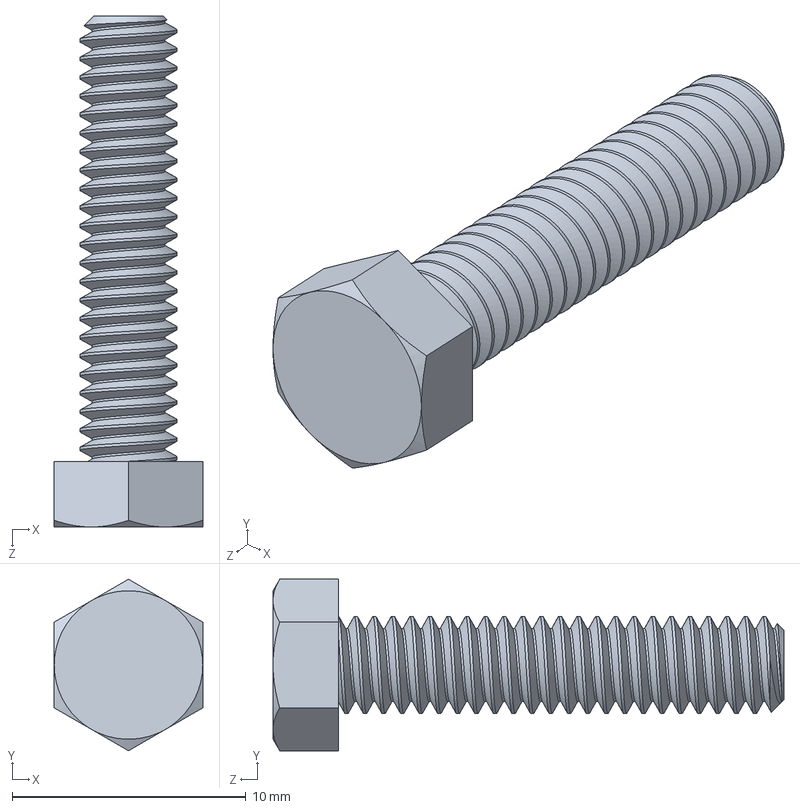
[picture p112: CAD file, 2026-06-09]
Gd-Source/CAD/GDLS/GDLS024.SLDPRT
6.35 x 7.33 x 21.8 mm
