eldarro/radio-isotope-vuv-light-source/Gd-Source/CAD/CFLS/CFLS0004.SLDPRT

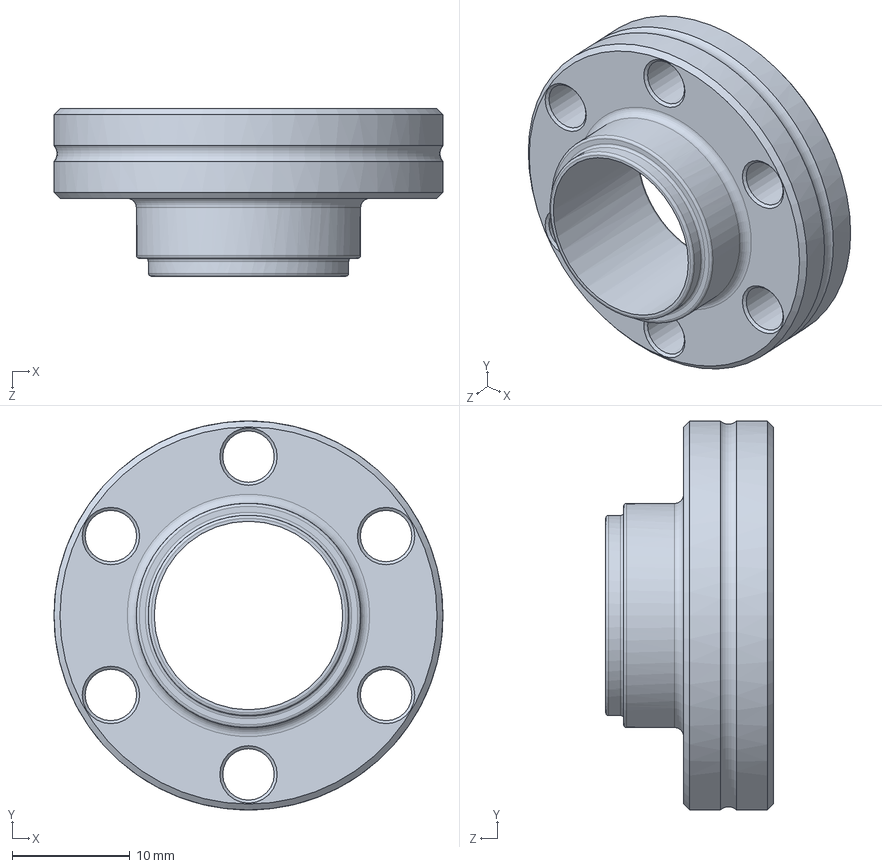
[picture p113: CAD file, 2026-06-09]
Gd-Source/CAD/CFLS/CFLS0004.SLDPRT
33.0 x 33.0 x 14.2 mm
