eldarro/radio-isotope-vuv-light-source/Gd-Source/CAD/CFLS/CFLS0015.SLDPRT

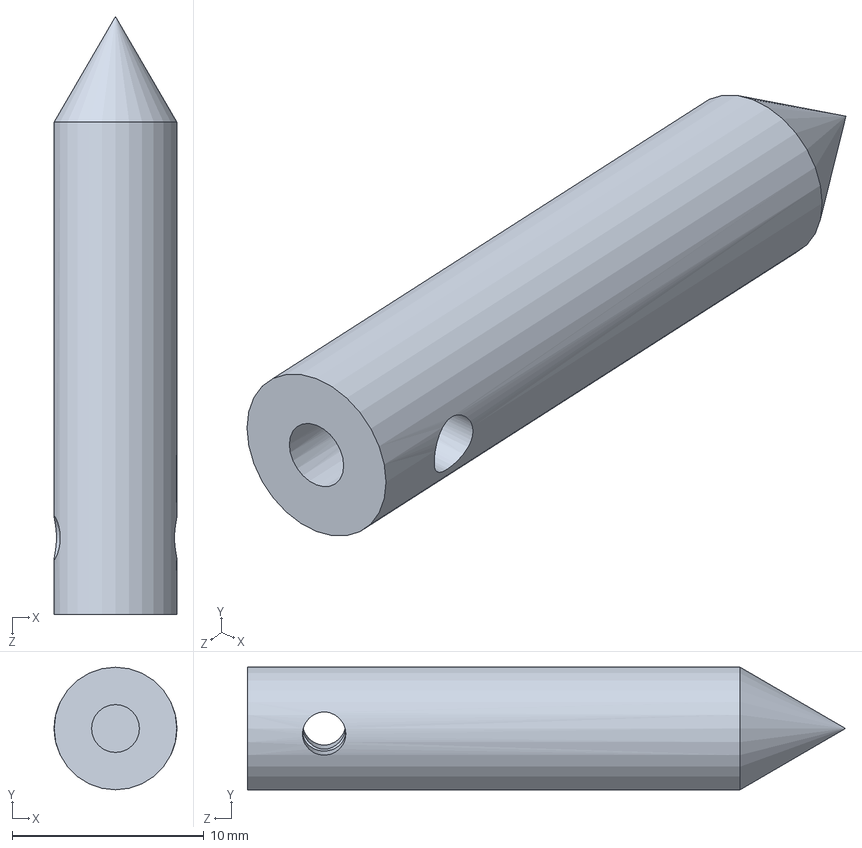
[picture p114: CAD file, 2026-06-09]
Gd-Source/CAD/CFLS/CFLS0015.SLDPRT
6.40 x 6.40 x 31.2 mm
