eldarro/radio-isotope-vuv-light-source/Gd-Source/CAD/GDLS/GDLS048.SLDPRT

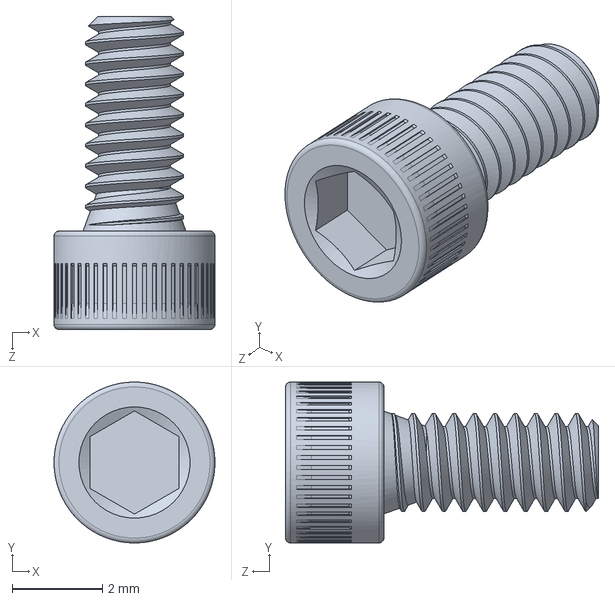
[picture p115: CAD file, 2026-06-09]
Gd-Source/CAD/GDLS/GDLS048.SLDPRT
3.57 x 3.57 x 6.95 mm
