eldarro/radio-isotope-vuv-light-source/Gd-Source/CAD/GDLS/GDLS050.SLDPRT

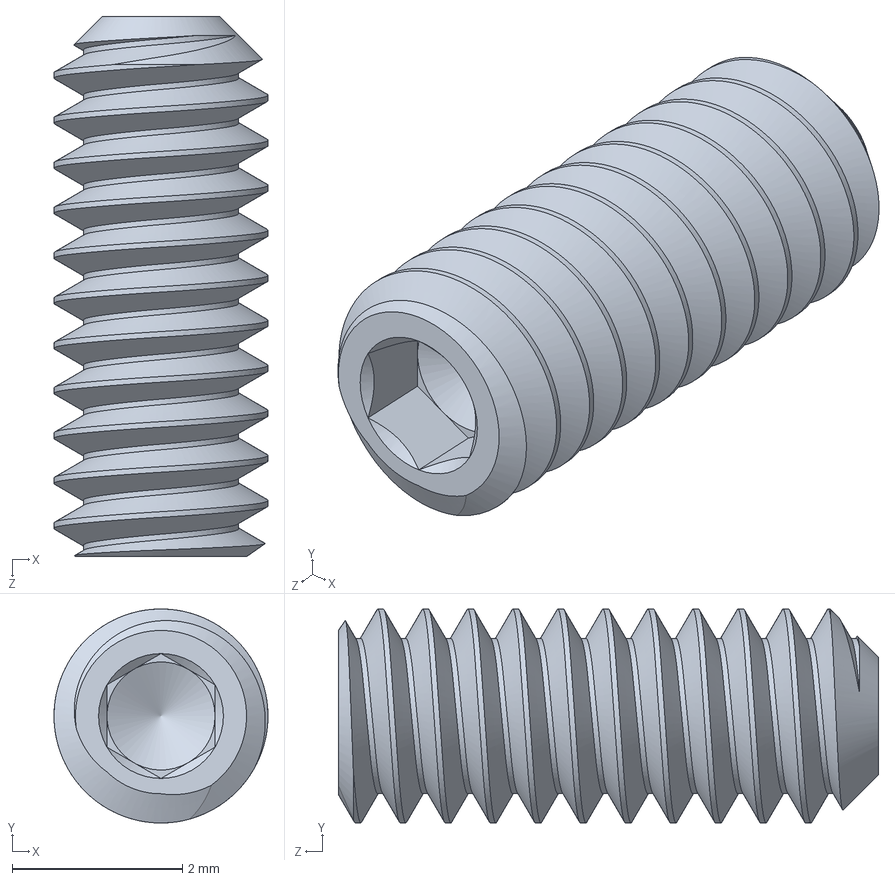
[picture p116: CAD file, 2026-06-09]
Gd-Source/CAD/GDLS/GDLS050.SLDPRT
2.51 x 2.51 x 6.35 mm
