eldarro/radio-isotope-vuv-light-source/Gd-Source/CAD/GDLS/GDLS045.SLDPRT

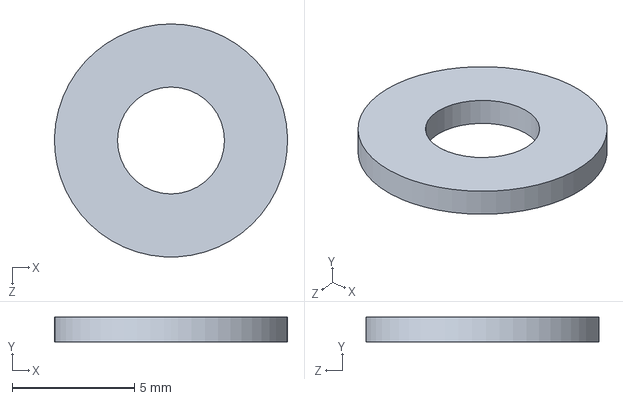
[picture p117: CAD file, 2026-06-09]
Gd-Source/CAD/GDLS/GDLS045.SLDPRT
9.52 x 1.02 x 9.53 mm
