eldarro/radio-isotope-vuv-light-source/Gd-Source/CAD/GDLS/GDLS052.SLDPRT

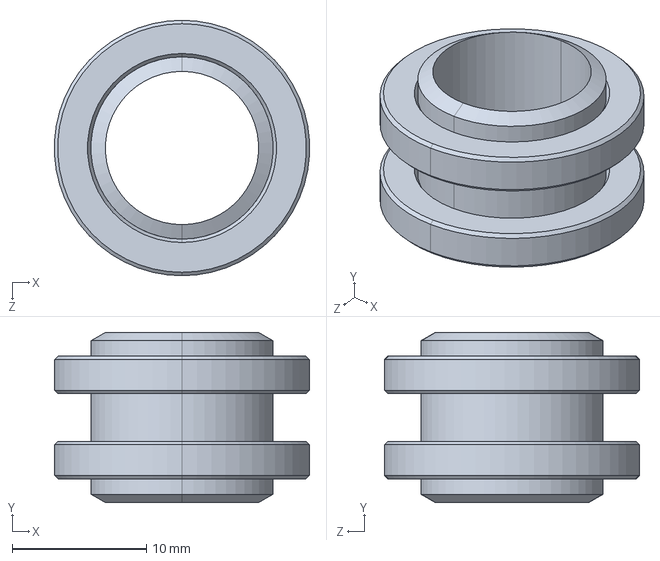
[picture p118: CAD file, 2026-06-09]
Gd-Source/CAD/GDLS/GDLS052.SLDPRT
19.0 x 12.7 x 19.1 mm
