eldarro/radio-isotope-vuv-light-source/Gd-Source/CAD/GDLS/GDLS018.SLDPRT

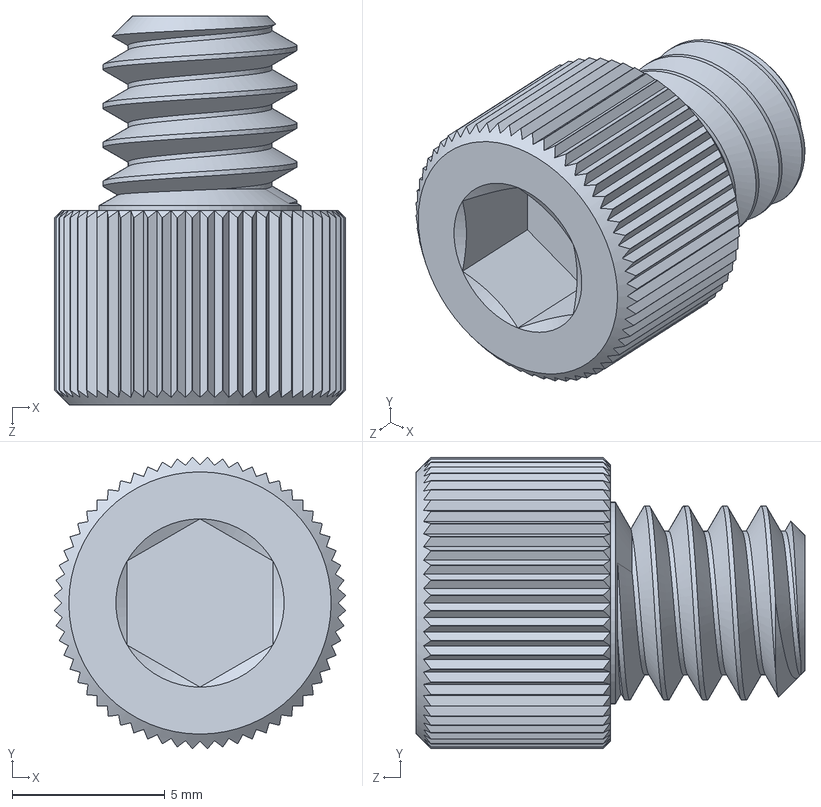
[picture p119: CAD file, 2026-06-09]
Gd-Source/CAD/GDLS/GDLS018.SLDPRT
9.51 x 9.51 x 12.7 mm
