eldarro/radio-isotope-vuv-light-source/Gd-Source/CAD/GDLS/GDLS007.SLDPRT

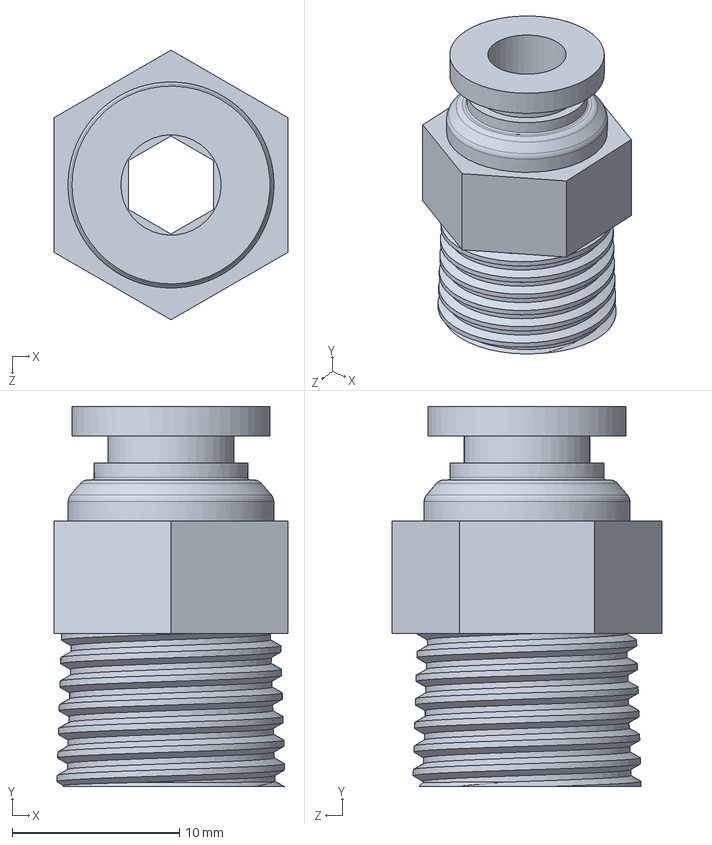
[picture p120: CAD file, 2026-06-09]
Gd-Source/CAD/GDLS/GDLS007.SLDPRT
14.0 x 22.7 x 16.1 mm
