eldarro/radio-isotope-vuv-light-source/Gd-Source/CAD/GDLS/GDLS034.SLDPRT

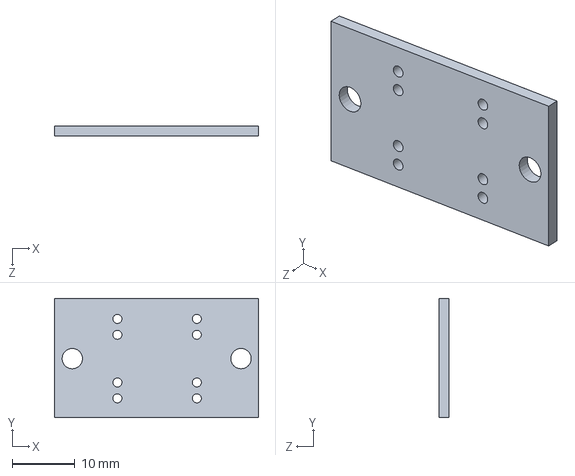
[picture p121: CAD file, 2026-06-09]
Gd-Source/CAD/GDLS/GDLS034.SLDPRT
32.6 x 19.1 x 1.58 mm
