eldarro/radio-isotope-vuv-light-source/Gd-Source/CAD/GDLS/GDLS041.SLDPRT

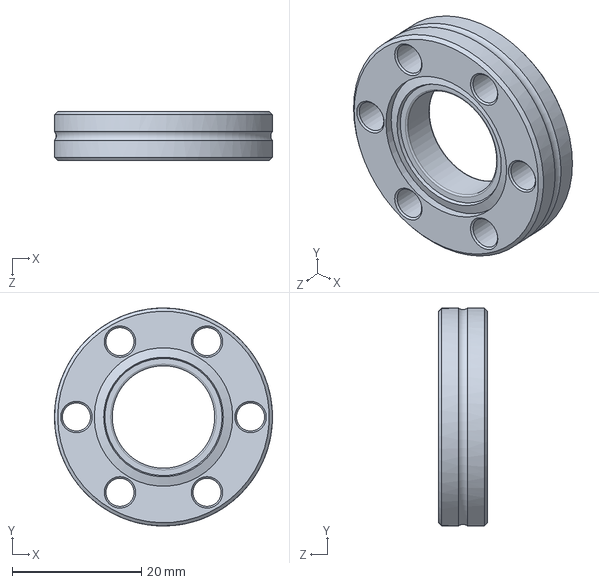
[picture p122: CAD file, 2026-06-09]
Gd-Source/CAD/GDLS/GDLS041.SLDPRT
33.8 x 33.8 x 7.62 mm
