eldarro/radio-isotope-vuv-light-source/Gd-Source/CAD/GDLS/GDLS014.SLDPRT

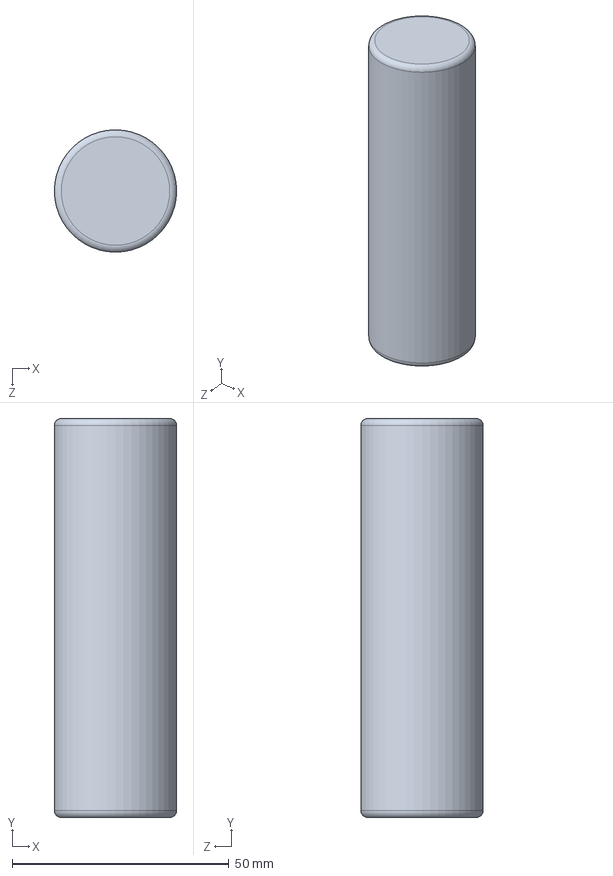
[picture p123: CAD file, 2026-06-09]
Gd-Source/CAD/GDLS/GDLS014.SLDPRT
28.2 x 92.0 x 28.2 mm
