eldarro/radio-isotope-vuv-light-source/Gd-Source/CAD/GDLS/GDLS036.SLDPRT

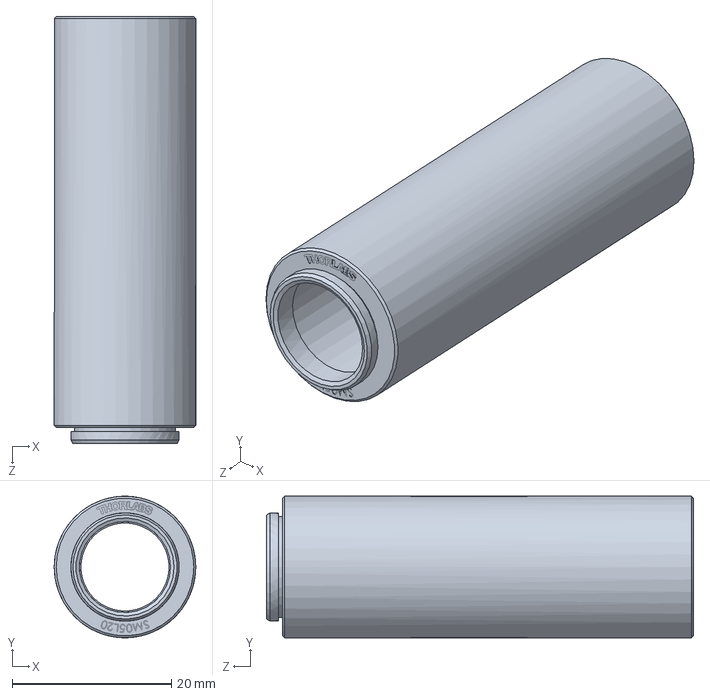
[picture p124: CAD file, 2026-06-09]
Gd-Source/CAD/GDLS/GDLS036.SLDPRT
17.8 x 17.8 x 53.6 mm
