eldarro/radio-isotope-vuv-light-source/Gd-Source/CAD/GDLS/GDLS023.SLDPRT

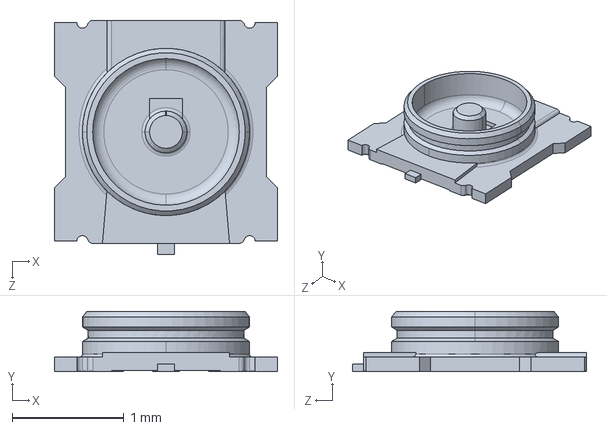
[picture p125: CAD file, 2026-06-09]
Gd-Source/CAD/GDLS/GDLS023.SLDPRT
2.00 x 0.54 x 2.10 mm
