eldarro/radio-isotope-vuv-light-source/Gd-Source/CAD/GDLS/GDLS057.sldprt

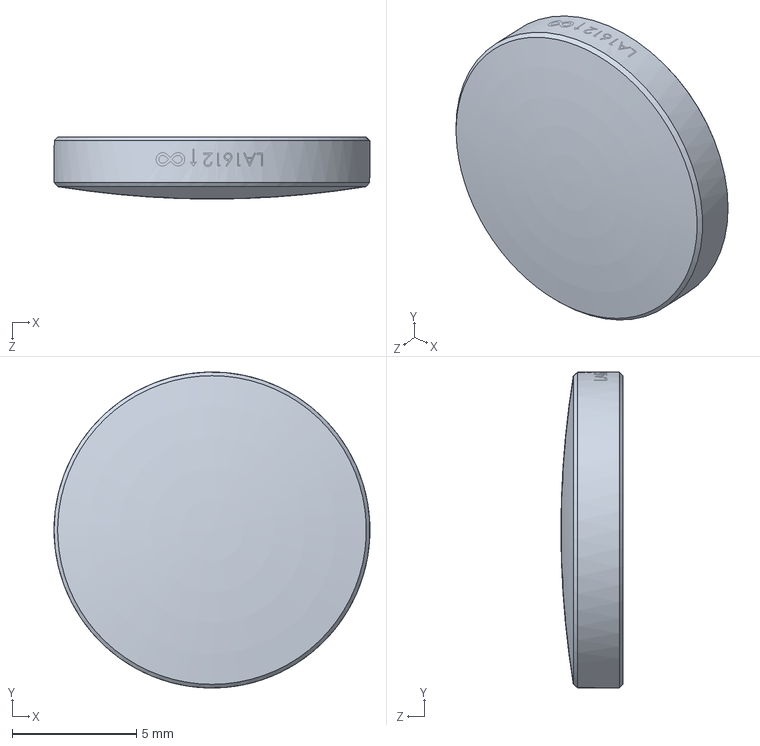
[picture p126: CAD file, 2026-06-09]
Gd-Source/CAD/GDLS/GDLS057.sldprt
12.7 x 12.7 x 2.50 mm
