eldarro/radio-isotope-vuv-light-source/Gd-Source/CAD/GDLS/GDLS017.SLDPRT

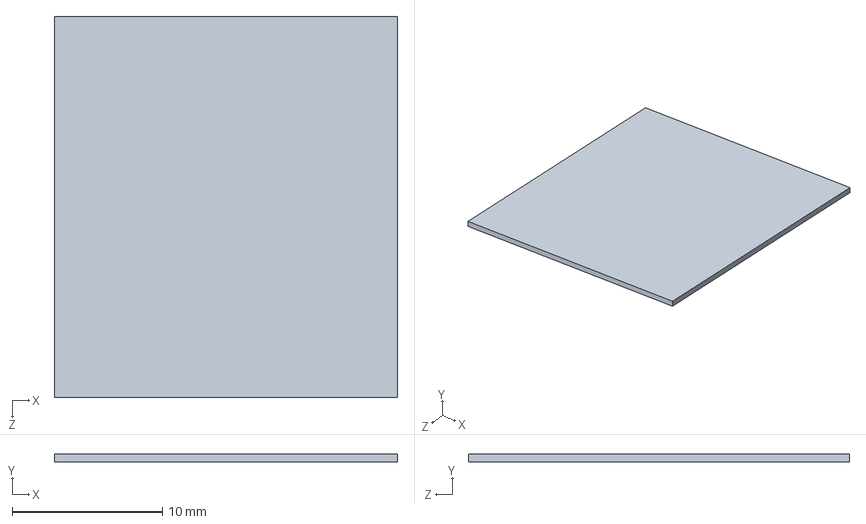
[picture p127: CAD file, 2026-06-09]
Gd-Source/CAD/GDLS/GDLS017.SLDPRT
22.9 x 0.508 x 25.4 mm
