eldarro/radio-isotope-vuv-light-source/Gd-Source/CAD/GDLS/GDLS025.SLDPRT

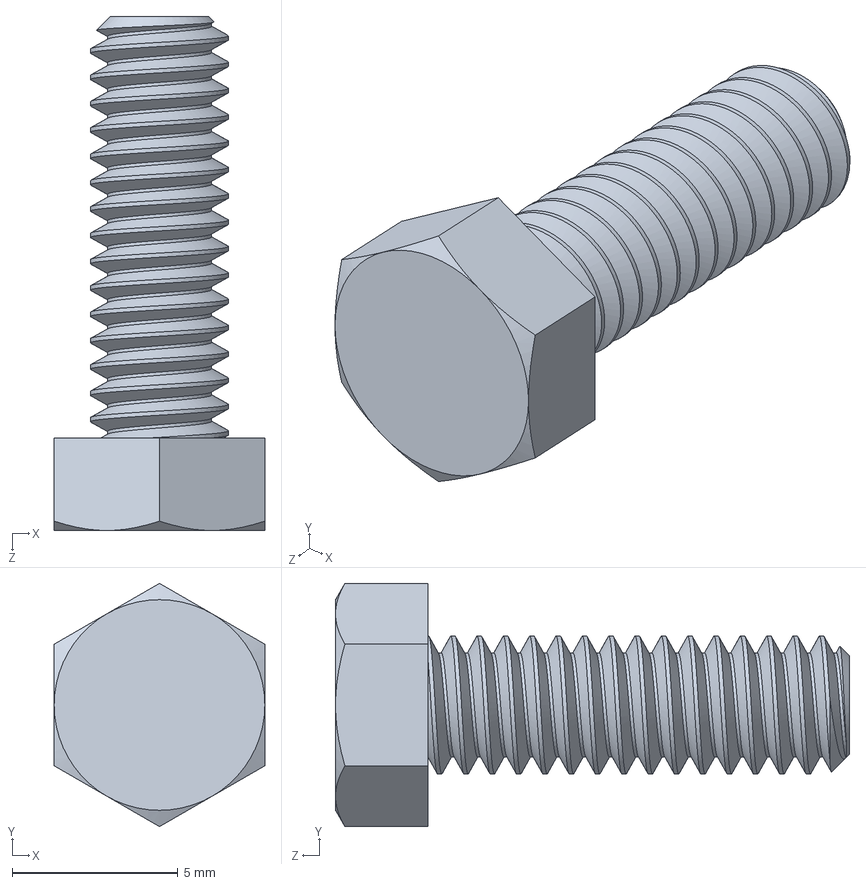
[picture p128: CAD file, 2026-06-09]
Gd-Source/CAD/GDLS/GDLS025.SLDPRT
6.35 x 7.33 x 15.5 mm
