eldarro/radio-isotope-vuv-light-source/Gd-Source/CAD/GDLS/GDLS051.sldprt

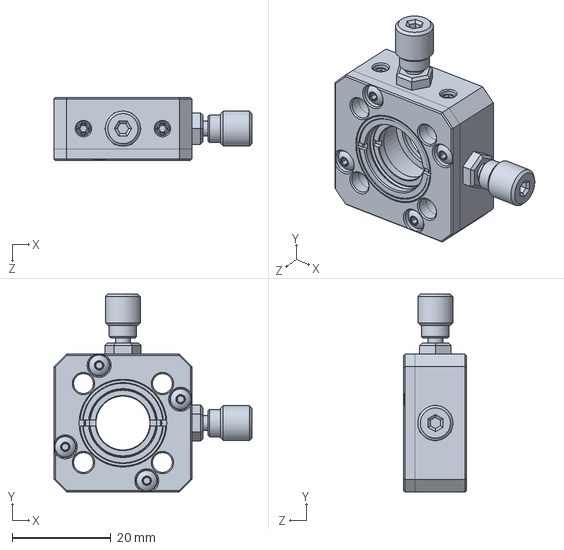
[picture p129: CAD file, 2026-06-09]
Gd-Source/CAD/GDLS/GDLS051.sldprt
40.1 x 40.1 x 12.7 mm
