eldarro/radio-isotope-vuv-light-source/Gd-Source/CAD/GDLS/GDLS042.SLDPRT

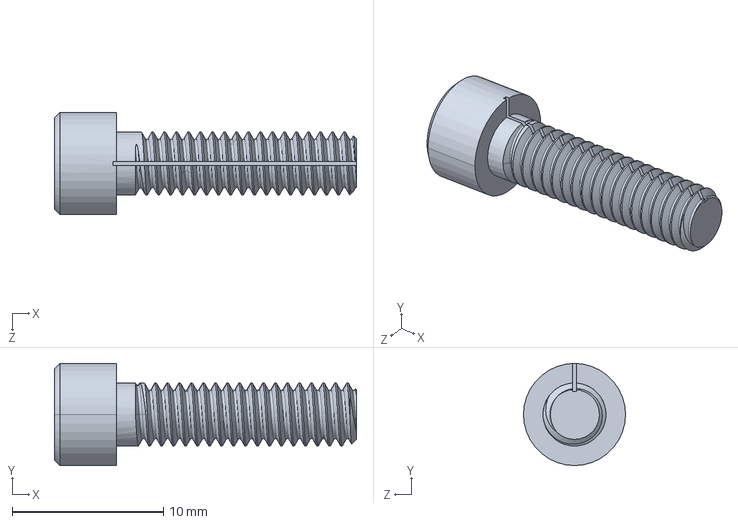
[picture p130: CAD file, 2026-06-09]
Gd-Source/CAD/GDLS/GDLS042.SLDPRT
20.0 x 6.76 x 6.76 mm
