eldarro/radio-isotope-vuv-light-source/Gd-Source/CAD/GDLS/GD047.SLDPRT

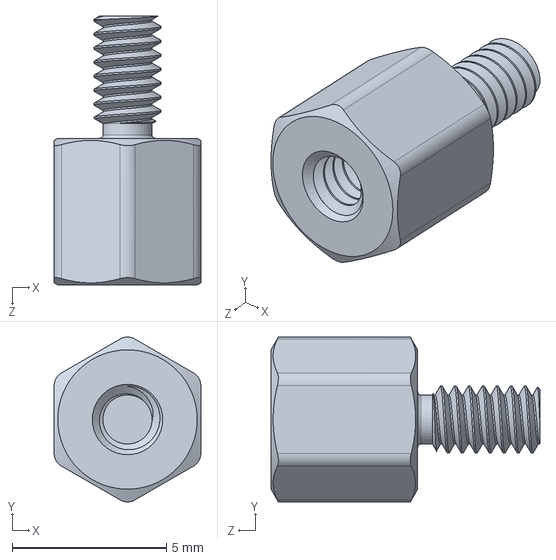
[picture p131: CAD file, 2026-06-09]
Gd-Source/CAD/GDLS/GD047.SLDPRT
4.76 x 5.35 x 8.73 mm
