eldarro/radio-isotope-vuv-light-source/Gd-Source/CAD/GDLS/GDLS061.sldprt

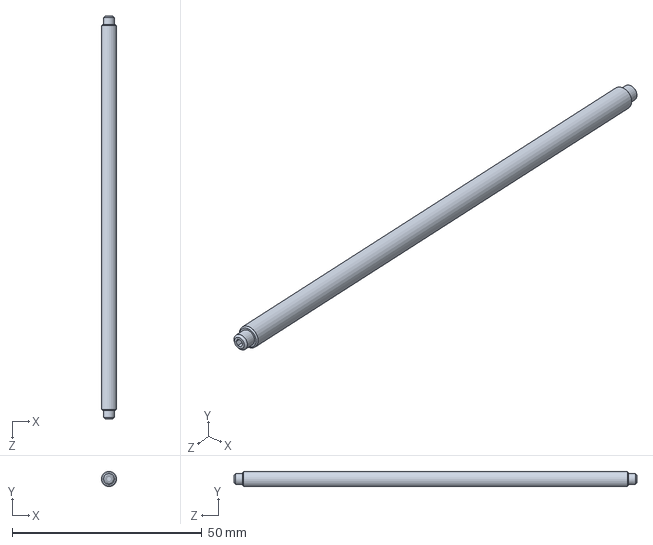
[picture p132: CAD file, 2026-06-09]
Gd-Source/CAD/GDLS/GDLS061.sldprt
3.99 x 3.99 x 106.2 mm
