eldarro/radio-isotope-vuv-light-source/Gd-Source/CAD/GDLS/GDLS054.sldprt

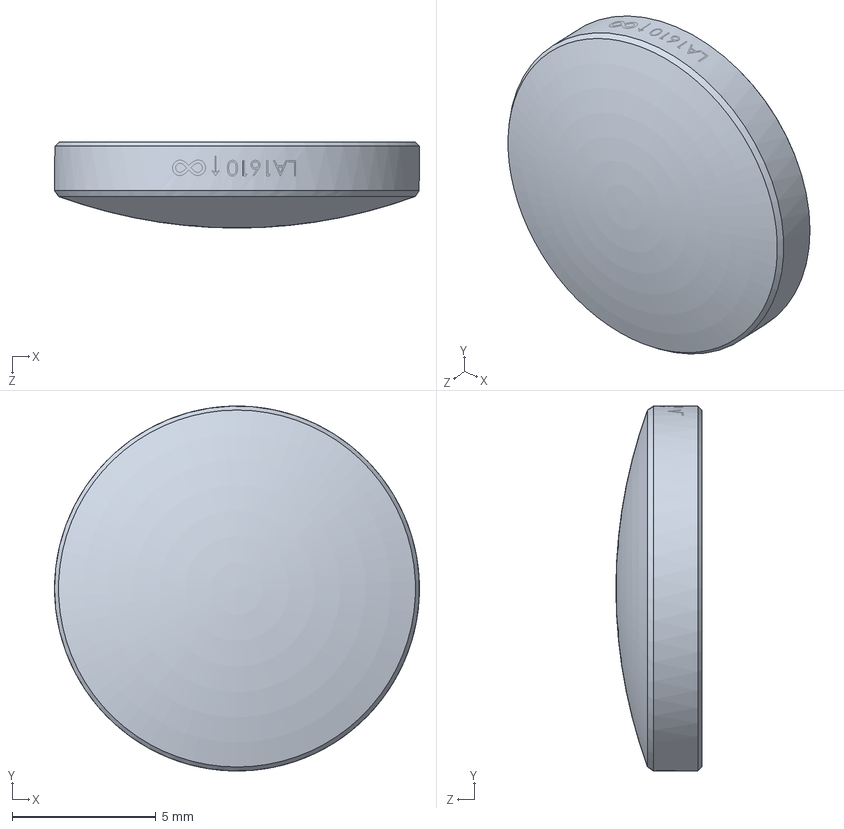
[picture p133: CAD file, 2026-06-09]
Gd-Source/CAD/GDLS/GDLS054.sldprt
12.7 x 12.7 x 3.00 mm
