eldarro/radio-isotope-vuv-light-source/Gd-Source/CAD/GDLS/GDLS056.sldprt

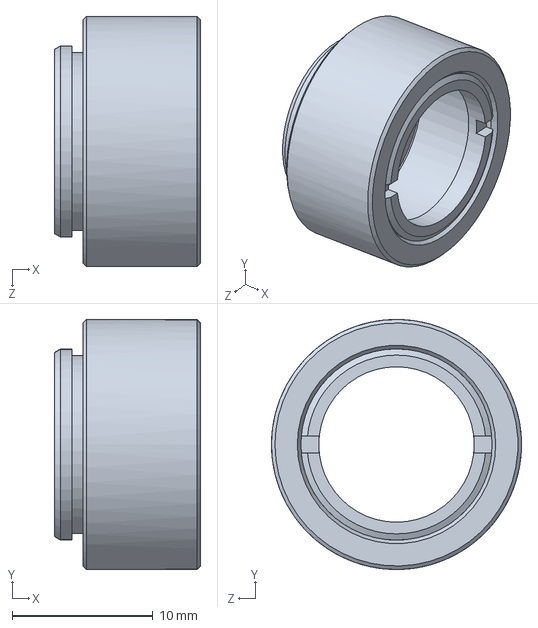
[picture p134: CAD file, 2026-06-09]
Gd-Source/CAD/GDLS/GDLS056.sldprt
10.4 x 17.8 x 17.8 mm
