eldarro/radio-isotope-vuv-light-source/Gd-Source/CAD/GDLS/GDLS026.SLDPRT

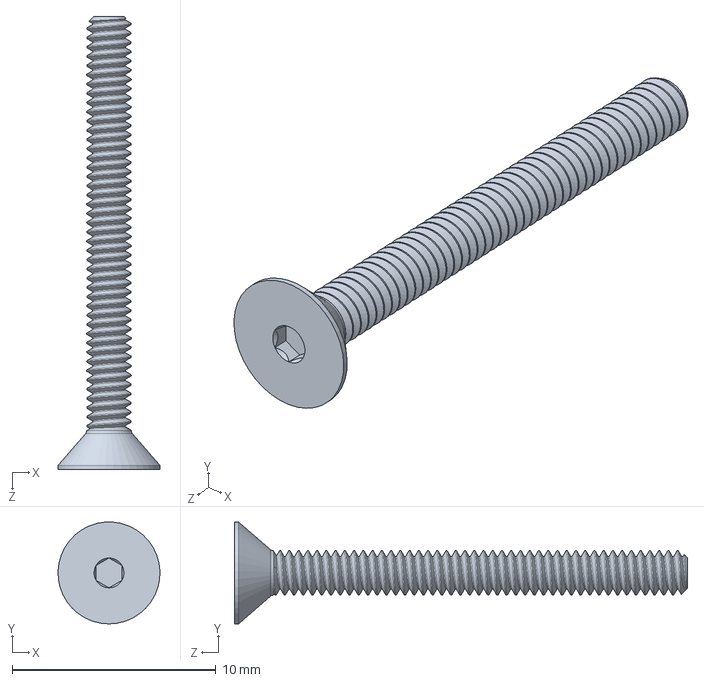
[picture p135: CAD file, 2026-06-09]
Gd-Source/CAD/GDLS/GDLS026.SLDPRT
5.00 x 5.00 x 22.2 mm
