eldarro/radio-isotope-vuv-light-source/Gd-Source/CAD/GDLS/GDLS059.sldprt

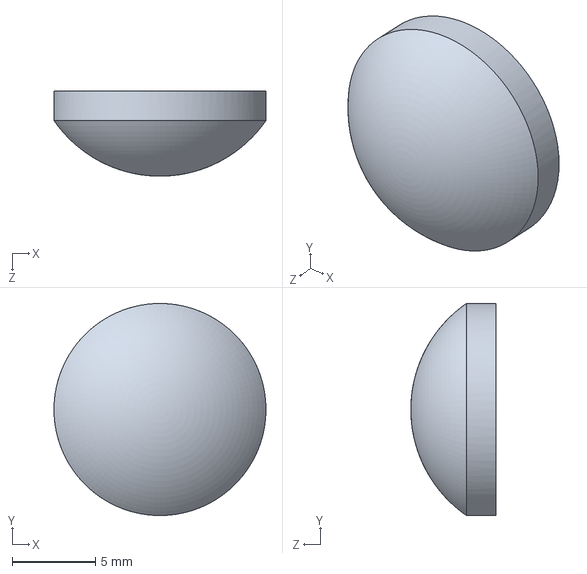
[picture p136: CAD file, 2026-06-09]
Gd-Source/CAD/GDLS/GDLS059.sldprt
12.7 x 12.7 x 5.12 mm
