eldarro/radio-isotope-vuv-light-source/Gd-Source/CAD/GDLS/GDLS030.SLDPRT

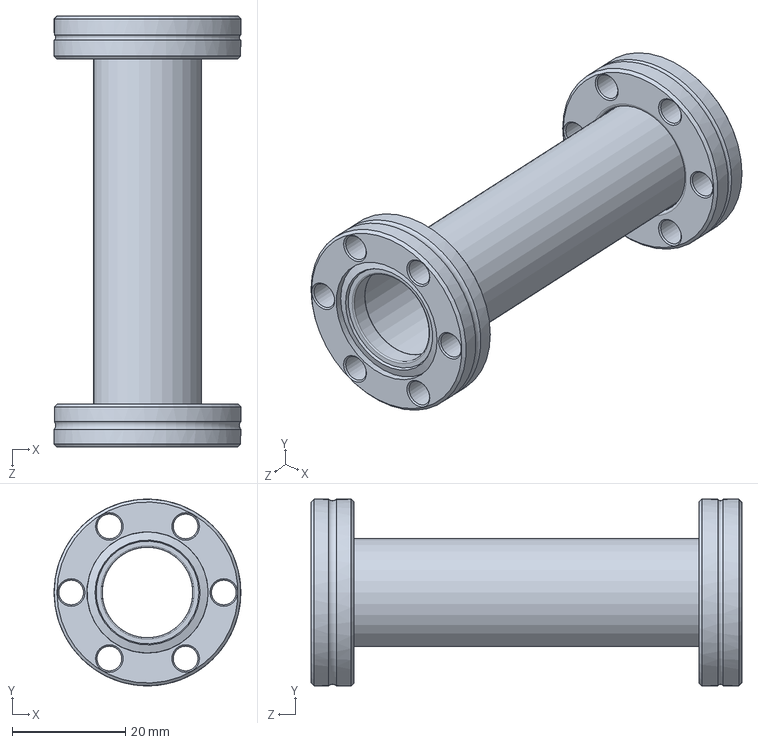
[picture p137: CAD file, 2026-06-09]
Gd-Source/CAD/GDLS/GDLS030.SLDPRT
33.0 x 33.0 x 76.2 mm
