eldarro/radio-isotope-vuv-light-source/Gd-Source/CAD/GDLS/GDLS020.SLDPRT

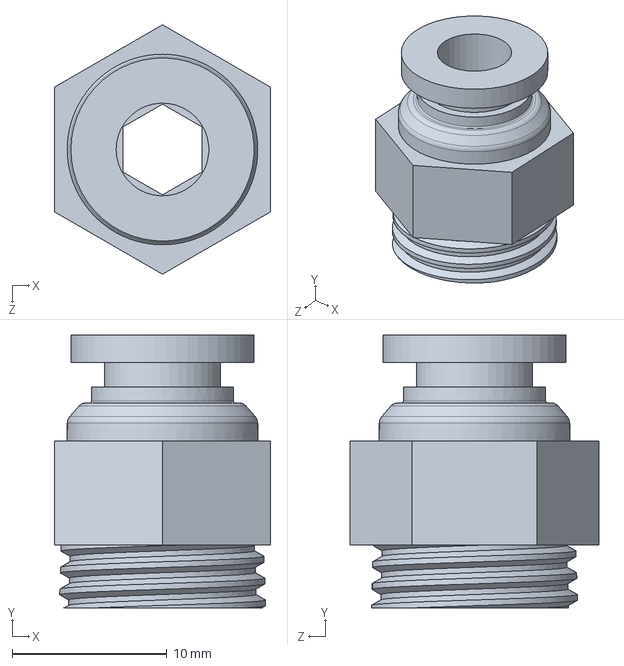
[picture p138: CAD file, 2026-06-09]
Gd-Source/CAD/GDLS/GDLS020.SLDPRT
14.0 x 17.7 x 16.1 mm
