eldarro/radio-isotope-vuv-light-source/Gd-Source/CAD/GDLS/GDLS002.SLDPRT

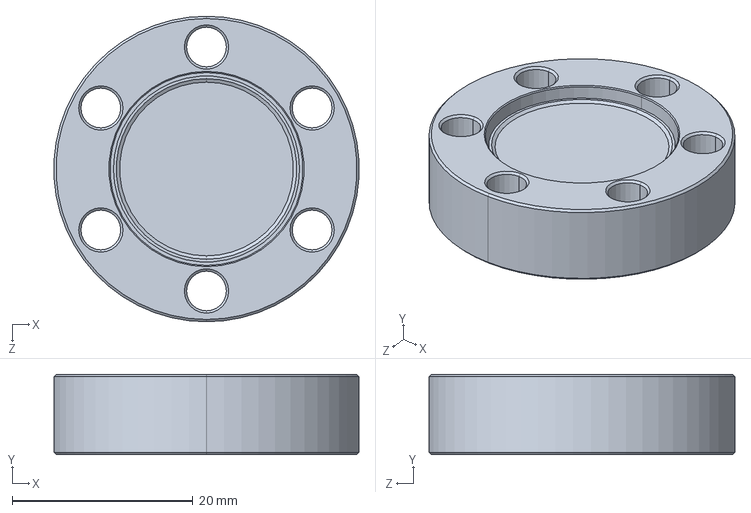
[picture p139: CAD file, 2026-06-09]
Gd-Source/CAD/GDLS/GDLS002.SLDPRT
33.7 x 8.89 x 33.8 mm
