eldarro/radio-isotope-vuv-light-source/Gd-Source/CAD/GDLS/GDLS003.SLDPRT

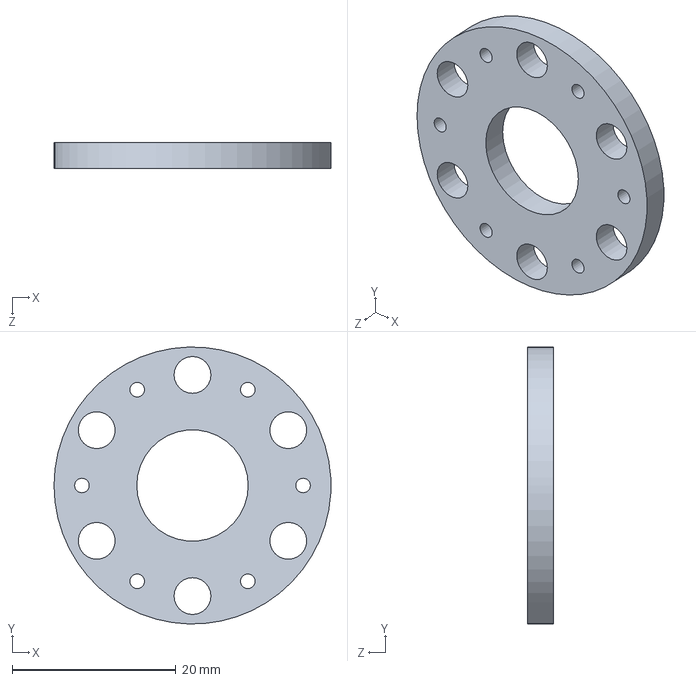
[picture p140: CAD file, 2026-06-09]
Gd-Source/CAD/GDLS/GDLS003.SLDPRT
33.8 x 33.8 x 3.17 mm
