eldarro/radio-isotope-vuv-light-source/Gd-Source/CAD/GDLS/GDLS021.SLDPRT

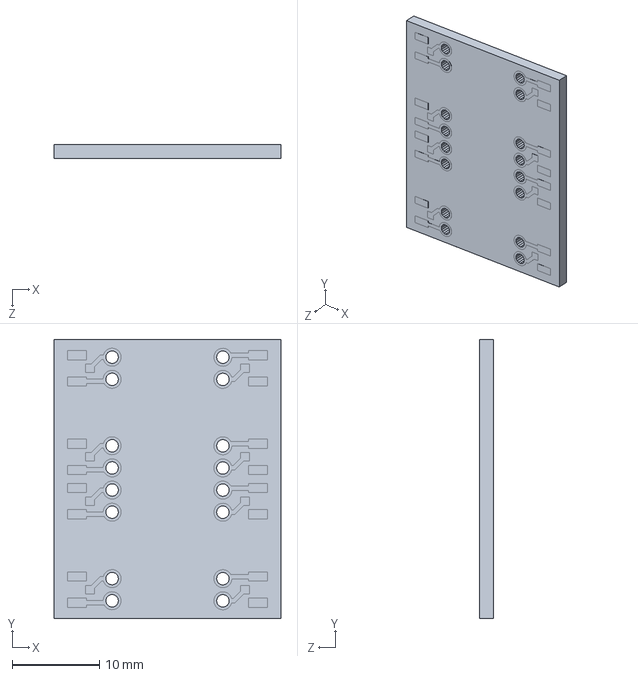
[picture p141: CAD file, 2026-06-09]
Gd-Source/CAD/GDLS/GDLS021.SLDPRT
26.0 x 32.0 x 1.63 mm
