eldarro/radio-isotope-vuv-light-source/Gd-Source/CAD/GDLS/GDLS060.sldprt

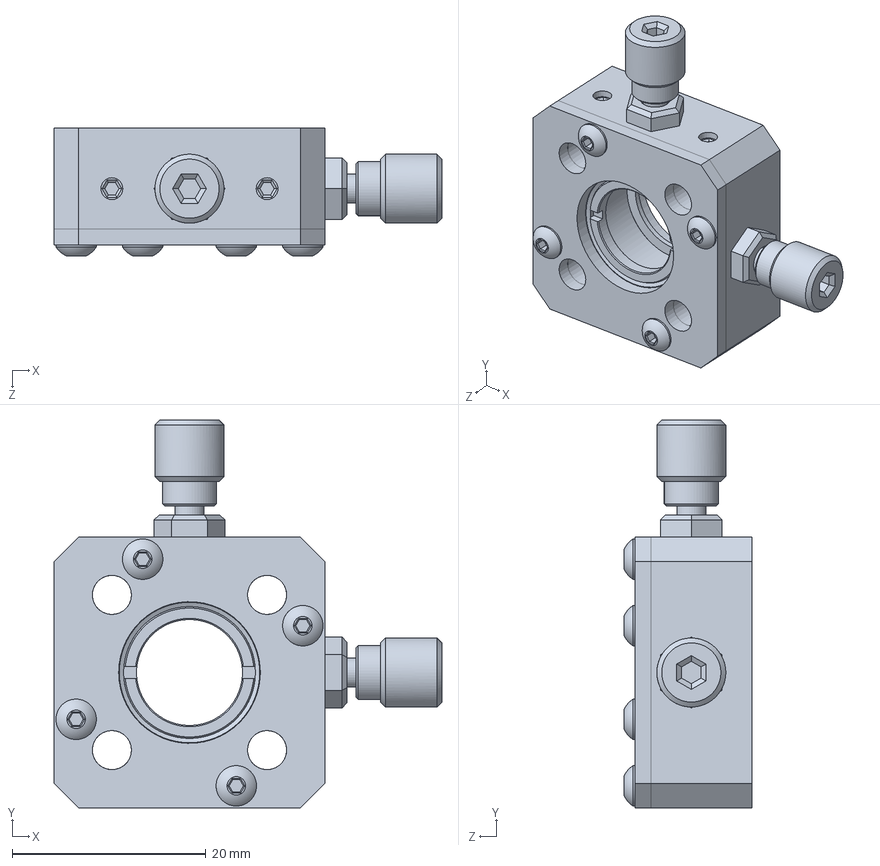
[picture p143: CAD file, 2026-06-09]
Gd-Source/CAD/GDLS/GDLS060.sldprt
40.0 x 40.0 x 13.2 mm
