eldarro/radio-isotope-vuv-light-source/Gd-Source/CAD/GDLS/GDLS029.SLDPRT

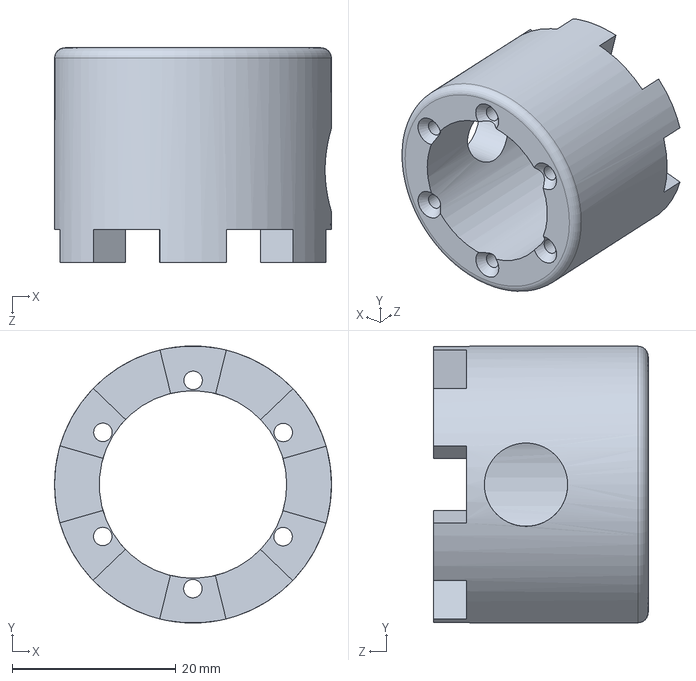
[picture p144: CAD file, 2026-06-09]
Gd-Source/CAD/GDLS/GDLS029.SLDPRT
33.8 x 33.7 x 26.2 mm
