eldarro/radio-isotope-vuv-light-source/Gd-Source/CAD/GDLS/GDLS027.SLDPRT

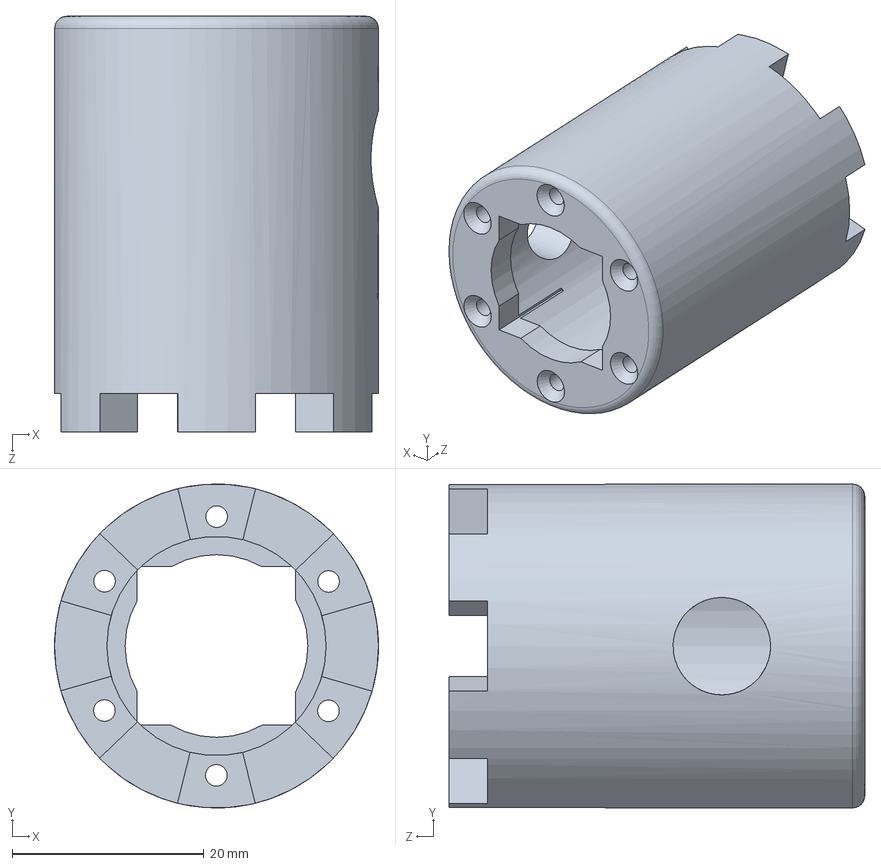
[picture p145: CAD file, 2026-06-09]
Gd-Source/CAD/GDLS/GDLS027.SLDPRT
33.8 x 33.8 x 43.3 mm
