eldarro/radio-isotope-vuv-light-source/Gd-Source/CAD/GDLS/GDLS004.SLDPRT

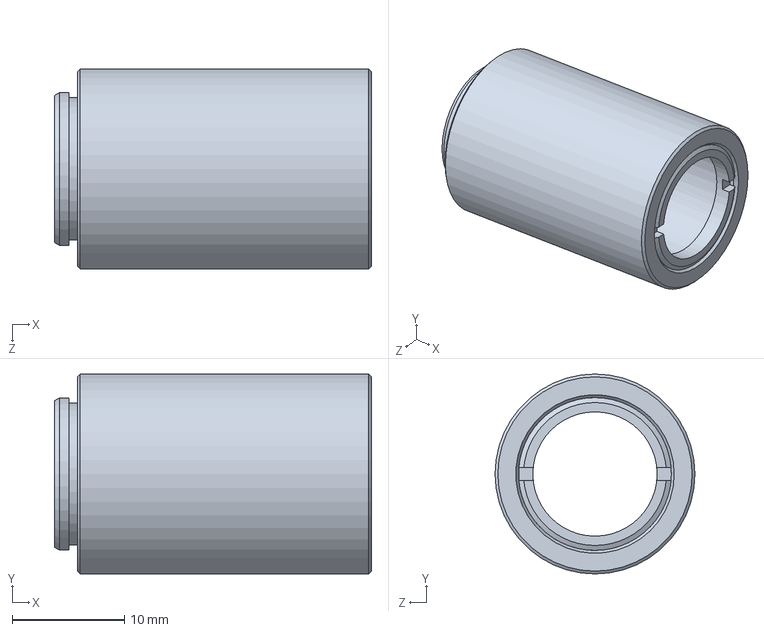
[picture p146: CAD file, 2026-06-09]
Gd-Source/CAD/GDLS/GDLS004.SLDPRT
28.2 x 17.8 x 17.8 mm
