eldarro/radio-isotope-vuv-light-source/Gd-Source/CAD/GDLS/GDLS013.SLDPRT

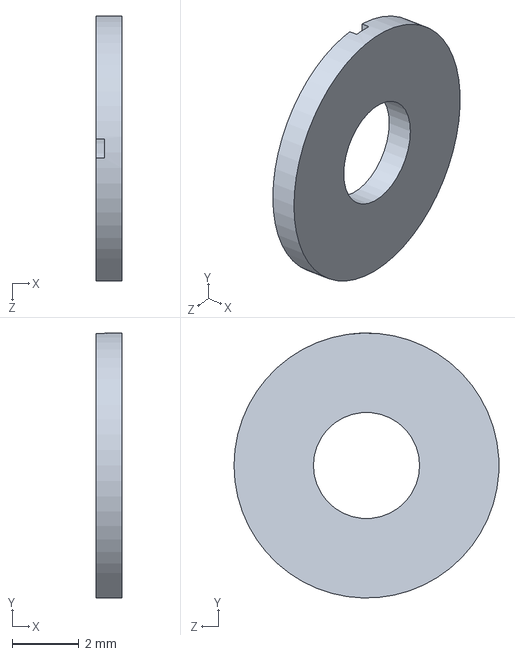
[picture p147: CAD file, 2026-06-09]
Gd-Source/CAD/GDLS/GDLS013.SLDPRT
0.787 x 7.92 x 7.92 mm
