eldarro/radio-isotope-vuv-light-source/Gd-Source/CAD/GDLS/GDLS15.SLDASM

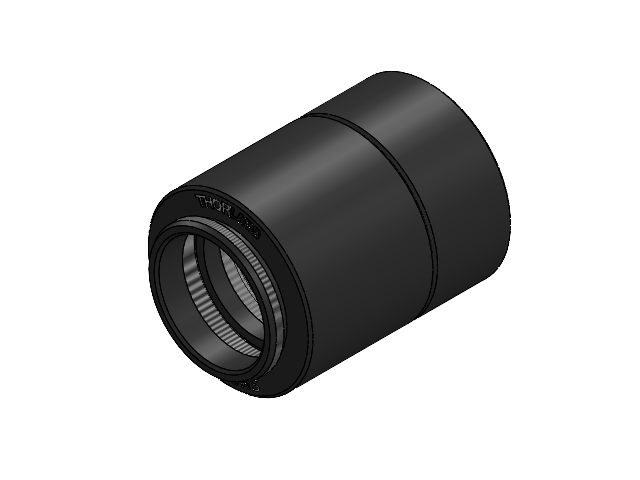
[picture p148: CAD file, 2026-06-09]
Gd-Source/CAD/GDLS/GDLS15.SLDASM
GDLS053
GDLS054
GDLS055 x 3
GDLS056
GDLS057
