eldarro/radio-isotope-vuv-light-source/Gd-Source/CAD/GDLS/GDLS12.SLDASM

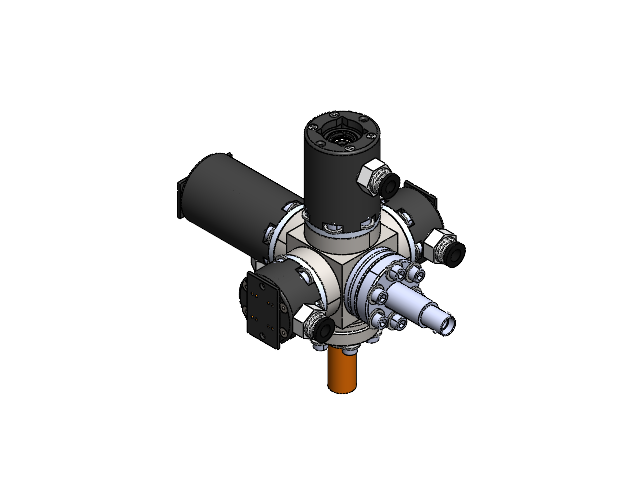
[picture p149: CAD file, 2026-06-09]
Gd-Source/CAD/GDLS/GDLS12.SLDASM
GDLS001
GDLS002 x 4
GDLS003 x 4
GDLS037
GDLS006 x 2
GDLS044 x 24
GDLS027
GDLS028 x 8
GDLS020 x 4
GDLS045 x 36
GDLS019 x 2
GDLS026 x 12
GDLS034 x 3
GDLS022 x 3
GDLS033
GDLS036
GDLS005 x 2
GDLS035
GDLS009
GDLS012
GDLS011
GDLS043 x 12
GDLS039
GDLS040
GDLS041
