eldarro/radio-isotope-vuv-light-source/Gd-Source/CAD/GDLS/GDLS00.SLDASM

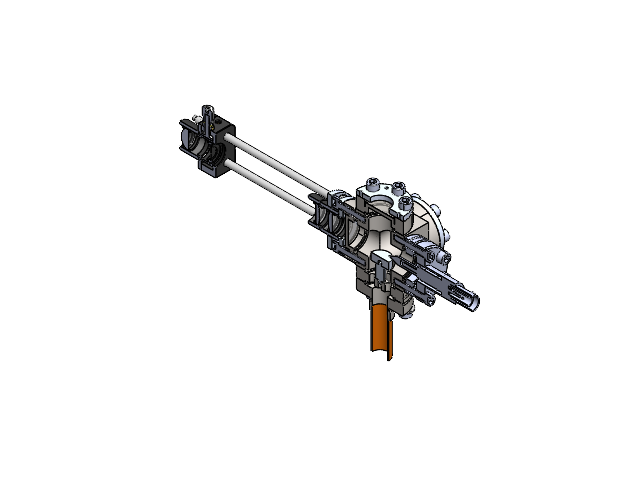
[picture p150: CAD file, 2026-06-09]
Gd-Source/CAD/GDLS/GDLS00.SLDASM
GDLS001
GDLS035
GDLS009
GDLS012
GDLS011
GDLS043 x 12
GDLS045 x 6
GDLS039
GDLS040
GDLS041
GDLS002 x 4
GDLS003 x 4
GDLS044 x 24
GDLS046
GD047 x 6
GDLS048 x 6
GDLS061 x 4
GDLS050 x 4
GDLS058
GDLS055 x 6
GDLS059
GDLS051
GDLS053 x 2
GDLS054
GDLS056
GDLS057
