eldarro/radio-isotope-vuv-light-source/Gd-Source/CAD/GDLS/GDLS14.SLDASM

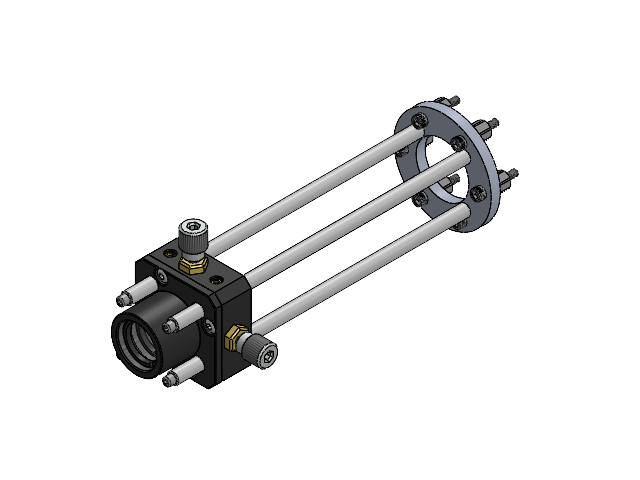
[picture p151: CAD file, 2026-06-09]
Gd-Source/CAD/GDLS/GDLS14.SLDASM
GDLS046
GD047 x 6
GDLS048 x 6
GDLS061 x 4
GDLS050 x 4
GDLS058
GDLS055 x 3
GDLS059
GDLS051
GDLS053
