eldarro/radio-isotope-vuv-light-source/Gd-Source/CAD/GDLS/GDLS13.SLDASM

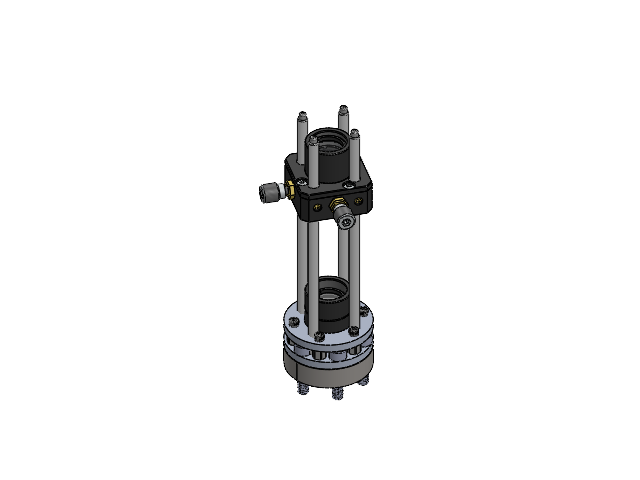
[picture p152: CAD file, 2026-06-09]
Gd-Source/CAD/GDLS/GDLS13.SLDASM
GDLS002
GDLS003
GDLS044 x 6
GDLS046
GD047 x 6
GDLS048 x 6
GDLS061 x 4
GDLS050 x 4
GDLS058
GDLS055 x 6
GDLS059
GDLS051
GDLS053 x 2
GDLS054
GDLS056
GDLS057
