eldarro/radio-isotope-vuv-light-source/Gd-Source/CAD/GDLS/GDLS11.SLDASM

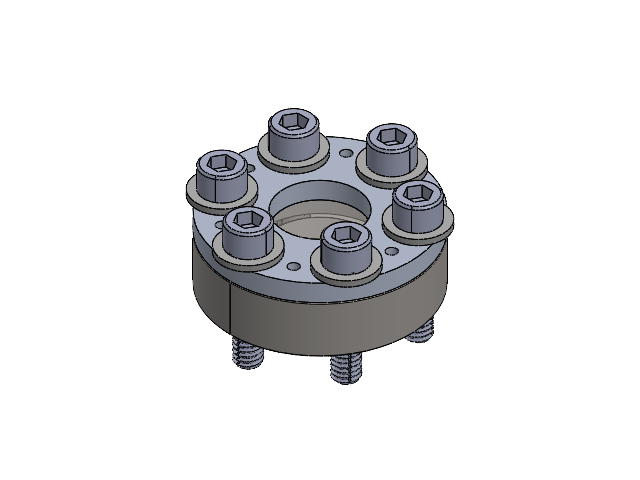
[picture p153: CAD file, 2026-06-09]
Gd-Source/CAD/GDLS/GDLS11.SLDASM
GDLS002
GDLS003
GDLS044 x 6
