eldarro/radio-isotope-vuv-light-source/(list of files, cad)

Other CAD files:
Gd-Source/CAD/CFLS/CFLS0007.SLDPRT
Gd-Source/CAD/CFLS/CFLS0023.SLDPRT
Gd-Source/CAD/CFLS/CFLS0012.SLDPRT
Gd-Source/CAD/GDLS/GDLS009.SLDPRT
Gd-Source/CAD/GDLS/GDLS038.SLDPRT
Gd-Source/CAD/CFLS/CFLS0024.SLDPRT
Gd-Source/SIM/CAD/GDSIM008.SLDPRT
Gd-Source/CAD/CFLS/CFLS0027.SLDPRT
Gd-Source/CAD/GDLS/GDLS031.SLDPRT
Gd-Source/CAD/GDLS/GDLS058.sldprt
Gd-Source/CAD/GDLS/GDLS008.SLDPRT
Gd-Source/CAD/GDLS/GDLS011.SLDPRT
Gd-Source/CAD/GDLS/GDLS032.SLDPRT
Gd-Source/CAD/GDLS/GDLS005.SLDPRT
Gd-Source/CAD/CFLS/drawings/CFLS0026.SLDDRW
Gd-Source/CAD/CFLS/parts/90257A009_Super-Corrosion-Resistant 316 Stainless Steel Hex Nut.SLDPRT
Gd-Source/CAD/CFLS/parts/92185A197_Super-Corrosion-Resistant 316 Stainless Steel Socket Head Screw.SLDPRT
Gd-Source/CAD/CFLS/parts/92185A200_Super-Corrosion-Resistant 316 Stainless Steel Socket Head Screw.SLDPRT
Gd-Source/CAD/CFLS/parts/92186A551_Super-Corrosion-Resistant 316 Stainless Steel Hex Head Screw.SLDPRT
Gd-Source/CAD/CFLS/parts/94804A029_Super-Corrosion-Resistant 316 Stainless Steel Hex Nut.SLDPRT
Gd-Source/CAD/GDLS/GDLS019.STL
Gd-Source/CAD/GDLS/GDLS027.STL
Gd-Source/CAD/GDLS/GDLS033.STL
Gd-Source/CAD/GDLS/drawings/GDLS003.SLDDRW
Gd-Source/CAD/GDLS/drawings/GDLS040.SLDDRW
Gd-Source/CAD/GDLS/drawings/GDLS041.SLDDRW
Gd-Source/CAD/GDLS/drawings/GDLS046.SLDDRW
Gd-Source/SIM/CAD/Part1^Assem2.STL
