eldarro/radio-isotope-vuv-light-source/Gd-Source/CAD/CFLS/drawings/CFLS0026.pdf

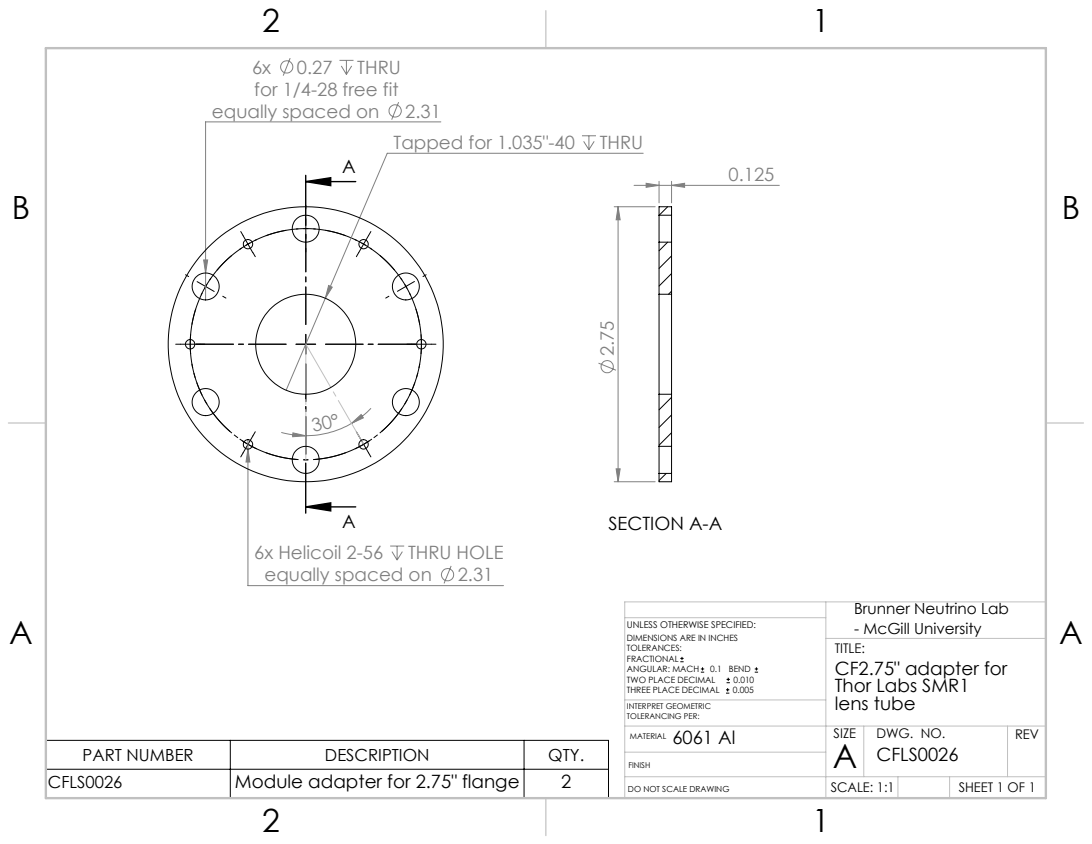
[picture p154: page 1]
SECTION A-A; CF2.75" adapter for Thor Labs SMR1 lens tube; DWG. NO.; TWO PLACE DECIMAL; Brunner Neutrino Lab - McGill University

6x 0.27 THRU
for 1/4-28 free fit
equally spaced on 2.31

Tapped for 1.035"-40 THRU

6x Helicoil 2-56 THRU HOLE

UNLESS OTHERWISE SPECIFIED:
DIMENSIONS ARE IN INCHES
TOLERANCES:
FRACTIONAL
ANGULAR: MACH 0.1 BEND
THREE PLACE DECIMAL 0.005
INTERPRET GEOMETRIC
TOLERANCING PER:

PART NUMBER | DESCRIPTION | QTY.
CFLS0026 | Module adapter for 2.75" flange | 2

DO NOT SCALE DRAWING | SCALE: 1:1 | SHEET 1 OF 1
