eldarro/radio-isotope-vuv-light-source/Gd-Source/CAD/GDLS/drawings/GDLS003.pdf

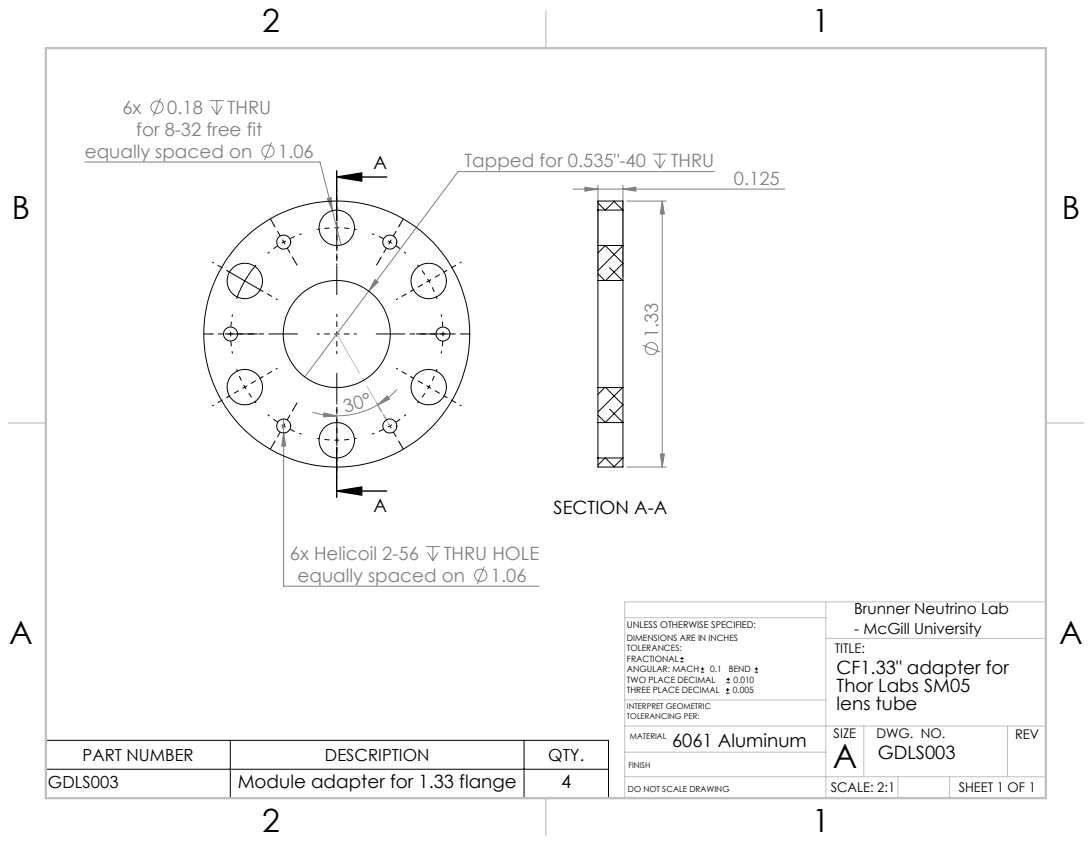
[picture p155: page 1]
SECTION A-A; DWG. NO.; TWO PLACE DECIMAL

6x 0.18 THRU
for 8-32 free fit
equally spaced on 1.06

Tapped for 0.535"-40 THRU

6x Helicoil 2-56 THRU HOLE

Brunner Neutrino Lab
- McGill University
TITLE:
CF1.33" adapter for
Thor Labs SM05
lens tube
SIZE

UNLESS OTHERWISE SPECIFIED:
DIMENSIONS ARE IN INCHES
TOLERANCES:
FRACTIONAL
ANGULAR: MACH 0.1 BEND
THREE PLACE DECIMAL 0.005
INTERPRET GEOMETRIC
TOLERANCING PER:
GDLS003 6061 Aluminum

PART NUMBER | DESCRIPTION | QTY.
GDLS003 | Module adapter for 1.33 flange | 4

DO NOT SCALE DRAWING | SCALE: 2:1 | SHEET 1 OF 1
