eldarro/radio-isotope-vuv-light-source/Gd-Source/CAD/GDLS/drawings/GDLS040.pdf

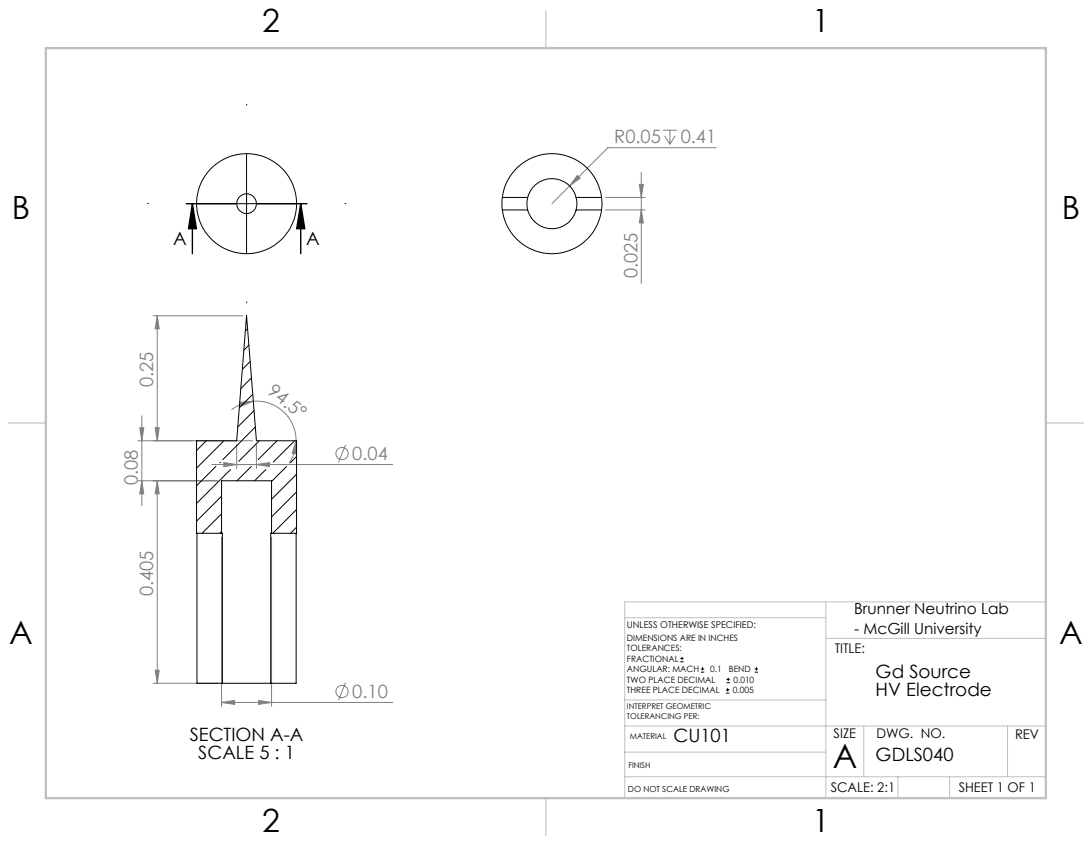
[picture p156: page 1]
SECTION A-A SCALE 5 : 1; Gd Source HV Electrode; DWG. NO.; TWO PLACE DECIMAL; DO NOT SCALE DRAWING; SCALE: 2:1; SHEET 1 OF 1; Brunner Neutrino Lab - McGill University

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
