eldarro/radio-isotope-vuv-light-source/Gd-Source/CAD/GDLS/drawings/GDLS041.pdf

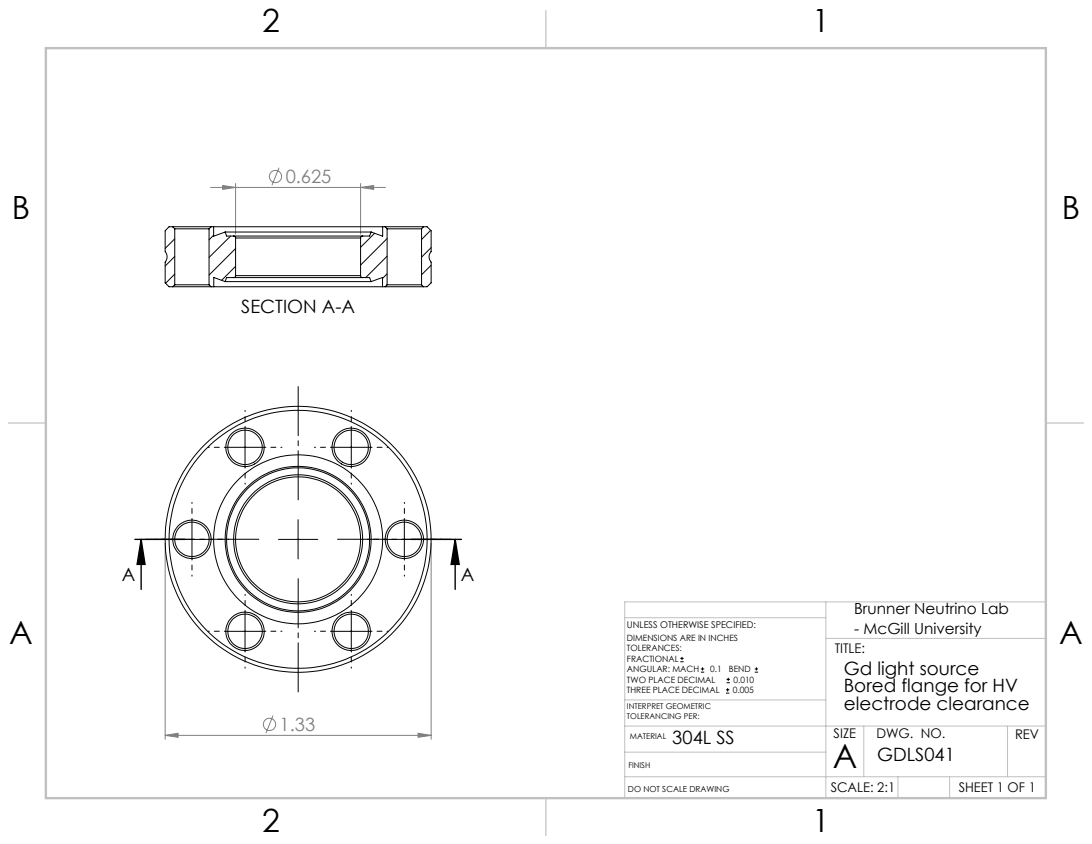
[picture p157: page 1]
SECTION A-A; DWG. NO.; TWO PLACE DECIMAL; DO NOT SCALE DRAWING; SCALE: 2:1; SHEET 1 OF 1

Brunner Neutrino Lab
- McGill University
TITLE:
Gd light source
Bored flange for HV
electrode clearance
SIZE
GDLS041

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
