eldarro/radio-isotope-vuv-light-source/Gd-Source/CAD/GDLS/drawings/GDLS046.pdf

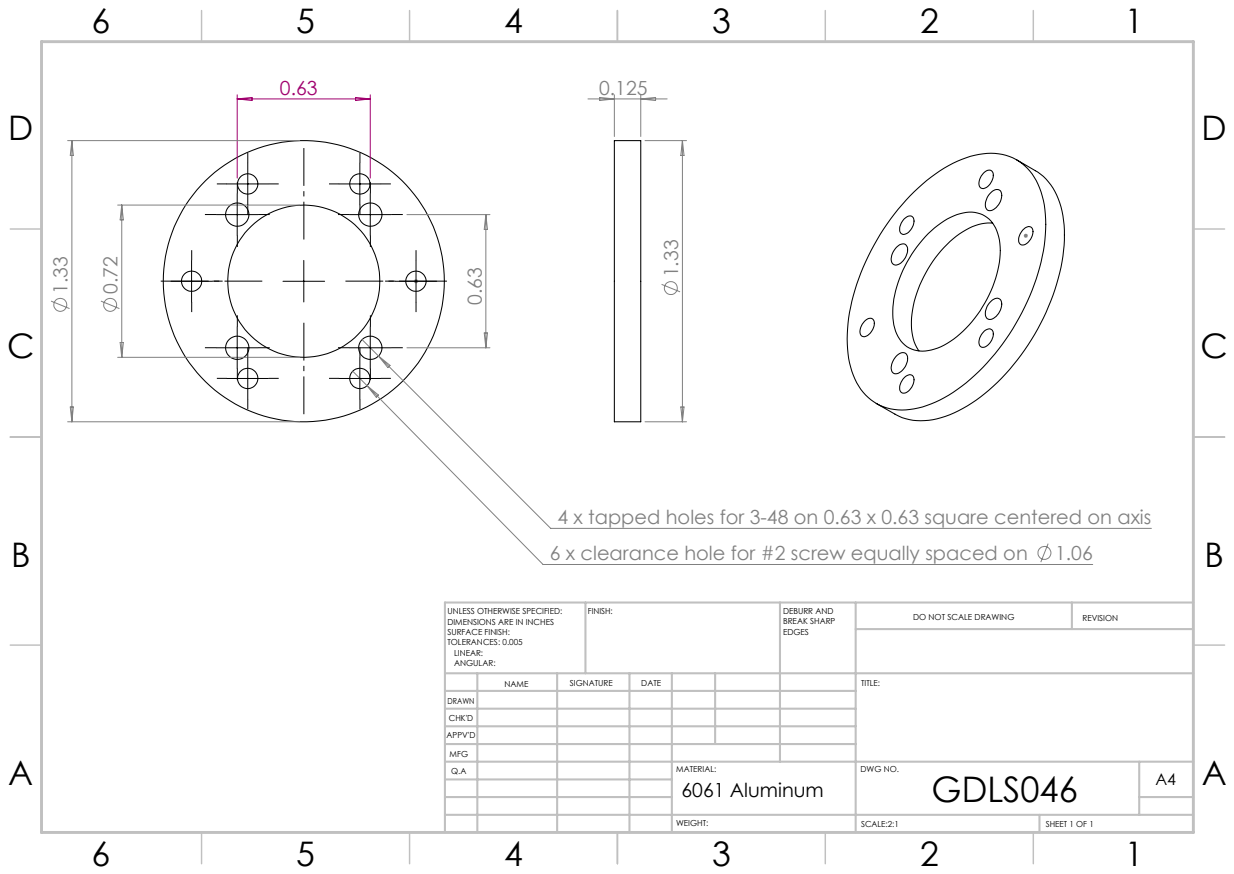
[picture p158: page 1]
6061 Aluminum; FINISH:; DEBURR AND; BREAK SHARP; DO NOT SCALE DRAWING; REVISION; SCALE:2:1; SHEET 1 OF 1

4 x tapped holes for 3-48 on 0.63 x 0.63 square centered on axis
6 x clearance hole for #2 screw equally spaced on 1.06

UNLESS OTHERWISE SPECIFIED:
DIMENSIONS ARE IN INCHES
SURFACE FINISH:
TOLERANCES: 0.005
LINEAR:
ANGULAR:

NAME | SIGNATURE | DATE | | | | TITLE:

DRAWN
CHK'D
APPV'D
MFG
Q.A | | | | MATERIAL: | DWG NO. GDLS046 | A4
