eldarro/radio-isotope-vuv-light-source/Photos/IMG_1509.JPG

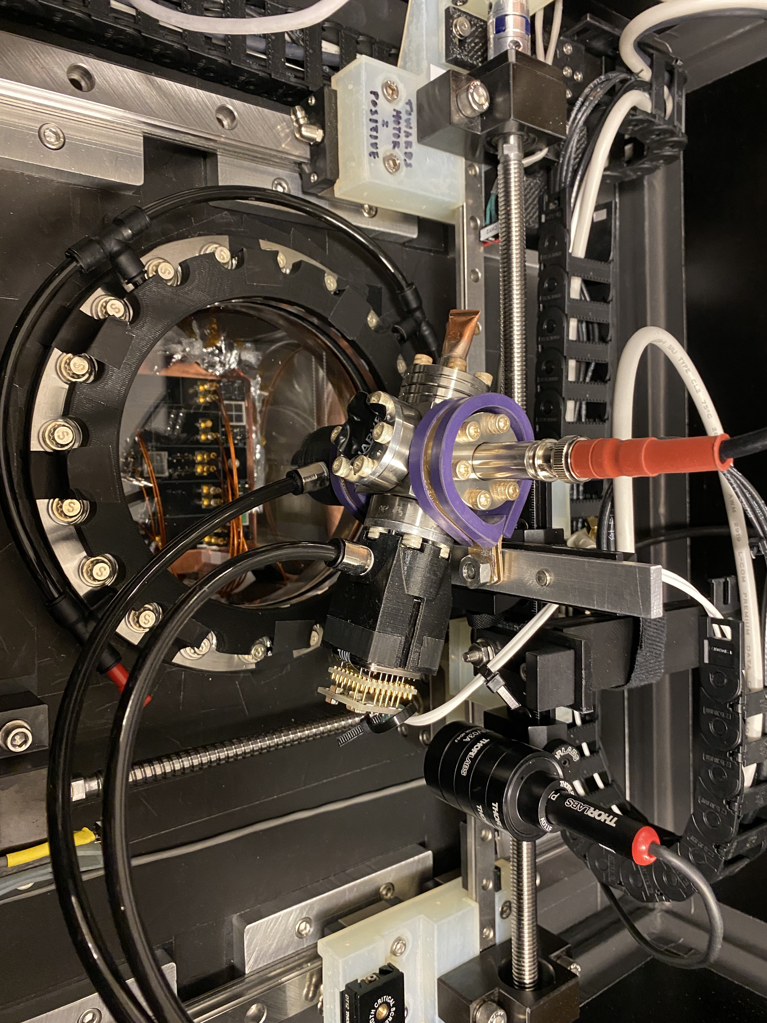
Photos/IMG_1509.JPG
